KOEGlike/meko/hardware/cad/mekov3mockup.FCStd

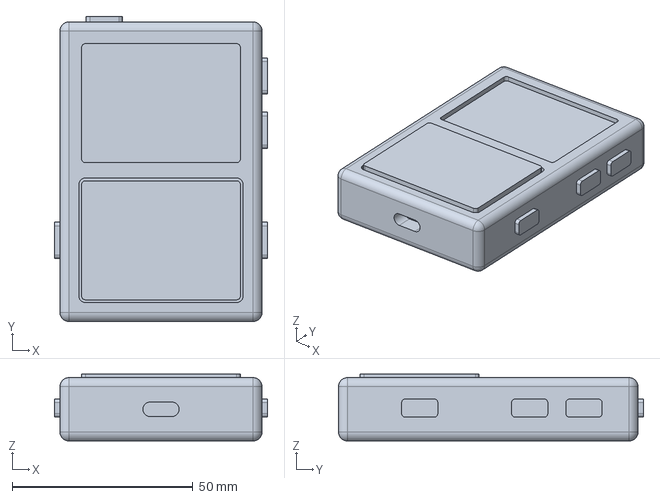
[picture p2: CAD file, 2026-11-12]
hardware/cad/mekov3mockup.FCStd
58.8 x 84.3 x 18.5 mm
