KOEGlike/meko/hardware/pcb_lib/ckl/TF-SMD_L14.8-W14.5-H1.9-P1.1.step

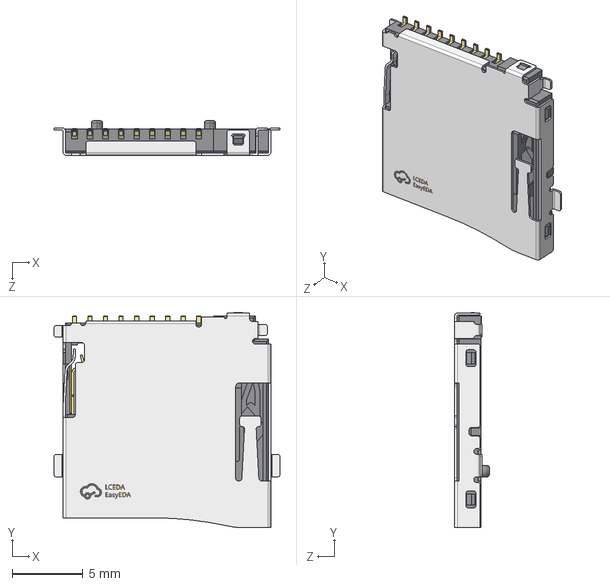
[picture p3: CAD file, 2026-09-19]
hardware/pcb_lib/ckl/TF-SMD_L14.8-W14.5-H1.9-P1.1.step
16.0 x 15.2 x 2.45 mm
