KOEGlike/meko/hardware/pcb_lib/ECMF02-2AMX6/ECMF02-2AMX6.stp

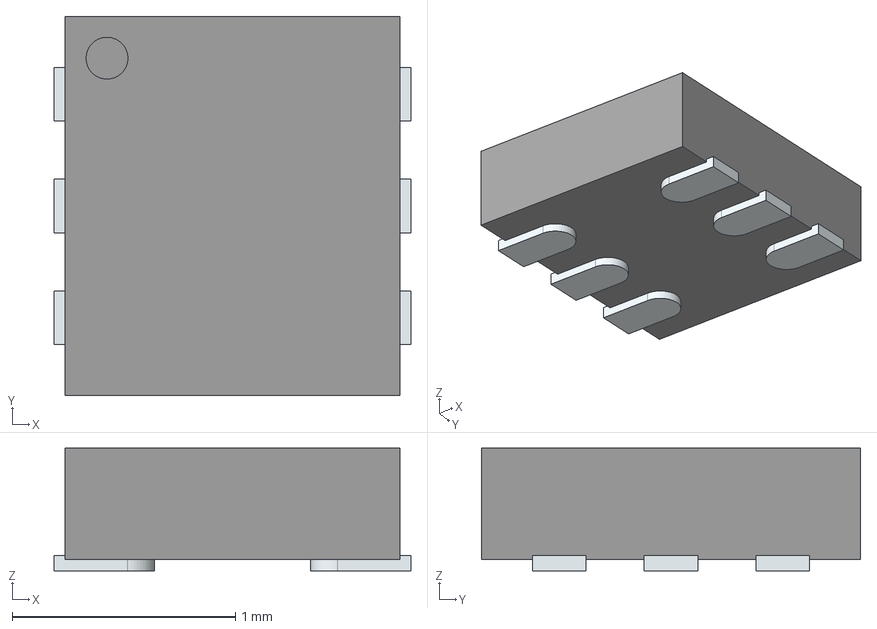
[picture p4: CAD file, 2026-09-22]
hardware/pcb_lib/ECMF02-2AMX6/ECMF02-2AMX6.stp
1.60 x 1.70 x 0.55 mm
PinsArrayLR
