KOEGlike/meko/hardware/pcb_lib/ESD441DPLR/ESD441DPLR.stp

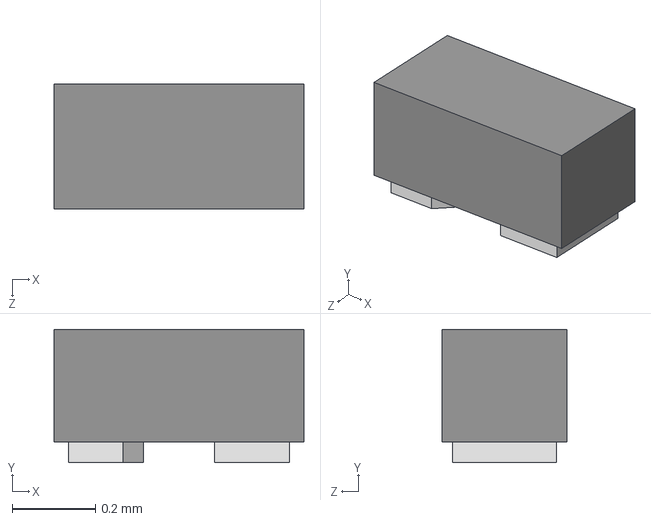
[picture p5: CAD file, 2026-08-08]
hardware/pcb_lib/ESD441DPLR/ESD441DPLR.stp
0.6 x 0.32 x 0.3 mm
