KOEGlike/meko/hardware/pcb_lib/K4E6E304EC-EGCG/FBGA-178_L11.5-W11.0_K4E6E304EC-TL.stp

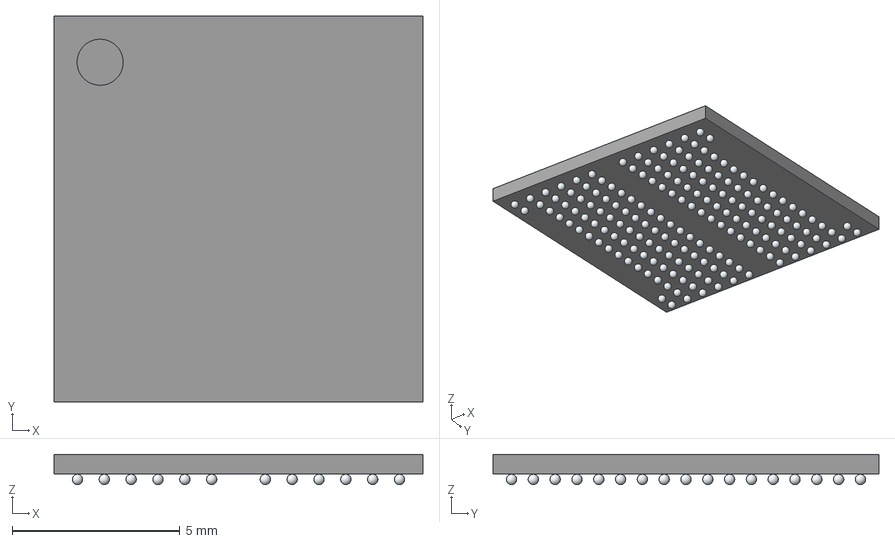
[picture p6: CAD file, 2026-07-20]
hardware/pcb_lib/K4E6E304EC-EGCG/FBGA-178_L11.5-W11.0_K4E6E304EC-TL.stp
11.0 x 11.5 x 0.9 mm
A1
A2
A3
A4
A5
A6
A8
A9
A10
A11
A12
A13
B1
B2
B3
B4
B5
B6
B8
B9
B10
B11
B12
B13
C2
C3
C4
C5
C6
C8
C9
C10
C11
C12
D2
D3
D4
D5
D6
D8
D9
D10
D11
D12
E2
E3
E4
E5
E6
E8
E9
E10
E11
E12
F2
F3
F4
F5
F6
F8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
