KOEGlike/meko/hardware/pcb_lib/LRA/LRA.step

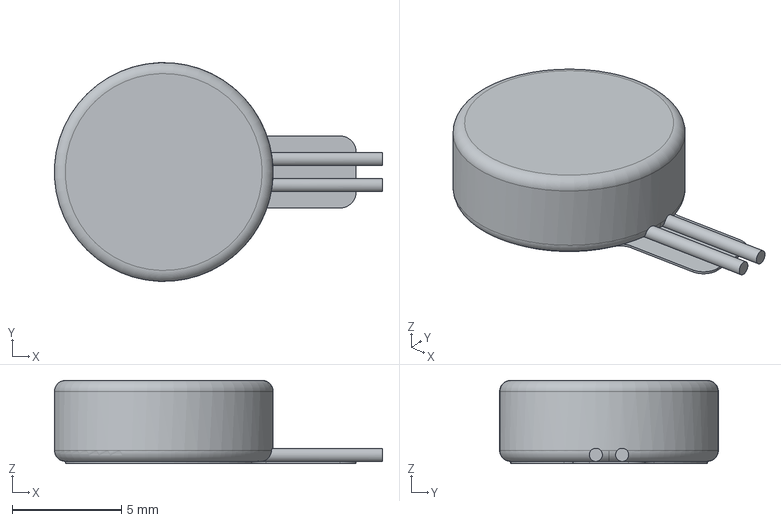
[picture p7: CAD file, 2026-09-26]
hardware/pcb_lib/LRA/LRA.step
15.0 x 10.00 x 3.80 mm
