KOEGlike/meko/hardware/pcb_lib/MAYA-W386-00B/MAYA-W3_Emb-ANT.step

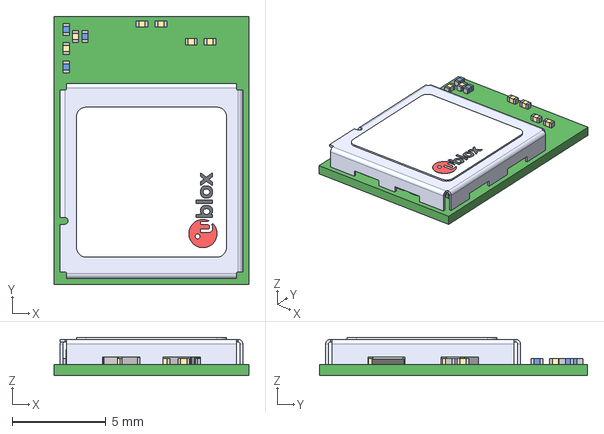
[picture p8: CAD file, 2026-08-22]
hardware/pcb_lib/MAYA-W386-00B/MAYA-W3_Emb-ANT.step
10.4 x 14.3 x 2.05 mm
