KOEGlike/meko/hardware/pcb_lib/MT41K256M16TW/FBGA-96_L14.0-W8.0-H1.1-P0.8.step

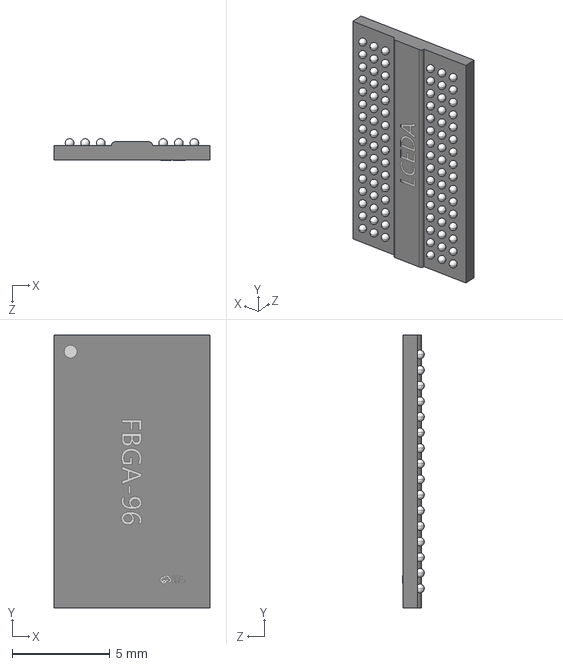
[picture p9: CAD file, 2026-09-19]
hardware/pcb_lib/MT41K256M16TW/FBGA-96_L14.0-W8.0-H1.1-P0.8.step
8.00 x 14.0 x 1.11 mm
