KOEGlike/meko/hardware/pcb_lib/PJ242/AUDIO-SMD_PJ-242_1.step

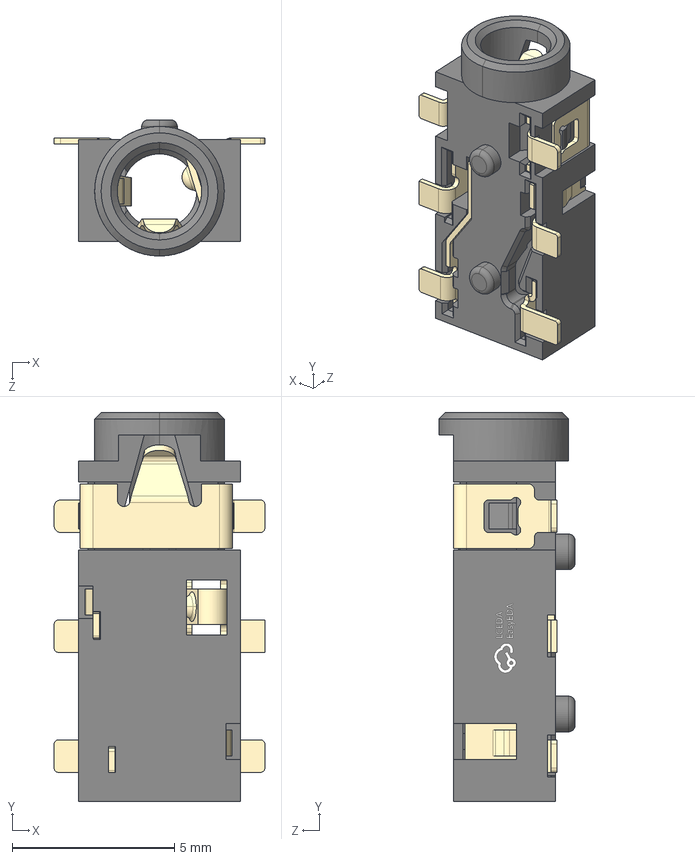
[picture p10: CAD file, 2026-09-17]
hardware/pcb_lib/PJ242/AUDIO-SMD_PJ-242_1.step
6.50 x 12.0 x 4.20 mm
