KOEGlike/meko/hardware/pcb_lib/SAMA7D65-4HB/Microchip_4HB_TFBGA-343_14x14mm_Layout21x21_P0.65mm.step

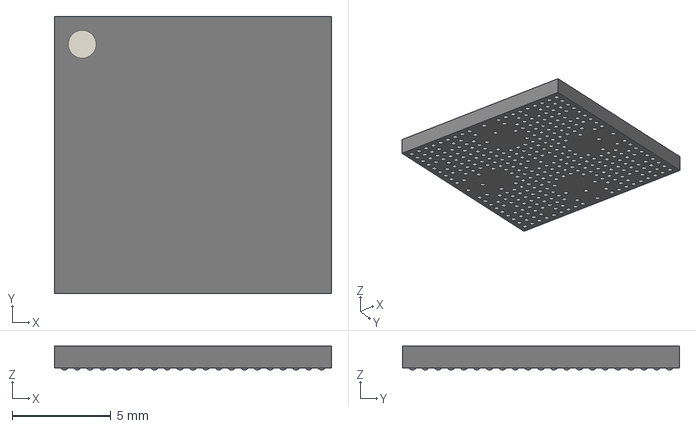
[picture p11: CAD file, 2026-07-15]
hardware/pcb_lib/SAMA7D65-4HB/Microchip_4HB_TFBGA-343_14x14mm_Layout21x21_P0.65mm.step
14.0 x 14.0 x 1.21 mm
