KOEGlike/meko/hardware/pcb_lib/SKRTLAE010/KEY-SMD_L4.6-W3.4-H3.4.step

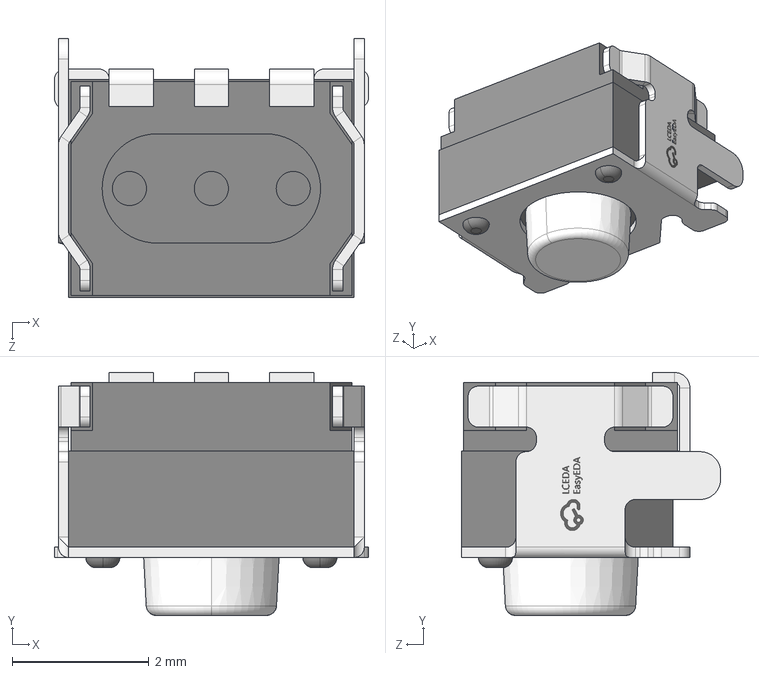
[picture p12: CAD file, 2026-09-17]
hardware/pcb_lib/SKRTLAE010/KEY-SMD_L4.6-W3.4-H3.4.step
4.60 x 3.56 x 3.80 mm
