KOEGlike/meko/hardware/pcb_lib/TPD2S300/TPD2S300YFFR.stp

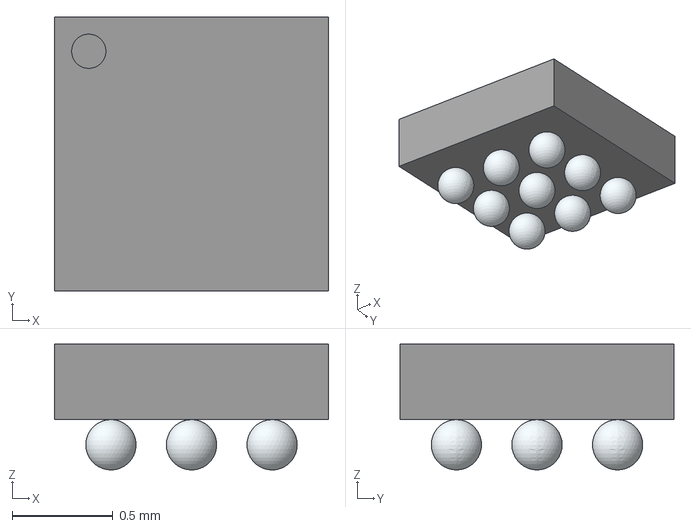
[picture p13: CAD file, 2026-08-08]
hardware/pcb_lib/TPD2S300/TPD2S300YFFR.stp
1.36 x 1.36 x 0.625 mm
