KOEGlike/meko/hardware/cad/touchpad.step

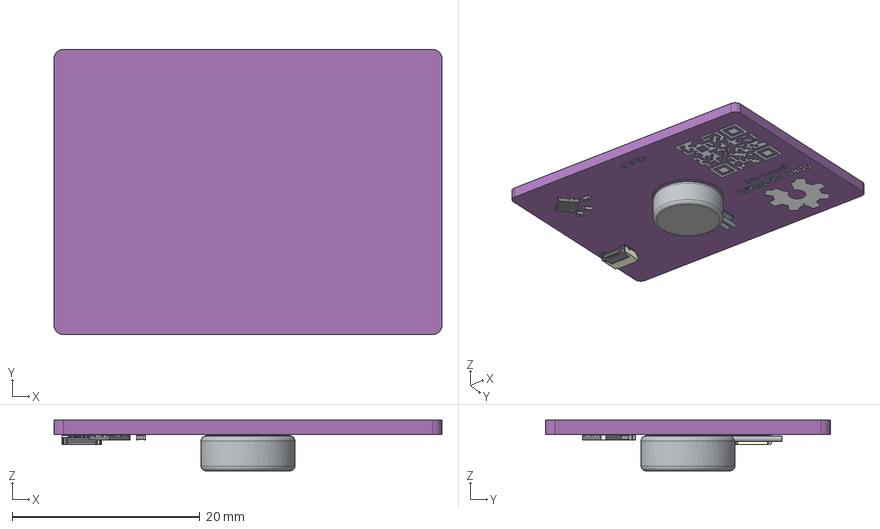
[picture p14: CAD file, 2026-11-12]
hardware/cad/touchpad.step
41.3 x 30.4 x 5.40 mm
UQFN-20-1EP_3x3mm_Pitch0.4mm
C_0402_1005Metric x 3
503480-xxxx_05
touchpad_silkscreen
touchpad_PCB
