KOEGlike/meko/hardware/pcb_lib/ckl/TF-SMD_TF-008.step

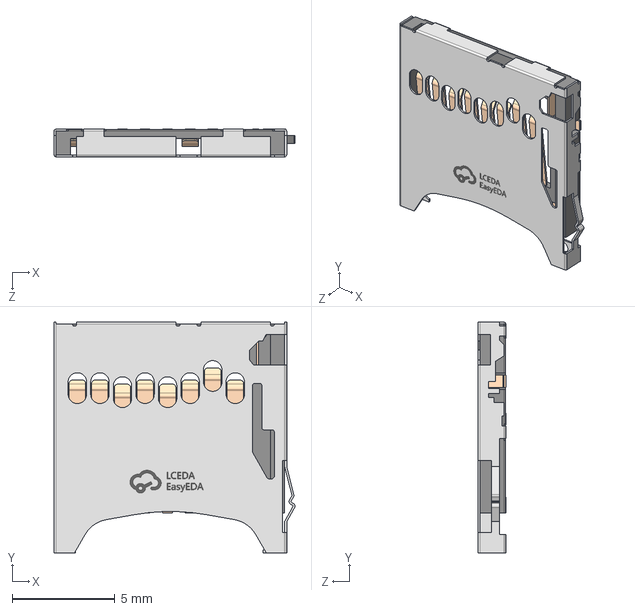
[picture p15: CAD file, 2026-09-19]
hardware/pcb_lib/ckl/TF-SMD_TF-008.step
11.7 x 11.3 x 1.35 mm
