KOEGlike/meko/hardware/pcb_lib/ckl/AUDIO-SMD_PJ-342-141.step

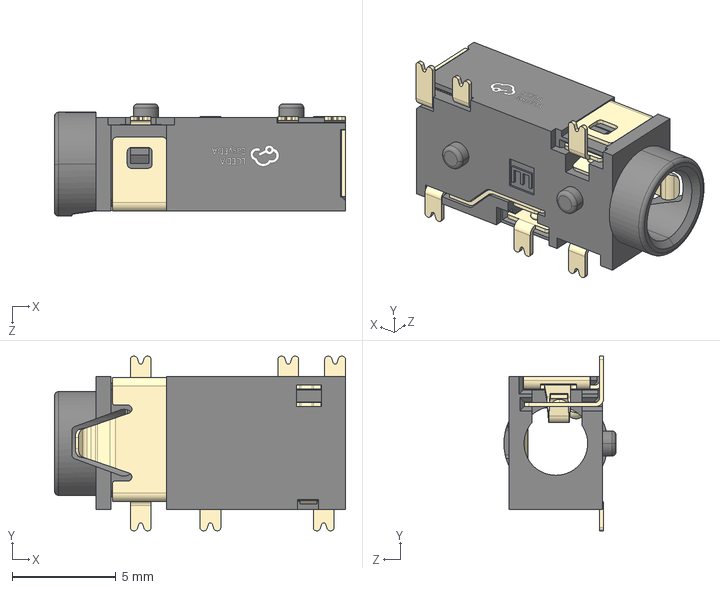
[picture p16: CAD file, 2026-09-18]
hardware/pcb_lib/ckl/AUDIO-SMD_PJ-342-141.step
14.0 x 8.40 x 5.40 mm
