KOEGlike/meko/hardware/pcb_lib/ckl/USB_C_Receptacle_HRO_TYPE-C-31-M-12.step

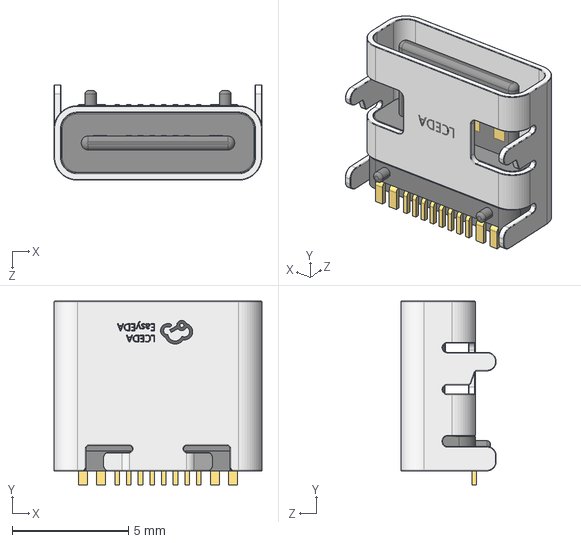
[picture p17: CAD file, 2026-09-18]
hardware/pcb_lib/ckl/USB_C_Receptacle_HRO_TYPE-C-31-M-12.step
8.94 x 7.90 x 4.10 mm
