KOEGlike/meko/hardware/pcb_lib/503480-0540/503480-0540.step

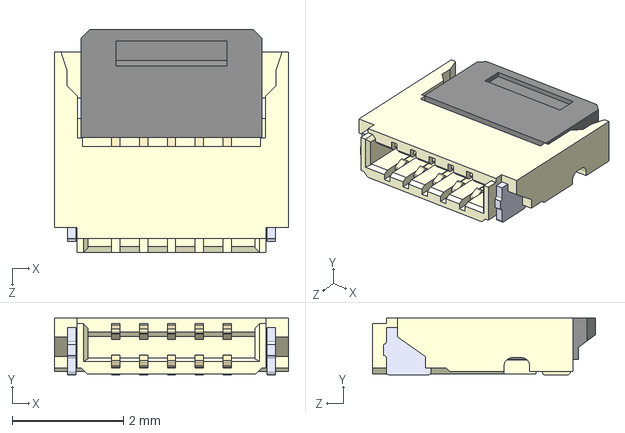
[picture p18: CAD file, 2026-09-20]
hardware/pcb_lib/503480-0540/503480-0540.step
4.20 x 1.02 x 4.00 mm
