KOEGlike/meko/(list of files, cad)

Other CAD files:
hardware/cad/meko.step
hardware/cad/meko.FCStd
hardware/mekov3mockup.FCStd
hardware/pcb_lib/503480-1000/5034801000_0.stp
hardware/pcb_lib/BQ25640/BQ25640VDLR.stp
hardware/pcb_lib/LRA/lra.FCStd
meko-blend/meko.blend
