KOEGlike/meko/hardware/pcb/meko.kicad_pcb

## KiCad design hardware/pcb/meko.kicad_pcb (2026-11-14)

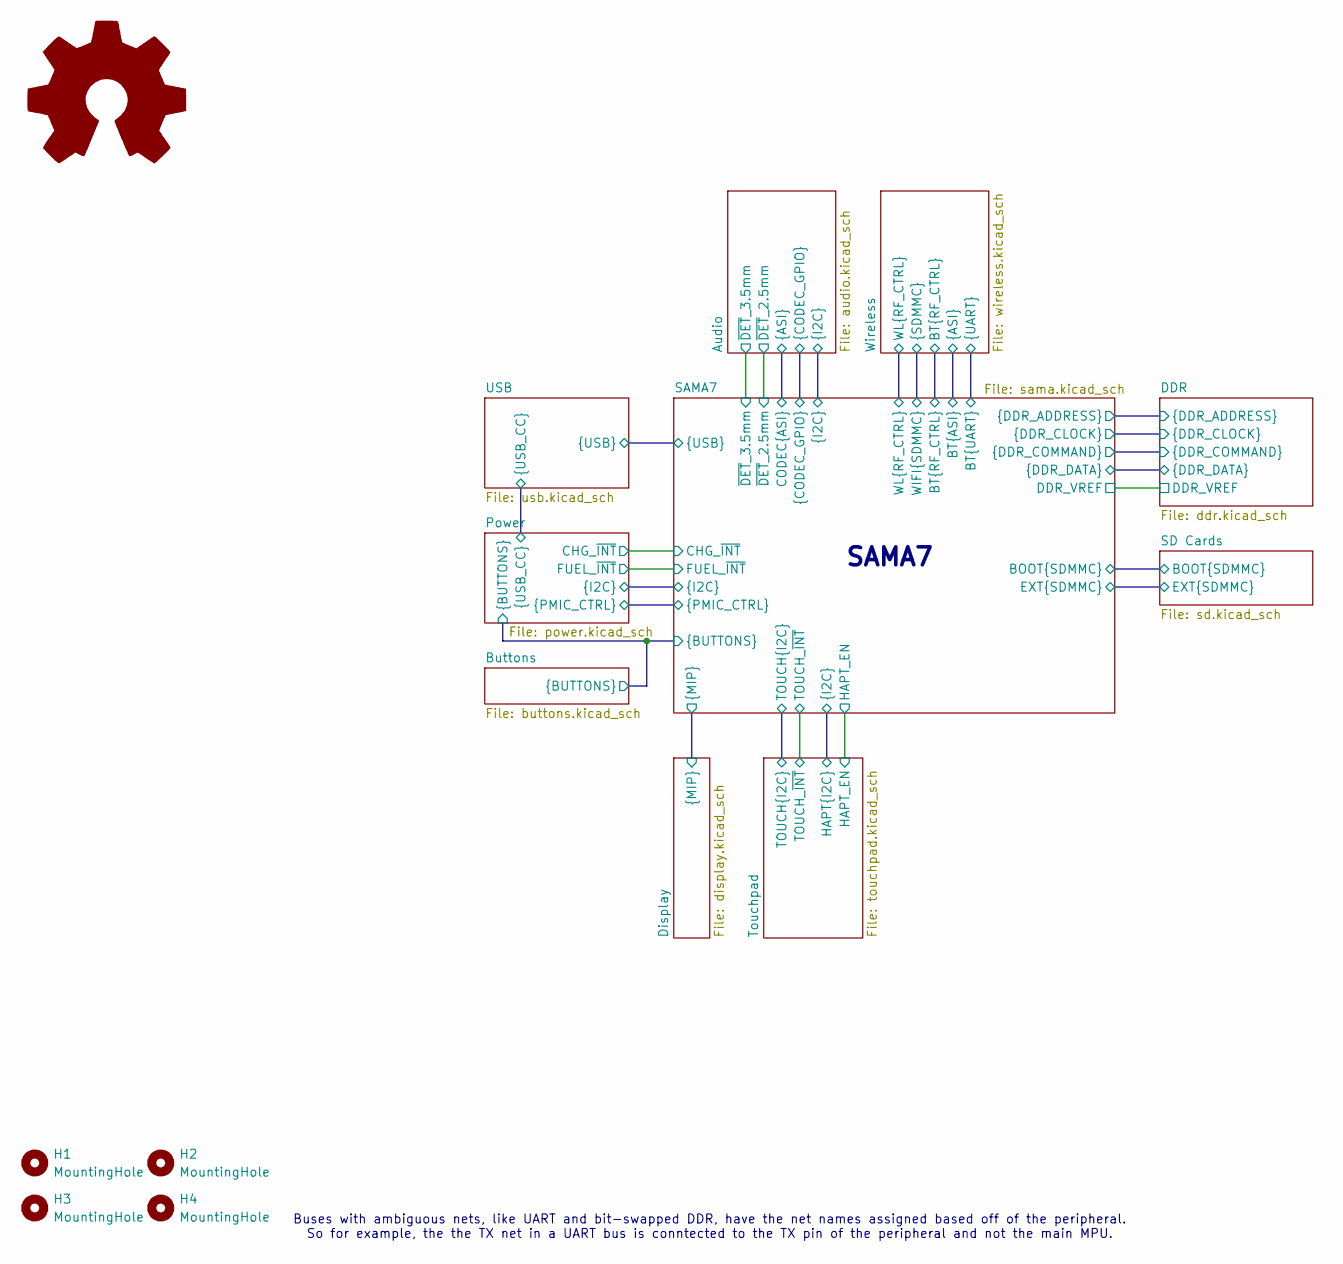
[picture p21: schematic meko.kicad_sch, Overview]

Parts:
H1, H2, H3, H4: MountingHole; MountingHole_2.2mm_M2
SYM1: Logo_Open_Hardware_Large; OSHW-Logo2_9.8x8mm_SilkScreen

Notes on the sheet:
Buses with ambiguous nets, like UART and bit-swapped DDR, have the net names assigned based off of the peripheral. So for example, the the TX net in a UART bus is conntected to the TX pin of the peripheral and not the main MPU.
SAMA7

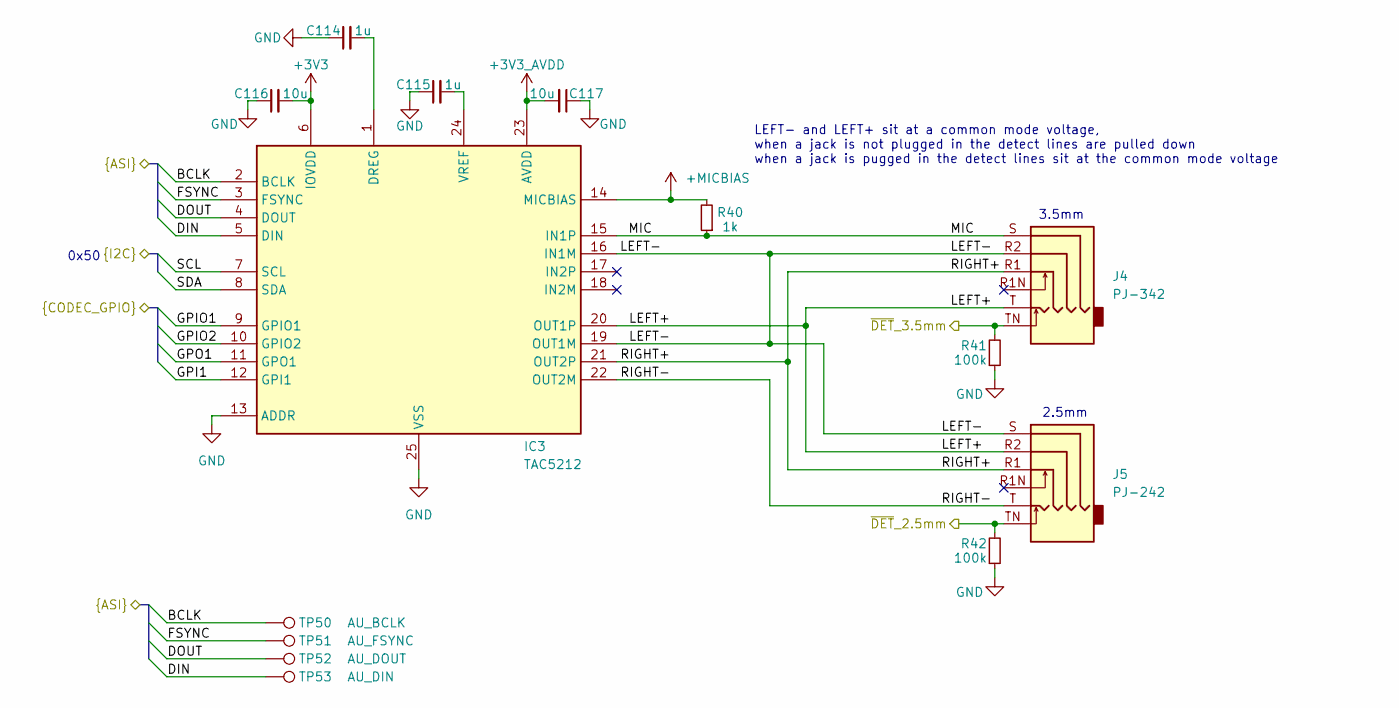
[picture p22: schematic audio.kicad_sch]

Parts:
C114, C115: 1u; C_0402_1005Metric
C116, C117: 10u; C_0402_1005Metric
IC3: TAC5212; VQFN-24-1EP_4x4mm_P0.5mm_EP2.45x2.45mm
J4: PJ-342; Jack_3.5mm_SHOUHAN_PJ-342; LCSC C668606
J5: PJ-242; Jack_2.5mm_PJ242_6P_12x6.2x4mm_Horizontal; LCSC C431536
R40: 1k; R_0402_1005Metric
R41, R42: 100k; R_0402_1005Metric
TP50: AU_BCLK; TestPoint_Pad_D1.0mm
TP51: AU_FSYNC; TestPoint_Pad_D1.0mm
TP52: AU_DOUT; TestPoint_Pad_D1.0mm
TP53: AU_DIN; TestPoint_Pad_D1.0mm

Connections:
+3V3: C116.2, IC3.6 (IOVDD); also elsewhere on the board
+3V3_AVDD: C117.2, IC3.23 (AVDD); also elsewhere on the board
+MICBIAS: IC3.14 (MICBIAS), R40.2
/Audio/BCLK: IC3.2 (BCLK), TP50.1 (1_1); also elsewhere on the board
/Audio/DIN: IC3.5 (DIN), TP53.1 (1_1); also elsewhere on the board
/Audio/DOUT: IC3.4 (DOUT), TP52.1 (1_1); also elsewhere on the board
/Audio/FSYNC: IC3.3 (FSYNC), TP51.1 (1_1); also elsewhere on the board
/Audio/GPI1: IC3.12 (GPI1); also elsewhere on the board
/Audio/GPIO1: IC3.9 (GPIO1); also elsewhere on the board
/Audio/GPIO2: IC3.10 (GPIO2); also elsewhere on the board
/Audio/GPO1: IC3.11 (GPO1); also elsewhere on the board
/Audio/LEFT+: IC3.20 (OUT1P), J4.T, J5.R2
/Audio/LEFT-: IC3.16 (IN1M), IC3.19 (OUT1M), J4.R2, J5.S
/Audio/MIC: IC3.15 (IN1P), J4.S, R40.1
/Audio/RIGHT+: IC3.21 (OUT2P), J4.R1, J5.R1
/Audio/RIGHT-: IC3.22 (OUT2M), J5.T
/Audio/SCL: IC3.7 (SCL); also elsewhere on the board
/Audio/SDA: IC3.8 (SDA); also elsewhere on the board
/Audio/~DET_2.5mm: J5.TN, R42.2; also elsewhere on the board
/Audio/~DET_3.5mm: J4.TN, R41.2; also elsewhere on the board
GND: C114.1, C115.1, C116.1, C117.1, IC3.13 (ADDR), IC3.25 (VSS), R41.1, R42.1; also elsewhere on the board
unnamed: C114.2, IC3.1 (DREG)
unnamed: C115.2, IC3.24 (VREF)

Notes on the sheet:
3.5mm
LEFT- and LEFT+ sit at a common mode voltage, when a jack is not plugged in the detect lines are pulled down when a jack is pugged in the detect lines sit at the common mode voltage
2.5mm
0x50

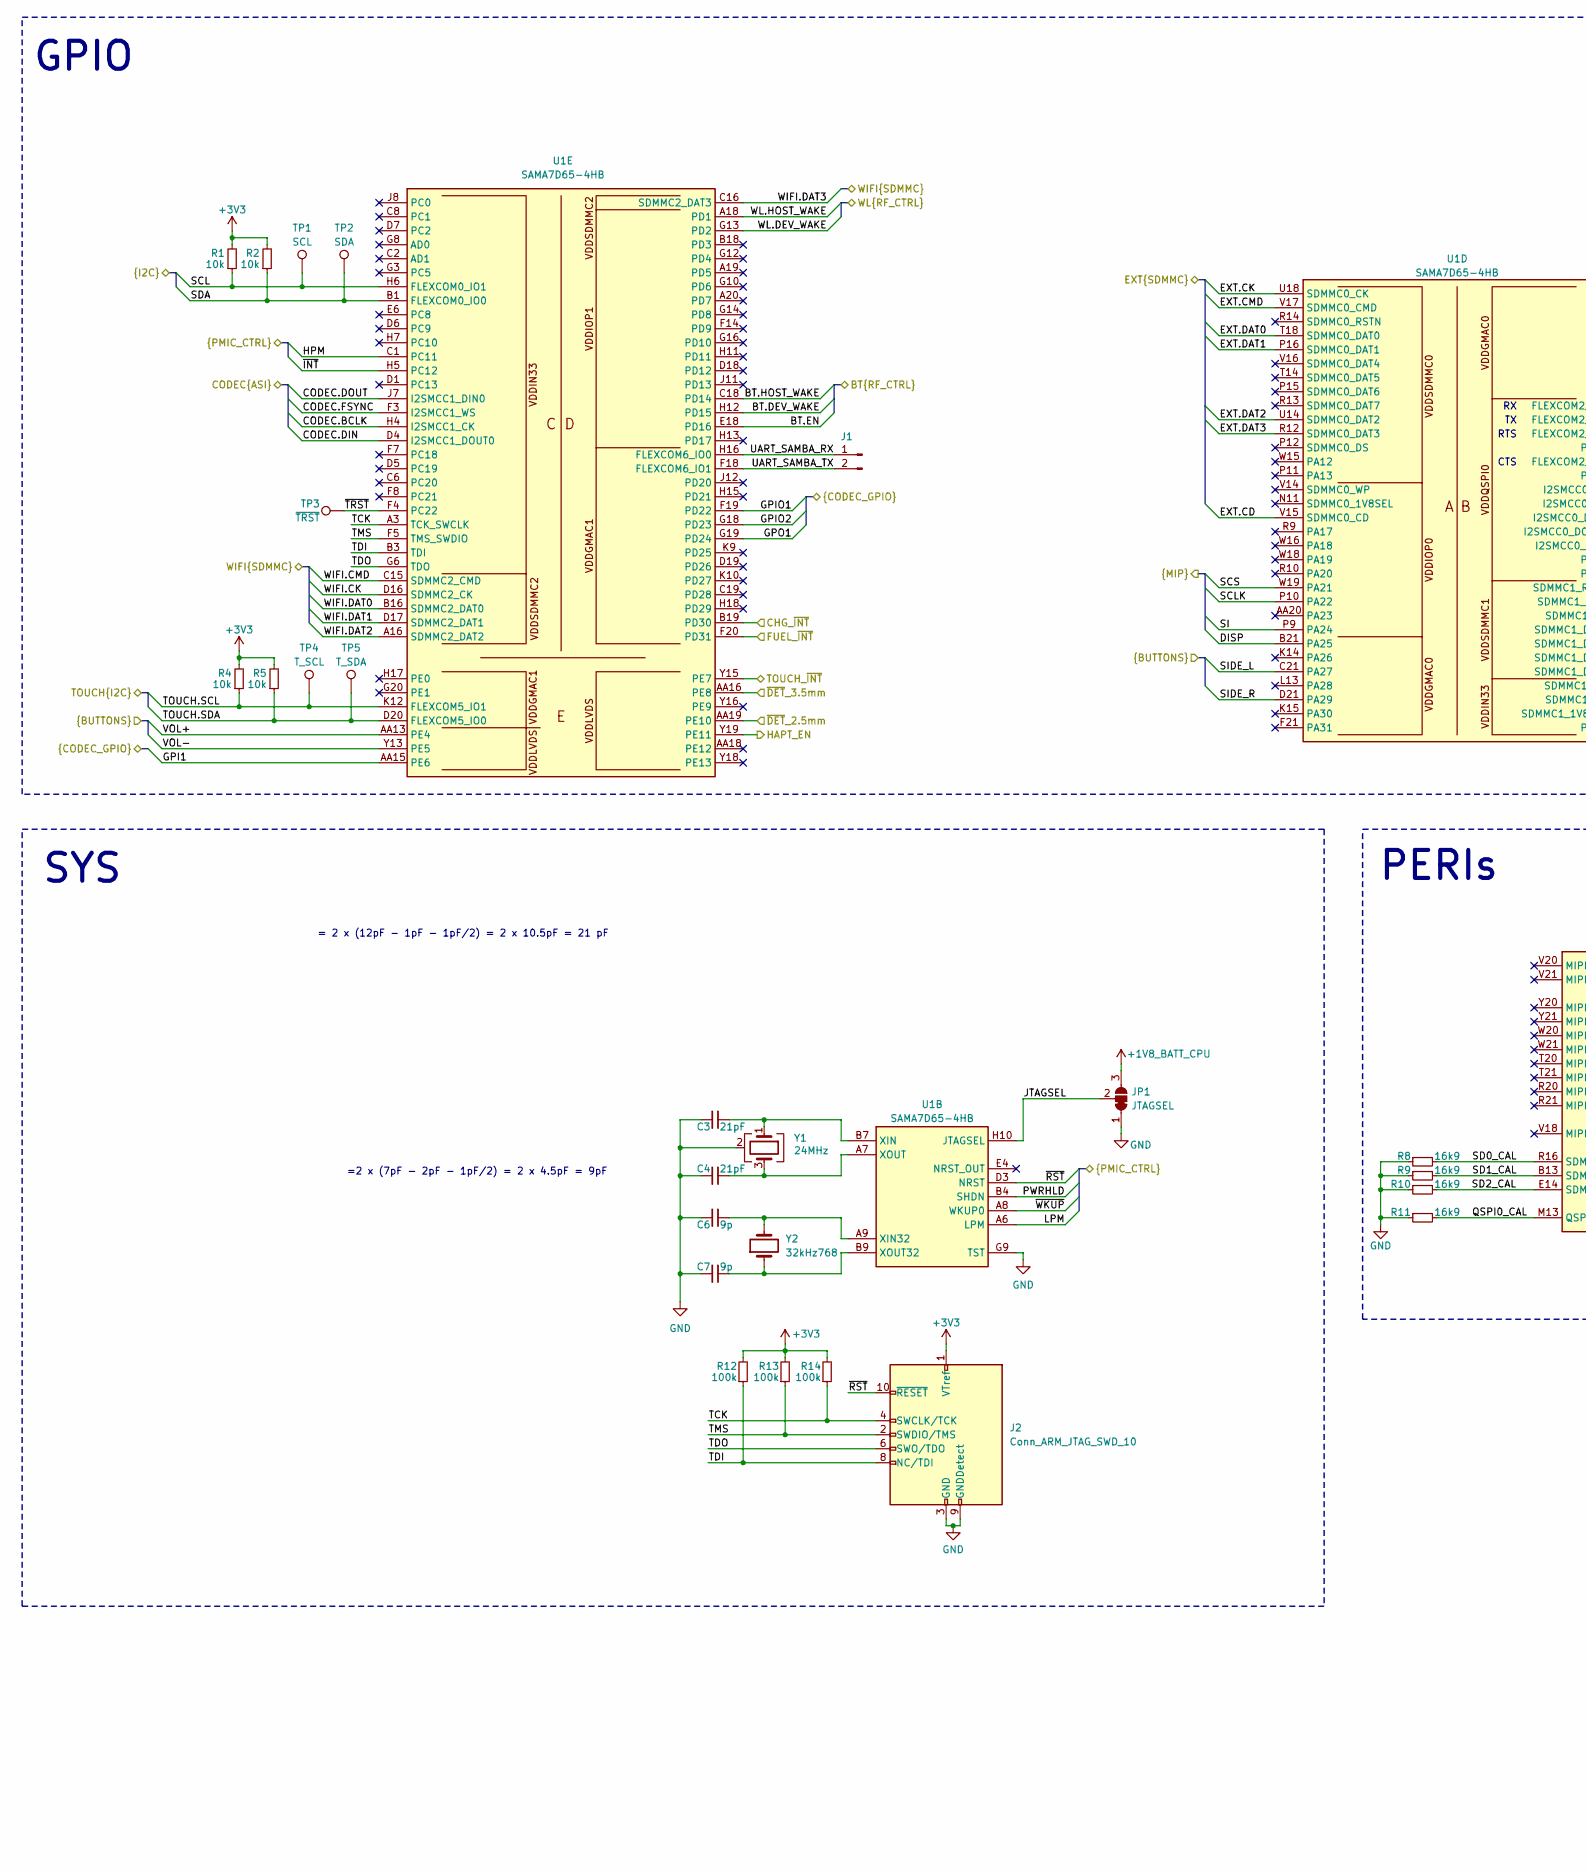
[picture p23: schematic sama.kicad_sch, SAMA7, part in row 1, column 1]

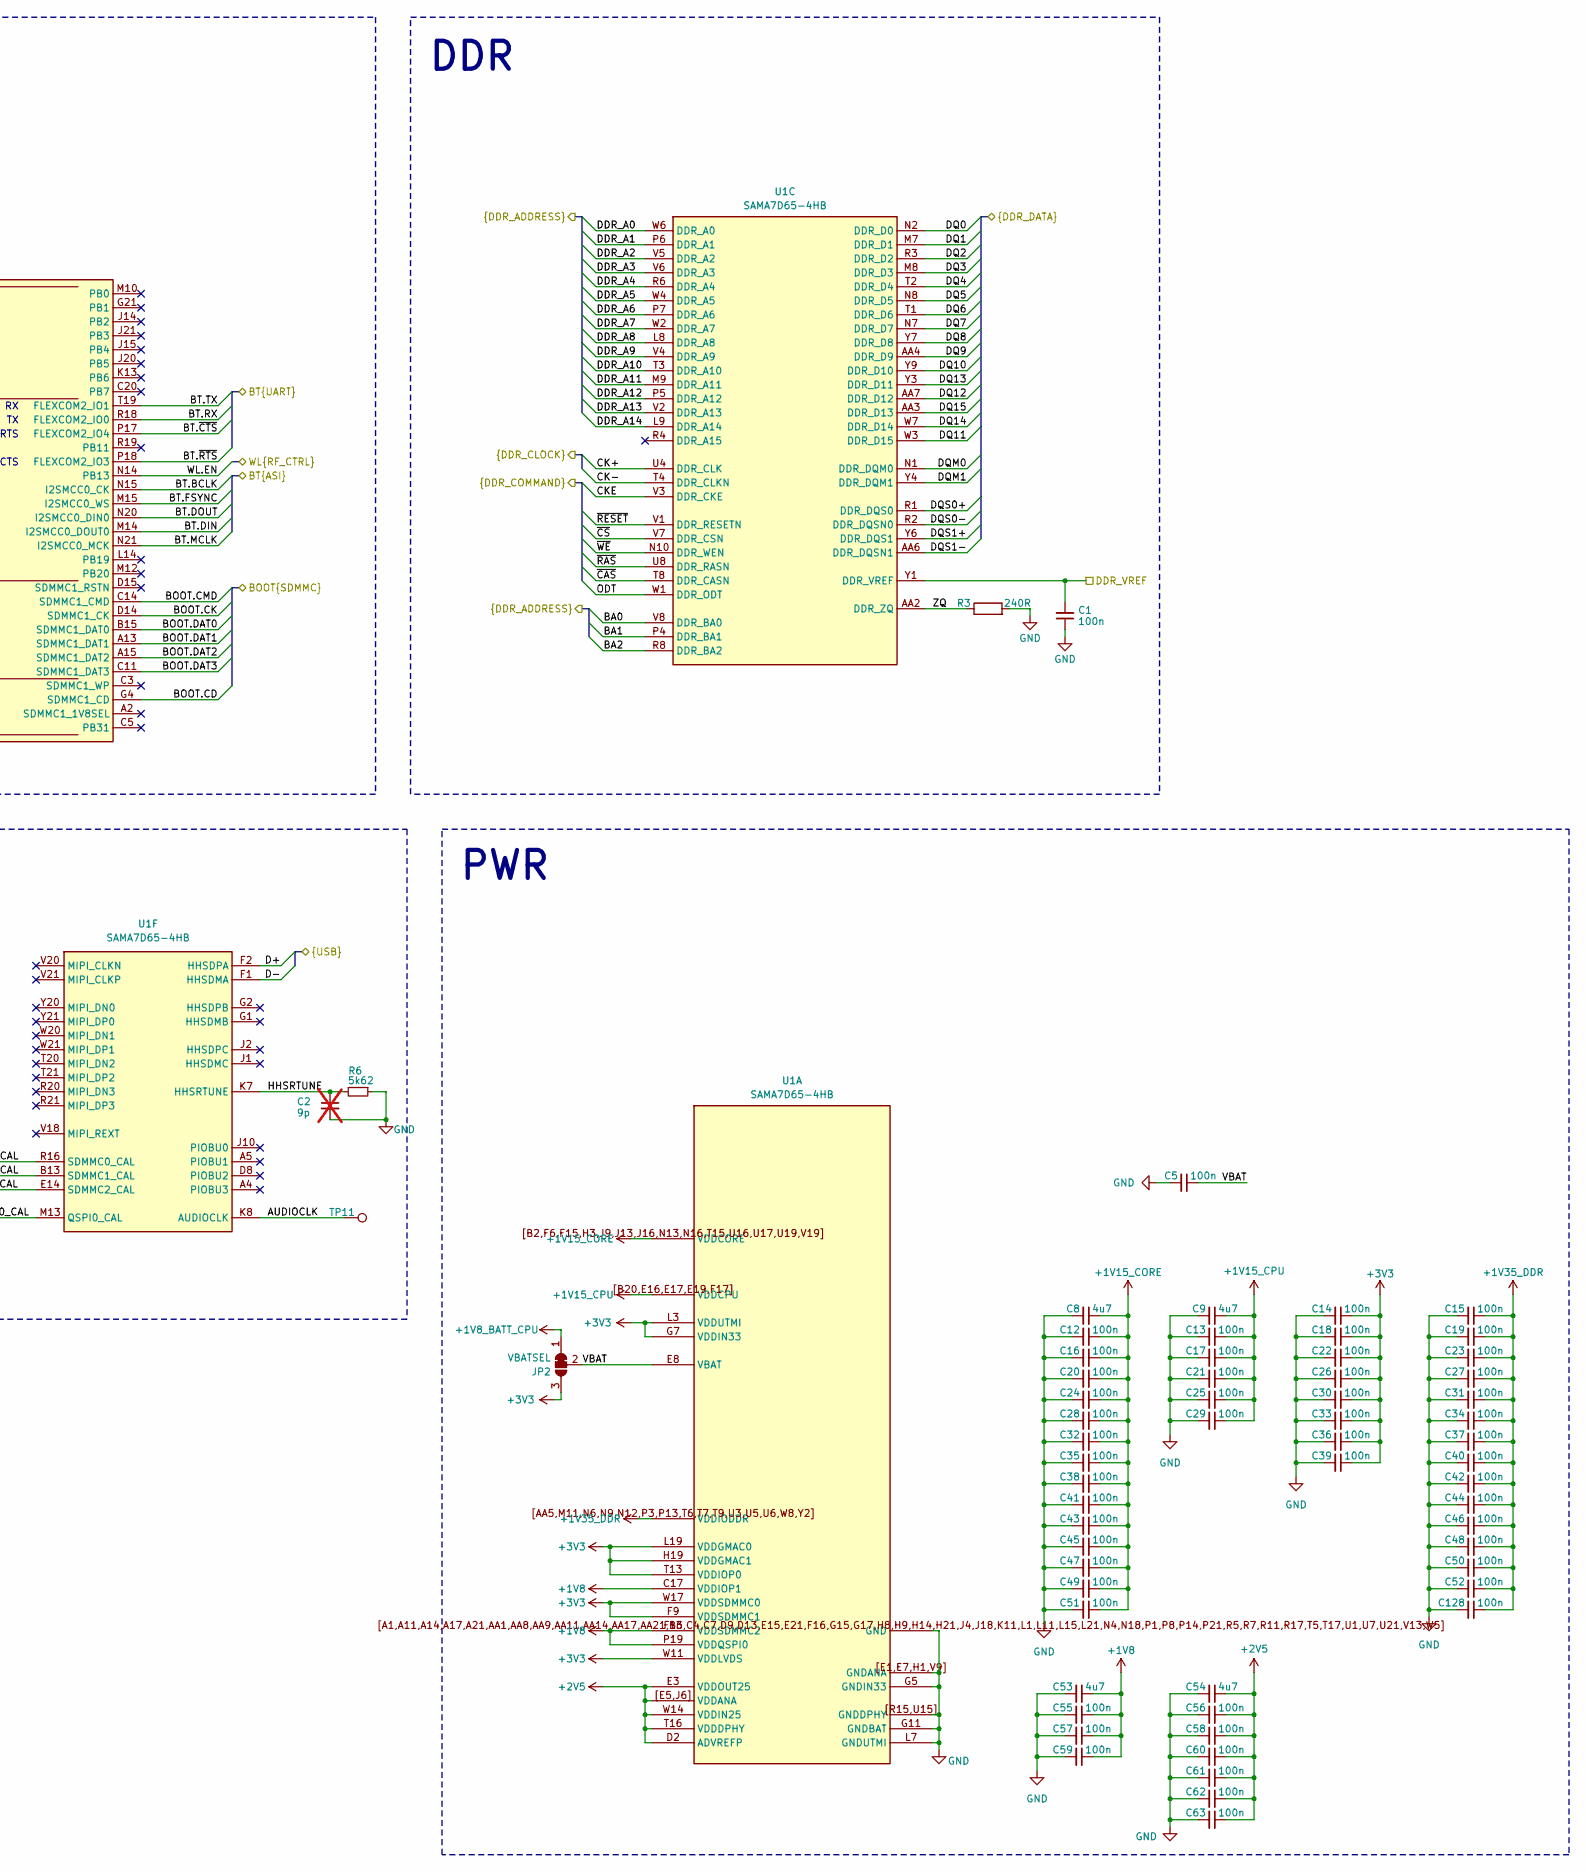
[picture p24: schematic sama.kicad_sch, SAMA7, part in row 1, column 2]

Parts:
C1, C12, C15, C16, C18, C19, C20, C21, C22, C26, C28, C29, C30, C31, C39, C40, C43, C44, C46, C48, C51, C55, C56, C57, C59, C60, C62, C63, C128: 100n; C_0201_0603Metric
C2: 9p; C_0201_0603Metric; not fitted
C3, C4: 21pF; C_0201_0603Metric
C5, C13, C14, C17, C23, C24, C25, C27, C32, C33, C34, C35, C36, C37, C38, C41, C42, C45, C47, C49, C50, C52, C58, C61: 100n; C_0201_0603Metric_Dense
C6, C7: 9p; C_0201_0603Metric
C8, C9, C53, C54: 4u7; C_0402_1005Metric
J1: Conn_01x02_Pin; PinHeader_1x02_P2.54mm_Vertical
J2: Conn_ARM_JTAG_SWD_10; PinHeader_2x05_P1.27mm_Vertical
JP1: JTAGSEL; SolderJumper-3_P1.3mm_Bridged12_RoundedPad1.0x1.5mm
JP2: VBATSEL; SolderJumper-3_P1.3mm_Bridged12_RoundedPad1.0x1.5mm
R1, R2, R4, R5: 10k; R_0402_1005Metric
R3: 240R; R_0201_0603Metric
R6: 5k62; R_0201_0603Metric
R8, R9, R10, R11: 16k9; R_0201_0603Metric
R12, R13, R14: 100k; R_0402_1005Metric
TP1: SCL; TestPoint_Pad_D1.0mm
TP2: SDA; TestPoint_Pad_D1.0mm
TP3: ~{TRST}; TestPoint_Pad_D1.0mm
TP4: T_SCL; TestPoint_Pad_D1.0mm
TP5: T_SDA; TestPoint_Pad_D1.0mm
TP11: AUDIOCLK; TestPoint_Pad_D1.0mm
U1: SAMA7D65-4HB; Microchip_4HB_TFBGA-343_14x14mm_Layout21x21_P0.65mm
Y1: 24MHz; Crystal_SMD_3225-4Pin_3.2x2.5mm; MPN SX32Y024000BC1T001; LCSC C7420736
Y2: 32kHz768; Crystal_SMD_MicroCrystal_CC7V-T1A-2Pin_3.2x1.5mm; MPN SC-32S32.768kHz20PPM7pF

Connections:
+1V8: C53.1, C55.1, C57.1, C59.1, U1.C17 (VDDIOP1), U1.F13 (VDDSDMMC2), U1.P19 (VDDQSPI0); also elsewhere on the board
+1V8_BATT_CPU: JP1.3 (B), JP2.1 (A); also elsewhere on the board
+1V15_CORE: C8.1, C12.1, C16.1, C20.1, C24.1, C28.1, C32.1, C35.1, C38.1, C41.1, C43.1, C45.1, C47.1, C49.1, C51.1, U1.B2 (VDDCORE), U1.F6 (VDDCORE), U1.F15 (VDDCORE), U1.H3 (VDDCORE), U1.J9 (VDDCORE), U1.J13 (VDDCORE), U1.J16 (VDDCORE), U1.N13 (VDDCORE), U1.N16 (VDDCORE), U1.T15 (VDDCORE), U1.U16 (VDDCORE), U1.U17 (VDDCORE), U1.U19 (VDDCORE), U1.V19 (VDDCORE), U1.[B2,F6,F15,H3,J9,J1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 (VDDCORE); also elsewhere on the board
+1V15_CPU: C9.1, C13.1, C17.1, C21.1, C25.1, C29.1, U1.B20 (VDDCPU), U1.E16 (VDDCPU), U1.E17 (VDDCPU), U1.E19 (VDDCPU), U1.F17 (VDDCPU), U1.[B20,E16,E17,E19,F1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 (VDDCPU); also elsewhere on the board
+1V35_DDR: C15.1, C19.1, C23.1, C27.1, C31.1, C34.1, C37.1, C40.1, C42.1, C44.1, C46.1, C48.1, C50.1, C52.1, C128.1, U1.AA5 (VDDIODDR), U1.M11 (VDDIODDR), U1.N6 (VDDIODDR), U1.N9 (VDDIODDR), U1.N12 (VDDIODDR), U1.P3 (VDDIODDR), U1.P13 (VDDIODDR), U1.T6 (VDDIODDR), U1.T7 (VDDIODDR), U1.T9 (VDDIODDR), U1.U3 (VDDIODDR), U1.U5 (VDDIODDR), U1.U6 (VDDIODDR), U1.W8 (VDDIODDR), U1.Y2 (VDDIODDR), U1.[AA5,M11,N6,N9,N12,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 (VDDIODDR); also elsewhere on the board
+2V5: C54.1, C56.1, C58.1, C60.1, C61.1, C62.1, C63.1, U1.D2 (ADVREFP), U1.E3 (VDDOUT25), U1.E5 (VDDANA), U1.J6 (VDDANA), U1.T16 (VDDDPHY), U1.W14 (VDDIN25), U1.[E5,J6] (VDDANA)
+3V3: C14.1, C18.1, C22.1, C26.1, C30.1, C33.1, C36.1, C39.1, J2.1 (VTref), JP2.3 (B), R1.2, R2.2, R4.2, R5.2, R12.2, R13.2, R14.2, U1.F9 (VDDSDMMC1), U1.G7 (VDDIN33), U1.H19 (VDDGMAC1), U1.L3 (VDDUTMI), U1.L19 (VDDGMAC0), U1.T13 (VDDIOP0), U1.W11 (VDDLVDS), U1.W17 (VDDSDMMC0); also elsewhere on the board
/Audio/BCLK: U1.H4 (I2SMCC1_CK); also elsewhere on the board
/Audio/DIN: U1.D4 (I2SMCC1_DOUT0); also elsewhere on the board
/Audio/DOUT: U1.J7 (I2SMCC1_DIN0); also elsewhere on the board
/Audio/FSYNC: U1.F3 (I2SMCC1_WS); also elsewhere on the board
/Audio/GPI1: U1.AA15 (PE6); also elsewhere on the board
/Audio/GPIO1: U1.F19 (PD22); also elsewhere on the board
/Audio/GPIO2: U1.G18 (PD23); also elsewhere on the board
/Audio/GPO1: U1.G19 (PD24); also elsewhere on the board
/Audio/SCL: R1.1, TP1.1 (1_1), U1.H6 (FLEXCOM0_IO1); also elsewhere on the board
/Audio/SDA: R2.1, TP2.1 (1_1), U1.B1 (FLEXCOM0_IO0); also elsewhere on the board
/Audio/~DET_2.5mm: U1.AA19 (PE10); also elsewhere on the board
/Audio/~DET_3.5mm: U1.AA16 (PE8); also elsewhere on the board
/Buttons/SIDE_L: U1.C21 (PA27); also elsewhere on the board
/Buttons/SIDE_R: U1.D21 (PA29); also elsewhere on the board
/Buttons/VOL+: U1.AA13 (PE4); also elsewhere on the board
/Buttons/VOL-: U1.Y13 (PE5); also elsewhere on the board
/DDR/BA0: U1.V8 (DDR_BA0); also elsewhere on the board
/DDR/BA1: U1.P4 (DDR_BA1); also elsewhere on the board
/DDR/BA2: U1.R8 (DDR_BA2); also elsewhere on the board
/DDR/CK+: U1.U4 (DDR_CLK); also elsewhere on the board
/DDR/CK-: U1.T4 (DDR_CLKN); also elsewhere on the board
/DDR/CKE: U1.V3 (DDR_CKE); also elsewhere on the board
/DDR/DDR_A0: U1.W6 (DDR_A0); also elsewhere on the board
/DDR/DDR_A1: U1.P6 (DDR_A1); also elsewhere on the board
/DDR/DDR_A2: U1.V5 (DDR_A2); also elsewhere on the board
/DDR/DDR_A3: U1.V6 (DDR_A3); also elsewhere on the board
/DDR/DDR_A4: U1.R6 (DDR_A4); also elsewhere on the board
/DDR/DDR_A5: U1.W4 (DDR_A5); also elsewhere on the board
/DDR/DDR_A6: U1.P7 (DDR_A6); also elsewhere on the board
/DDR/DDR_A7: U1.W2 (DDR_A7); also elsewhere on the board
/DDR/DDR_A8: U1.L8 (DDR_A8); also elsewhere on the board
/DDR/DDR_A9: U1.V4 (DDR_A9); also elsewhere on the board
/DDR/DDR_A10: U1.T3 (DDR_A10); also elsewhere on the board
/DDR/DDR_A11: U1.M9 (DDR_A11); also elsewhere on the board
/DDR/DDR_A12: U1.P5 (DDR_A12); also elsewhere on the board
/DDR/DDR_A13: U1.V2 (DDR_A13); also elsewhere on the board
/DDR/DDR_A14: U1.L9 (DDR_A14); also elsewhere on the board
/DDR/DDR_VREF: C1.2, U1.Y1 (DDR_VREF); also elsewhere on the board
/DDR/DQ0: U1.N2 (DDR_D0); also elsewhere on the board
/DDR/DQ1: U1.M7 (DDR_D1); also elsewhere on the board
/DDR/DQ2: U1.R3 (DDR_D2); also elsewhere on the board
/DDR/DQ3: U1.M8 (DDR_D3); also elsewhere on the board
/DDR/DQ4: U1.T2 (DDR_D4); also elsewhere on the board
/DDR/DQ5: U1.N8 (DDR_D5); also elsewhere on the board
/DDR/DQ6: U1.T1 (DDR_D6); also elsewhere on the board
/DDR/DQ7: U1.N7 (DDR_D7); also elsewhere on the board
/DDR/DQ8: U1.Y7 (DDR_D8); also elsewhere on the board
/DDR/DQ9: U1.AA4 (DDR_D9); also elsewhere on the board
/DDR/DQ10: U1.Y9 (DDR_D10); also elsewhere on the board
/DDR/DQ11: U1.W3 (DDR_D15); also elsewhere on the board
/DDR/DQ12: U1.AA7 (DDR_D12); also elsewhere on the board
/DDR/DQ13: U1.Y3 (DDR_D11); also elsewhere on the board
/DDR/DQ14: U1.W7 (DDR_D14); also elsewhere on the board
/DDR/DQ15: U1.AA3 (DDR_D13); also elsewhere on the board
/DDR/DQM0: U1.N1 (DDR_DQM0); also elsewhere on the board
/DDR/DQM1: U1.Y4 (DDR_DQM1); also elsewhere on the board
/DDR/DQS0+: U1.R1 (DDR_DQS0); also elsewhere on the board
/DDR/DQS0-: U1.R2 (DDR_DQSN0); also elsewhere on the board
/DDR/DQS1+: U1.Y6 (DDR_DQS1); also elsewhere on the board
/DDR/DQS1-: U1.AA6 (DDR_DQSN1); also elsewhere on the board
/DDR/ODT: U1.W1 (DDR_ODT); also elsewhere on the board
/DDR/~CAS: U1.T8 (DDR_CASN); also elsewhere on the board
/DDR/~CS: U1.V7 (DDR_CSN); also elsewhere on the board
/DDR/~RAS: U1.U8 (DDR_RASN); also elsewhere on the board
/DDR/~RESET: U1.V1 (DDR_RESETN); also elsewhere on the board
/DDR/~WE: U1.N10 (DDR_WEN); also elsewhere on the board
/Display/DISP: U1.B21 (PA25); also elsewhere on the board
/Display/SCLK: U1.P10 (PA22); also elsewhere on the board
/Display/SCS: U1.W19 (PA21); also elsewhere on the board
/Display/SI: U1.P9 (PA24); also elsewhere on the board
/Power/CHG_~INT: U1.B19 (PD30); also elsewhere on the board
/Power/FUEL_~INT: U1.F20 (PD31); also elsewhere on the board
/Power/HPM: U1.C1 (PC11); also elsewhere on the board
/Power/LPM: U1.A6 (LPM); also elsewhere on the board
/Power/PWRHLD: U1.B4 (SHDN); also elsewhere on the board
/Power/~INT: U1.H5 (PC12); also elsewhere on the board
/Power/~RST: J2.10 (~RESET), U1.D3 (NRST); also elsewhere on the board
/Power/~WKUP: U1.A8 (WKUP0); also elsewhere on the board
/SAMA7/AUDIOCLK: TP11.1 (1_1), U1.K8 (AUDIOCLK)
/SAMA7/BOOT.CD: U1.G4 (SDMMC1_CD); also elsewhere on the board
/SAMA7/BOOT.CK: U1.D14 (SDMMC1_CK); also elsewhere on the board
/SAMA7/BOOT.CMD: U1.C14 (SDMMC1_CMD); also elsewhere on the board
/SAMA7/BOOT.DAT0: U1.B15 (SDMMC1_DAT0); also elsewhere on the board
/SAMA7/BOOT.DAT1: U1.A13 (SDMMC1_DAT1); also elsewhere on the board
/SAMA7/BOOT.DAT2: U1.A15 (SDMMC1_DAT2); also elsewhere on the board
/SAMA7/BOOT.DAT3: U1.C11 (SDMMC1_DAT3); also elsewhere on the board
/SAMA7/BT.BCLK: U1.N15 (I2SMCC0_CK); also elsewhere on the board
/SAMA7/BT.DEV_WAKE: U1.H12 (PD15); also elsewhere on the board
/SAMA7/BT.DIN: U1.M14 (I2SMCC0_DOUT0); also elsewhere on the board
/SAMA7/BT.DOUT: U1.N20 (I2SMCC0_DIN0); also elsewhere on the board
/SAMA7/BT.EN: U1.E18 (PD16); also elsewhere on the board
/SAMA7/BT.FSYNC: U1.M15 (I2SMCC0_WS); also elsewhere on the board
/SAMA7/BT.HOST_WAKE: U1.C18 (PD14); also elsewhere on the board
/SAMA7/BT.MCLK: U1.N21 (I2SMCC0_MCK); also elsewhere on the board
/SAMA7/BT.RX: U1.R18 (FLEXCOM2_IO0); also elsewhere on the board
/SAMA7/BT.TX: U1.T19 (FLEXCOM2_IO1); also elsewhere on the board
/SAMA7/BT.~CTS: U1.P17 (FLEXCOM2_IO4); also elsewhere on the board
/SAMA7/BT.~RTS: U1.P18 (FLEXCOM2_IO3); also elsewhere on the board
/SAMA7/D+: U1.F2 (HHSDPA); also elsewhere on the board
/SAMA7/D-: U1.F1 (HHSDMA); also elsewhere on the board
/SAMA7/EXT.CD: U1.V15 (SDMMC0_CD); also elsewhere on the board
/SAMA7/EXT.CK: U1.U18 (SDMMC0_CK); also elsewhere on the board
/SAMA7/EXT.CMD: U1.V17 (SDMMC0_CMD); also elsewhere on the board
/SAMA7/EXT.DAT0: U1.T18 (SDMMC0_DAT0); also elsewhere on the board
/SAMA7/EXT.DAT1: U1.P16 (SDMMC0_DAT1); also elsewhere on the board
/SAMA7/EXT.DAT2: U1.U14 (SDMMC0_DAT2); also elsewhere on the board
/SAMA7/EXT.DAT3: U1.R12 (SDMMC0_DAT3); also elsewhere on the board
/SAMA7/HAPT_EN: U1.Y19 (PE11); also elsewhere on the board
/SAMA7/HHSRTUNE: C2.1, R6.2, U1.K7 (HHSRTUNE)
/SAMA7/JTAGSEL: JP1.2 (C), U1.H10 (JTAGSEL)
/SAMA7/QSPI0_CAL: R11.2, U1.M13 (QSPI0_CAL)
/SAMA7/SD0_CAL: R8.2, U1.R16 (SDMMC0_CAL)
/SAMA7/SD1_CAL: R9.2, U1.B13 (SDMMC1_CAL)
/SAMA7/SD2_CAL: R10.2, U1.E14 (SDMMC2_CAL)
/SAMA7/TCK: J2.4 (SWCLK/TCK), R14.1, U1.A3 (TCK_SWCLK)
/SAMA7/TDI: J2.8 (NC/TDI), R12.1, U1.B3 (TDI)
/SAMA7/TDO: J2.6 (SWO/TDO), U1.G6 (TDO)
/SAMA7/TMS: J2.2 (SWDIO/TMS), R13.1, U1.F5 (TMS_SWDIO)
/SAMA7/TOUCH.SCL: R4.1, TP4.1 (1_1), U1.K12 (FLEXCOM5_IO1); also elsewhere on the board
/SAMA7/TOUCH.SDA: R5.1, TP5.1 (1_1), U1.D20 (FLEXCOM5_IO0); also elsewhere on the board
/SAMA7/TOUCH_~INT: U1.Y15 (PE7); also elsewhere on the board
/SAMA7/UART_SAMBA_RX: J1.1, U1.H16 (FLEXCOM6_IO0)
/SAMA7/UART_SAMBA_TX: J1.2, U1.F18 (FLEXCOM6_IO1)
/SAMA7/VBAT: C5.1, JP2.2 (C), U1.E8 (VBAT)
/SAMA7/WIFI.CK: U1.D16 (SDMMC2_CK); also elsewhere on the board
/SAMA7/WIFI.CMD: U1.C15 (SDMMC2_CMD); also elsewhere on the board
/SAMA7/WIFI.DAT0: U1.B16 (SDMMC2_DAT0); also elsewhere on the board
/SAMA7/WIFI.DAT1: U1.D17 (SDMMC2_DAT1); also elsewhere on the board
/SAMA7/WIFI.DAT2: U1.A16 (SDMMC2_DAT2); also elsewhere on the board
/SAMA7/WIFI.DAT3: U1.C16 (SDMMC2_DAT3); also elsewhere on the board
/SAMA7/WL.DEV_WAKE: U1.G13 (PD2); also elsewhere on the board
/SAMA7/WL.EN: U1.N14 (PB13); also elsewhere on the board
/SAMA7/WL.HOST_WAKE: U1.A18 (PD1); also elsewhere on the board
/SAMA7/ZQ: R3.1, U1.AA2 (DDR_ZQ)
/SAMA7/~TRST: TP3.1 (1_1), U1.F4 (PC22)
GND: C1.1, C2.2, C3.2, C4.2, C5.2, C6.2, C7.2, C8.2, C9.2, C12.2, C13.2, C14.2, C15.2, C16.2, C17.2, C18.2, C19.2, C20.2, C21.2, C22.2, C23.2, C24.2, C25.2, C26.2, C27.2, C28.2, C29.2, C30.2, C31.2, C32.2, C33.2, C34.2, C35.2, C36.2, C37.2, C38.2, C39.2, C40.2, C41.2, C42.2, C43.2, C44.2, C45.2, C46.2, C47.2, C48.2, C49.2, C50.2, C51.2, C52.2, C53.2, C54.2, C55.2, C56.2, C57.2, C58.2, C59.2, C60.2, C61.2, C62.2, C63.2, C128.2, J2.3 (GND), J2.5 (GND), J2.9 (GNDDetect), JP1.1 (A), R3.2, R6.1, R8.1, R9.1, R10.1, R11.1, U1.A1 (GND), U1.A11 (GND), U1.A14 (GND), U1.A17 (GND), U1.A21 (GND), U1.AA1 (GND), U1.AA8 (GND), U1.AA9 (GND), U1.AA11 (GND), U1.AA14 (GND), U1.AA17 (GND), U1.AA21 (GND), U1.B6 (GND), U1.C4 (GND), U1.C7 (GND), U1.D9 (GND), U1.D13 (GND), U1.E1 (GNDANA), U1.E7 (GNDANA), U1.E15 (GND), U1.E21 (GND), U1.F16 (GND), U1.G5 (GNDIN33), U1.G9 (TST), U1.G11 (GNDBAT), U1.G15 (GND), U1.G17 (GND), U1.H1 (GNDANA), U1.H8 (GND), U1.H9 (GND), U1.H14 (GND), U1.H21 (GND), U1.J4 (GND), U1.J18 (GND), U1.K11 (GND), U1.L1 (GND), U1.L7 (GNDUTMI), U1.L11 (GND), U1.L15 (GND), U1.L21 (GND), U1.N4 (GND), U1.N18 (GND), U1.P1 (GND), U1.P8 (GND), U1.P14 (GND), U1.P21 (GND), U1.R5 (GND), U1.R7 (GND), U1.R11 (GND), U1.R15 (GNDDPHY), U1.R17 (GND), U1.T5 (GND), U1.T17 (GND), U1.U1 (GND), U1.U7 (GND), U1.U15 (GNDDPHY), U1.U21 (GND), U1.V9 (GNDANA), U1.V13 (GND), U1.W5 (GND), U1.[A1,A11,A14,A17,A21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 (GND), U1.[E1,E7,H1,V9] (GNDANA), U1.[R15,U15] (GNDDPHY), Y1.2 (G), Y1.4 (G); also elsewhere on the board
unnamed: C6.1, U1.A9 (XIN32), Y2.2
unnamed: C3.1, U1.B7 (XIN), Y1.1
unnamed: C7.1, U1.B9 (XOUT32), Y2.1
unnamed: C4.1, U1.A7 (XOUT), Y1.3

Notes on the sheet:
PERIs
GPIO
=2 x (7pF - 2pF - 1pF/2) = 2 x 4.5pF = 9pF
= 2 x (12pF - 1pF - 1pF/2) = 2 x 10.5pF = 21 pF
SYS
PWR
DDR
CTS
RTS

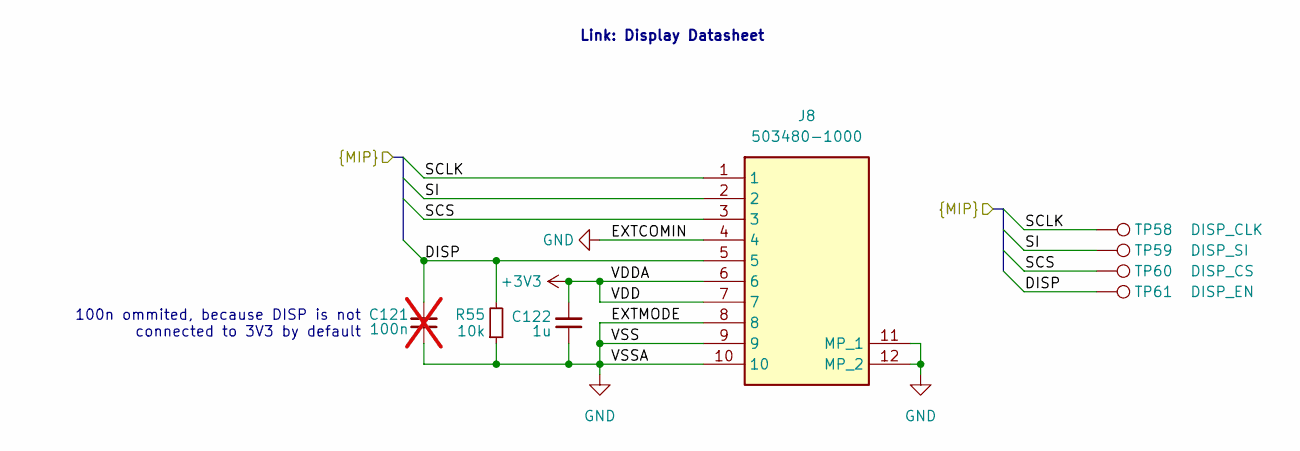
[picture p25: schematic display.kicad_sch]

Parts:
C121: 100n; C_0201_0603Metric; not fitted
C122: 1u; C_0402_1005Metric
J8: 503480-1000; 5034801000; MPN 503480-1000; LCSC C127355
R55: 10k; R_0402_1005Metric
TP58: DISP_CLK; TestPoint_Pad_D1.0mm
TP59: DISP_SI; TestPoint_Pad_D1.0mm
TP60: DISP_CS; TestPoint_Pad_D1.0mm
TP61: DISP_EN; TestPoint_Pad_D1.0mm

Connections:
+3V3: C122.2, J8.6, J8.7; also elsewhere on the board
/Display/DISP: C121.2, J8.5, R55.2, TP61.1 (1_1); also elsewhere on the board
/Display/SCLK: J8.1, TP58.1 (1_1); also elsewhere on the board
/Display/SCS: J8.3, TP60.1 (1_1); also elsewhere on the board
/Display/SI: J8.2, TP59.1 (1_1); also elsewhere on the board
GND: C121.1, C122.1, J8.4, J8.8, J8.9, J8.10, J8.11 (MP_1), J8.12 (MP_2), R55.1; also elsewhere on the board

Notes on the sheet:
100n ommited, because DISP is not connected to 3V3 by default
Link: Display Datasheet

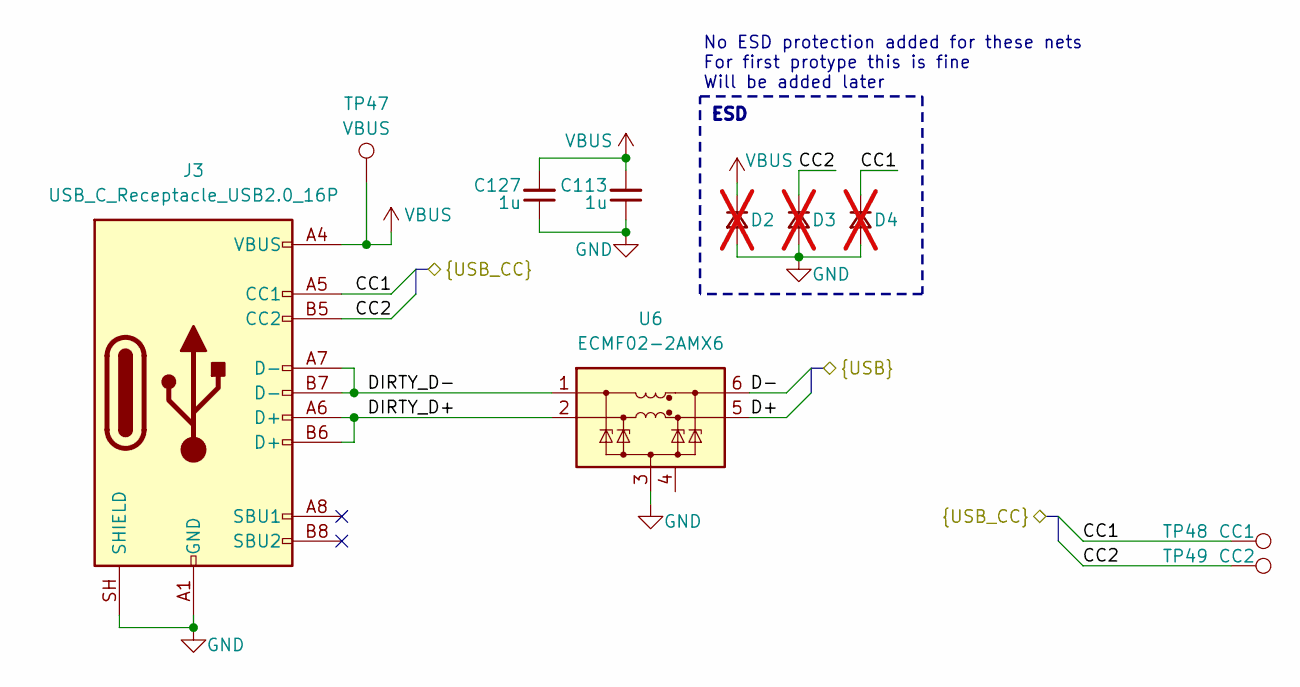
[picture p26: schematic usb.kicad_sch]

Parts:
C113, C127: 1u; C_0402_1005Metric
D2, D3, D4: ESD441; ESD441DPLR; not fitted
J3: USB_C_Receptacle_USB2.0_16P; USB_C_Receptacle_HRO_TYPE-C-31-M-12
TP47: VBUS; TestPoint_Pad_D1.0mm
TP48: CC1; TestPoint_Pad_D1.0mm
TP49: CC2; TestPoint_Pad_D1.0mm
U6: ECMF02-2AMX6; ST_UQFN-6L_1.5x1.7mm_P0.5mm

Connections:
/Power/CC1: D4.1 (K), J3.A5 (CC1), TP48.1 (1_1); also elsewhere on the board
/Power/CC2: D3.1 (K), J3.B5 (CC2), TP49.1 (1_1); also elsewhere on the board
/SAMA7/D+: U6.5 (D-_out); also elsewhere on the board
/SAMA7/D-: U6.6 (D+_out); also elsewhere on the board
/USB/DIRTY_D+: J3.A6 (D+), J3.B6 (D+), U6.2 (D-_in)
/USB/DIRTY_D-: J3.A7 (D-), J3.B7 (D-), U6.1 (D+_in)
GND: C113.1, C127.1, D2.2 (A), D3.2 (A), D4.2 (A), J3.A1 (GND), J3.A12 (GND), J3.B1 (GND), J3.B12 (GND), J3.SH (SHIELD), U6.3 (GND); also elsewhere on the board
VBUS: C113.2, C127.2, D2.1 (K), J3.A4 (VBUS), J3.A9 (VBUS), J3.B4 (VBUS), J3.B9 (VBUS), TP47.1 (1_1); also elsewhere on the board

Notes on the sheet:
No ESD protection added for these nets For first protype this is fine Will be added later
ESD

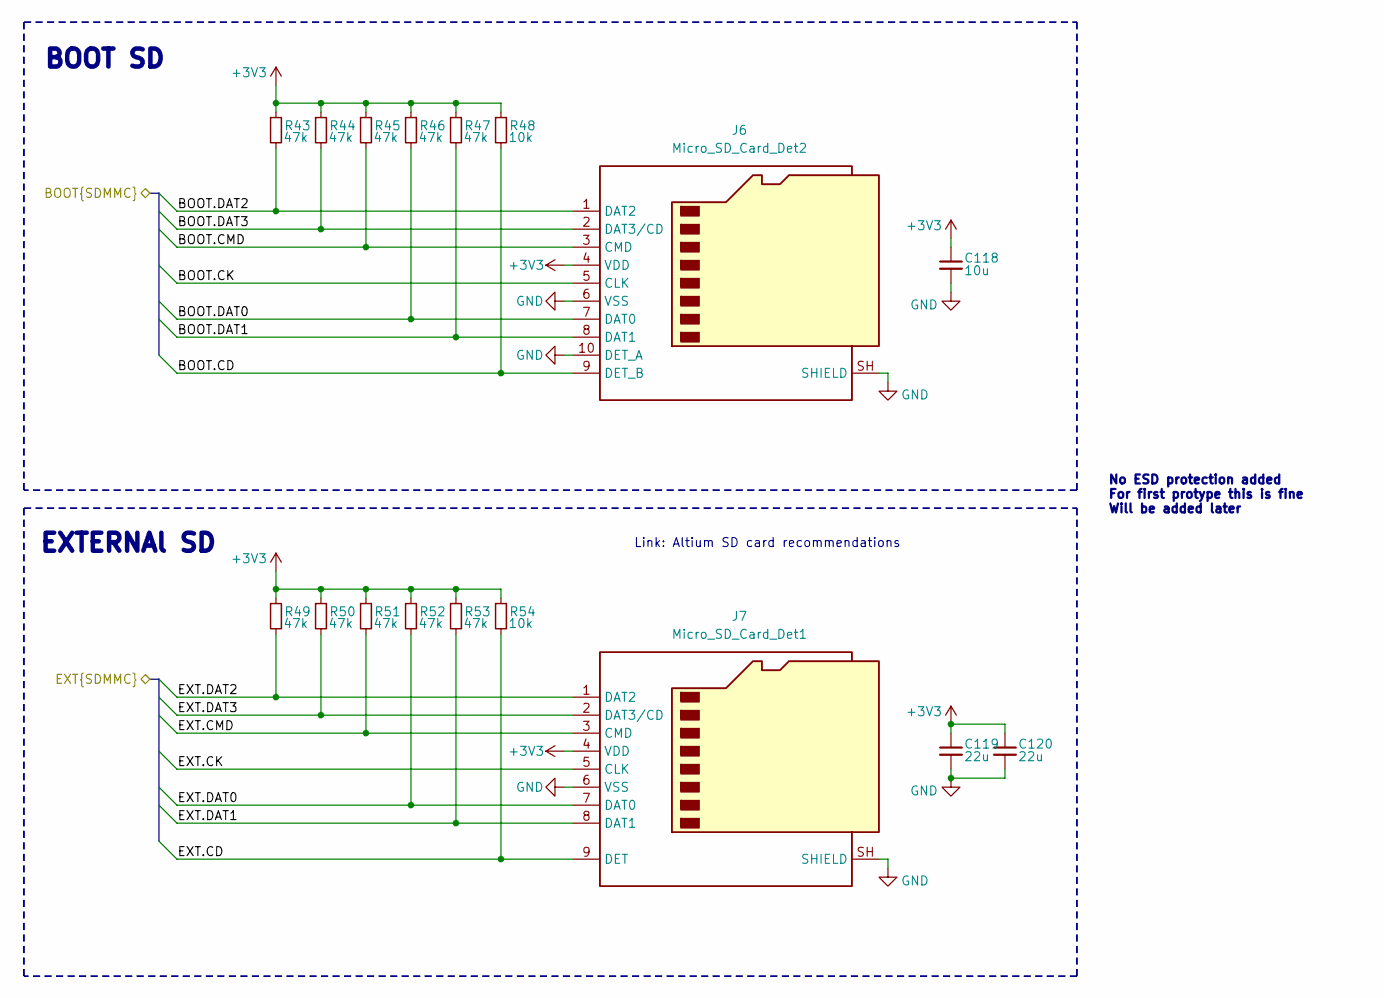
[picture p27: schematic sd.kicad_sch, SD Cards]

Parts:
C118: 10u; C_0402_1005Metric
C119, C120: 22u; C_0603_1608Metric
J6: Micro_SD_Card_Det2; microSD_SOFNG_TF-008; MPN TF-008; LCSC C428465
J7: Micro_SD_Card_Det1; microSD_XYECONN_TF-015-ZYD9AH185; MPN TF-015-ZYD9AH1.85; LCSC C20613194
R43, R44, R45, R46, R47, R49, R50, R51, R52, R53: 47k; R_0402_1005Metric
R48, R54: 10k; R_0402_1005Metric

Connections:
+3V3: C118.1, C119.1, C120.1, J6.4 (VDD), J7.4 (VDD), R43.1, R44.1, R45.1, R46.1, R47.1, R48.1, R49.1, R50.1, R51.1, R52.1, R53.1, R54.1; also elsewhere on the board
/SAMA7/BOOT.CD: J6.9 (DET_B), R48.2; also elsewhere on the board
/SAMA7/BOOT.CK: J6.5 (CLK); also elsewhere on the board
/SAMA7/BOOT.CMD: J6.3 (CMD), R45.2; also elsewhere on the board
/SAMA7/BOOT.DAT0: J6.7 (DAT0), R46.2; also elsewhere on the board
/SAMA7/BOOT.DAT1: J6.8 (DAT1), R47.2; also elsewhere on the board
/SAMA7/BOOT.DAT2: J6.1 (DAT2), R43.2; also elsewhere on the board
/SAMA7/BOOT.DAT3: J6.2 (DAT3/CD), R44.2; also elsewhere on the board
/SAMA7/EXT.CD: J7.9 (DET), R54.2; also elsewhere on the board
/SAMA7/EXT.CK: J7.5 (CLK); also elsewhere on the board
/SAMA7/EXT.CMD: J7.3 (CMD), R51.2; also elsewhere on the board
/SAMA7/EXT.DAT0: J7.7 (DAT0), R52.2; also elsewhere on the board
/SAMA7/EXT.DAT1: J7.8 (DAT1), R53.2; also elsewhere on the board
/SAMA7/EXT.DAT2: J7.1 (DAT2), R49.2; also elsewhere on the board
/SAMA7/EXT.DAT3: J7.2 (DAT3/CD), R50.2; also elsewhere on the board
GND: C118.2, C119.2, C120.2, J6.6 (VSS), J6.10 (DET_A), J6.SH (SHIELD), J7.6 (VSS), J7.SH (SHIELD); also elsewhere on the board

Notes on the sheet:
EXTERNAl SD
No ESD protection added For first protype this is fine Will be added later
Link: Altium SD card recommendations
BOOT SD
