KOEGlike/meko/hardware/pcb/meko.kicad_pcb

## KiCad design hardware/pcb/meko.kicad_pcb (continued)

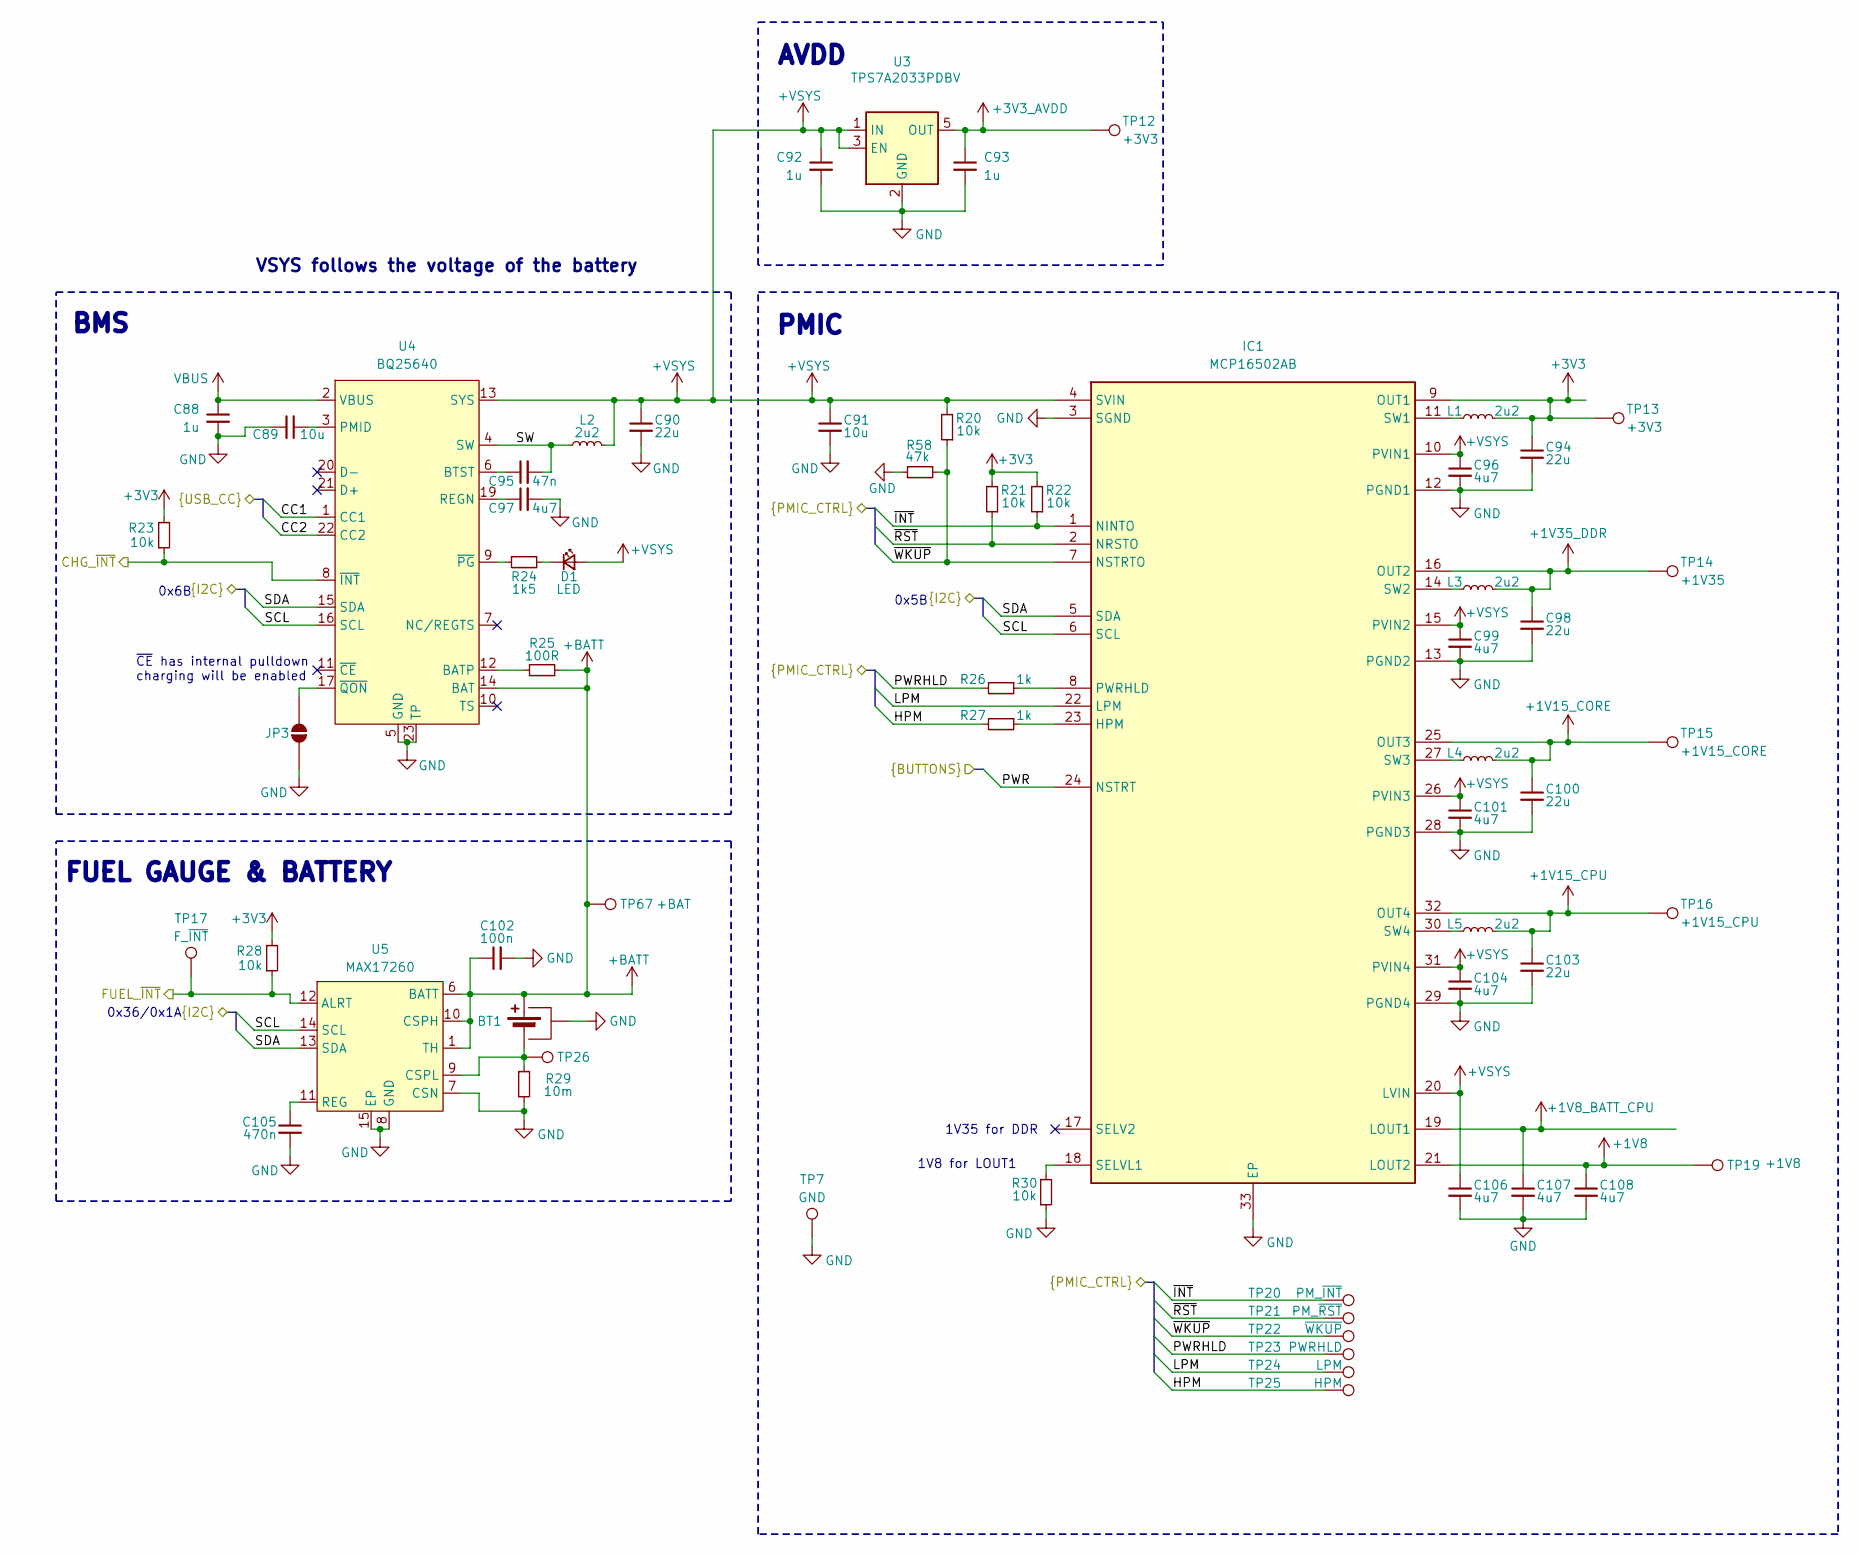
[picture p28: schematic power.kicad_sch]

Parts:
BT1: Battery_Cell; JST_GH_SM02B-GHS-TB_1x02-1MP_P1.25mm_Horizontal; MPN SM02B-GHS-TB(LF)(SN); LCSC C189893
C88, C92, C93: 1u; C_0402_1005Metric
C89, C91: 10u; C_0402_1005Metric
C90, C94, C98, C100, C103: 22u; C_0603_1608Metric
C95: 47n; C_0201_0603Metric
C96, C97, C99, C101, C104, C106, C107, C108: 4u7; C_0402_1005Metric
C102: 100n; C_0201_0603Metric
C105: 470n; C_0201_0603Metric
D1: LED; LED_0603_1608Metric; LCSC C965808
IC1: MCP16502AB; VQFN-32-1EP_5x5mm_P0.5mm_EP3.15x3.15mm; MPN MCP16502AB
JP3: SolderJumper_2_Open; SolderJumper-2_P1.3mm_Open_RoundedPad1.0x1.5mm
L1, L2, L3, L4, L5: 2u2; L_1008_2520Metric; LCSC C391305
R20: 10k; R_0201_0603Metric
R21, R22, R23, R28, R30: 10k; R_0402_1005Metric
R24: 1k5; R_0402_1005Metric
R25: 100R; R_0402_1005Metric
R26, R27: 1k; R_0402_1005Metric
R29: 10m; R_0402_1005Metric
R58: 47k; R_0402_1005Metric
TP7: GND; TestPoint_Pad_D1.0mm
TP12, TP13: +3V3; TestPoint_Pad_D1.0mm
TP14: +1V35; TestPoint_Pad_D1.0mm
TP15: +1V15_CORE; TestPoint_Pad_D1.0mm
TP16: +1V15_CPU; TestPoint_Pad_D1.0mm
TP17: F_~{INT}; TestPoint_Pad_D1.0mm
TP19: +1V8; TestPoint_Pad_D1.0mm
TP20: PM_~{INT}; TestPoint_Pad_D1.0mm
TP21: PM_~{RST}; TestPoint_Pad_D1.0mm
TP22: ~{WKUP}; TestPoint_Pad_D1.0mm
TP23: PWRHLD; TestPoint_Pad_D1.0mm
TP24: LPM; TestPoint_Pad_D1.0mm
TP25, TP26: HPM; TestPoint_Pad_D1.0mm
TP67: +BAT; TestPoint_Pad_D1.0mm
U3: TPS7A2033PDBV; SOT-23-5
U4: BQ25640; VDL0023A-MFG
U5: MAX17260; TDFN-14-1EP_3x3mm_P0.4mm_EP1.78x2.35mm

Connections:
+1V8: C108.1, IC1.21 (LOUT2), TP19.1 (1_1); also elsewhere on the board
+1V8_BATT_CPU: C107.1, IC1.19 (LOUT1); also elsewhere on the board
+1V15_CORE: C100.1, IC1.25 (OUT3), L4.2, TP15.1 (1_1); also elsewhere on the board
+1V15_CPU: C103.1, IC1.32 (OUT4), L5.2, TP16.1 (1_1); also elsewhere on the board
+1V35_DDR: C98.1, IC1.16 (OUT2), L3.2, TP14.1 (1_1); also elsewhere on the board
+3V3: C94.1, IC1.9 (OUT1), L1.2, R21.2, R22.2, R23.2, R28.2, TP13.1 (1_1); also elsewhere on the board
+3V3_AVDD: C93.1, TP12.1 (1_1), U3.5 (OUT); also elsewhere on the board
+BATT: BT1.1 (+), C102.1, R25.2, TP67.1 (1_1), U4.14 (BAT), U5.1 (TH), U5.6 (BATT), U5.10 (CSPH)
+VSYS: C90.1, C91.1, C92.1, C96.1, C99.1, C101.1, C104.1, C106.1, D1.2 (A), IC1.4 (SVIN), IC1.10 (PVIN1), IC1.15 (PVIN2), IC1.20 (LVIN), IC1.26 (PVIN3), IC1.31 (PVIN4), L2.2, R20.2, U3.1 (IN), U3.3 (EN), U4.13 (SYS)
/Audio/SCL: IC1.6 (SCL), U4.16 (SCL), U5.14 (SCL); also elsewhere on the board
/Audio/SDA: IC1.5 (SDA), U4.15 (SDA), U5.13 (SDA); also elsewhere on the board
/Buttons/PWR: IC1.24 (NSTRT); also elsewhere on the board
/Power/CC1: U4.1 (CC1); also elsewhere on the board
/Power/CC2: U4.22 (CC2); also elsewhere on the board
/Power/CHG_~INT: R23.1, U4.8 (~INT); also elsewhere on the board
/Power/FUEL_~INT: R28.1, TP17.1 (1_1), U5.12 (ALRT); also elsewhere on the board
/Power/HPM: R27.2, TP25.1 (1_1); also elsewhere on the board
/Power/LPM: IC1.22 (LPM), TP24.1 (1_1); also elsewhere on the board
/Power/PWRHLD: R26.2, TP23.1 (1_1); also elsewhere on the board
/Power/SW: C95.2, L2.1, U4.4 (SW)
/Power/~INT: IC1.1 (NINTO), R22.1, TP20.1 (1_1); also elsewhere on the board
/Power/~RST: IC1.2 (NRSTO), R21.1, TP21.1 (1_1); also elsewhere on the board
/Power/~WKUP: IC1.7 (NSTRTO), R20.1, R58.2, TP22.1 (1_1); also elsewhere on the board
GND: BT1.MP, C88.2, C89.2, C90.2, C91.2, C92.2, C93.2, C94.2, C96.2, C97.2, C98.2, C99.2, C100.2, C101.2, C102.2, C103.2, C104.2, C105.2, C106.2, C107.2, C108.2, IC1.3 (SGND), IC1.12 (PGND1), IC1.13 (PGND2), IC1.28 (PGND3), IC1.29 (PGND4), IC1.33 (EP), JP3.1 (A), R29.2, R30.1, R58.1, TP7.1 (1_1), U3.2 (GND), U4.5 (GND), U4.18 (GND), U4.23 (TP), U5.7 (CSN), U5.8 (GND), U5.15 (EP); also elsewhere on the board
unnamed: BT1.2 (-), R29.1, TP26.1 (1_1), U5.9 (CSPL)
unnamed: D1.1 (K), R24.2
unnamed: IC1.23 (HPM), R27.1
unnamed: IC1.8 (PWRHLD), R26.1
unnamed: IC1.18 (SELVL1), R30.2
unnamed: IC1.11 (SW1), L1.1
unnamed: IC1.14 (SW2), L3.1
unnamed: IC1.27 (SW3), L4.1
unnamed: IC1.30 (SW4), L5.1
unnamed: JP3.2 (B), U4.17 (~QON)
unnamed: R25.1, U4.12 (BATP)
unnamed: C95.1, U4.6 (BTST)
unnamed: C89.1, U4.3 (PMID)
unnamed: C97.1, U4.19 (REGN)
unnamed: R24.1, U4.9 (~PG)
unnamed: C105.1, U5.11 (REG)
VBUS: C88.1, U4.2 (VBUS); also elsewhere on the board

Notes on the sheet:
0x5B
0x6B
VSYS follows the voltage of the battery
0x36/0x1A
1V35 for DDR
PMIC
BMS
AVDD
1V8 for LOUT1
~{CE} has internal pulldown charging will be enabled
FUEL GAUGE & BATTERY

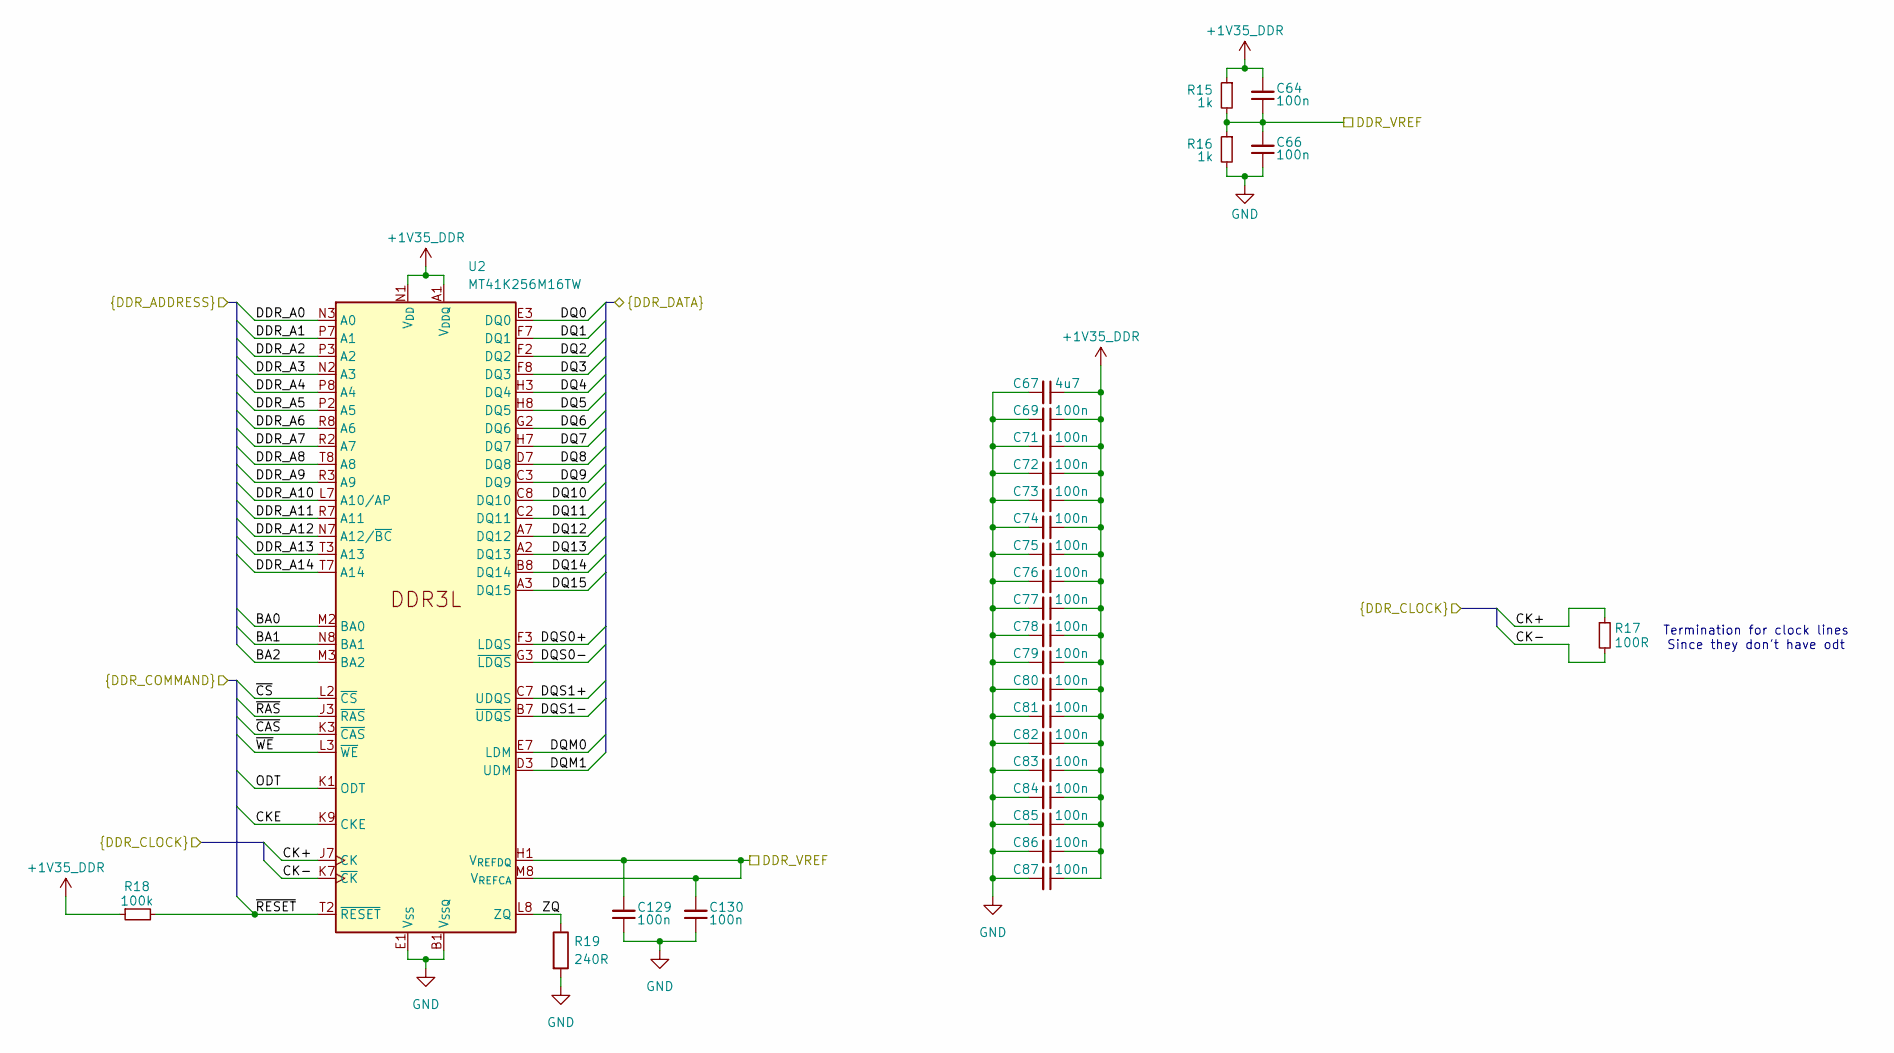
[picture p29: schematic ddr.kicad_sch]

Parts:
C64, C66, C69, C71, C72, C73, C74, C76, C77, C78, C79, C80, C81, C82, C83, C84, C85, C86, C87, C129, C130: 100n; C_0201_0603Metric
C67: 4u7; C_0402_1005Metric
C75: 100n; C_0201_0603Metric_Dense
R15, R16: 1k; R_0201_0603Metric
R17: 100R; R_0201_0603Metric
R18: 100k; R_0201_0603Metric
R19: 240R; R_0201_0603Metric
U2: MT41K256M16TW; Micron_FBGA-96_8x14mm_Layout9x16_P0.8mm; LCSC C253882

Connections:
+1V35_DDR: C64.2, C67.1, C69.1, C71.1, C72.1, C73.1, C74.1, C75.1, C76.1, C77.1, C78.1, C79.1, C80.1, C81.1, C82.1, C83.1, C84.1, C85.1, C86.1, C87.1, R15.1, R18.1, U2.A1 (V_{DDQ}), U2.A8 (V_{DDQ}), U2.B2 (V_{DD}), U2.C1 (V_{DDQ}), U2.C9 (V_{DDQ}), U2.D2 (V_{DDQ}), U2.D9 (V_{DD}), U2.E9 (V_{DDQ}), U2.F1 (V_{DDQ}), U2.G7 (V_{DD}), U2.H2 (V_{DDQ}), U2.H9 (V_{DDQ}), U2.K2 (V_{DD}), U2.K8 (V_{DD}), U2.N1 (V_{DD}), U2.N9 (V_{DD}), U2.R1 (V_{DD}), U2.R9 (V_{DD}); also elsewhere on the board
/DDR/BA0: U2.M2 (BA0); also elsewhere on the board
/DDR/BA1: U2.N8 (BA1); also elsewhere on the board
/DDR/BA2: U2.M3 (BA2); also elsewhere on the board
/DDR/CK+: R17.1, U2.J7 (CK); also elsewhere on the board
/DDR/CK-: R17.2, U2.K7 (~CK); also elsewhere on the board
/DDR/CKE: U2.K9 (CKE); also elsewhere on the board
/DDR/DDR_A0: U2.N3 (A0); also elsewhere on the board
/DDR/DDR_A1: U2.P7 (A1); also elsewhere on the board
/DDR/DDR_A2: U2.P3 (A2); also elsewhere on the board
/DDR/DDR_A3: U2.N2 (A3); also elsewhere on the board
/DDR/DDR_A4: U2.P8 (A4); also elsewhere on the board
/DDR/DDR_A5: U2.P2 (A5); also elsewhere on the board
/DDR/DDR_A6: U2.R8 (A6); also elsewhere on the board
/DDR/DDR_A7: U2.R2 (A7); also elsewhere on the board
/DDR/DDR_A8: U2.T8 (A8); also elsewhere on the board
/DDR/DDR_A9: U2.R3 (A9); also elsewhere on the board
/DDR/DDR_A10: U2.L7 (A10/AP); also elsewhere on the board
/DDR/DDR_A11: U2.R7 (A11); also elsewhere on the board
/DDR/DDR_A12: U2.N7 (A12/~BC); also elsewhere on the board
/DDR/DDR_A13: U2.T3 (A13); also elsewhere on the board
/DDR/DDR_A14: U2.T7 (A14); also elsewhere on the board
/DDR/DDR_VREF: C64.1, C66.2, C129.2, C130.2, R15.2, R16.1, U2.H1 (V_{REFDQ}), U2.M8 (V_{REFCA}); also elsewhere on the board
/DDR/DQ0: U2.E3 (DQ0); also elsewhere on the board
/DDR/DQ1: U2.F7 (DQ1); also elsewhere on the board
/DDR/DQ2: U2.F2 (DQ2); also elsewhere on the board
/DDR/DQ3: U2.F8 (DQ3); also elsewhere on the board
/DDR/DQ4: U2.H3 (DQ4); also elsewhere on the board
/DDR/DQ5: U2.H8 (DQ5); also elsewhere on the board
/DDR/DQ6: U2.G2 (DQ6); also elsewhere on the board
/DDR/DQ7: U2.H7 (DQ7); also elsewhere on the board
/DDR/DQ8: U2.D7 (DQ8); also elsewhere on the board
/DDR/DQ9: U2.C3 (DQ9); also elsewhere on the board
/DDR/DQ10: U2.C8 (DQ10); also elsewhere on the board
/DDR/DQ11: U2.C2 (DQ11); also elsewhere on the board
/DDR/DQ12: U2.A7 (DQ12); also elsewhere on the board
/DDR/DQ13: U2.A2 (DQ13); also elsewhere on the board
/DDR/DQ14: U2.B8 (DQ14); also elsewhere on the board
/DDR/DQ15: U2.A3 (DQ15); also elsewhere on the board
/DDR/DQM0: U2.E7 (LDM); also elsewhere on the board
/DDR/DQM1: U2.D3 (UDM); also elsewhere on the board
/DDR/DQS0+: U2.F3 (LDQS); also elsewhere on the board
/DDR/DQS0-: U2.G3 (~LDQS); also elsewhere on the board
/DDR/DQS1+: U2.C7 (UDQS); also elsewhere on the board
/DDR/DQS1-: U2.B7 (~UDQS); also elsewhere on the board
/DDR/ODT: U2.K1 (ODT); also elsewhere on the board
/DDR/ZQ: R19.1, U2.L8 (ZQ)
/DDR/~CAS: U2.K3 (~CAS); also elsewhere on the board
/DDR/~CS: U2.L2 (~CS); also elsewhere on the board
/DDR/~RAS: U2.J3 (~RAS); also elsewhere on the board
/DDR/~RESET: R18.2, U2.T2 (~RESET); also elsewhere on the board
/DDR/~WE: U2.L3 (~WE); also elsewhere on the board
GND: C66.1, C67.2, C69.2, C71.2, C72.2, C73.2, C74.2, C75.2, C76.2, C77.2, C78.2, C79.2, C80.2, C81.2, C82.2, C83.2, C84.2, C85.2, C86.2, C87.2, C129.1, C130.1, R16.2, R19.2, U2.A9 (V_{SS}), U2.B1 (V_{SSQ}), U2.B3 (V_{SS}), U2.B9 (V_{SSQ}), U2.D1 (V_{SSQ}), U2.D8 (V_{SSQ}), U2.E1 (V_{SS}), U2.E2 (V_{SSQ}), U2.E8 (V_{SSQ}), U2.F9 (V_{SSQ}), U2.G1 (V_{SSQ}), U2.G8 (V_{SS}), U2.G9 (V_{SSQ}), U2.J2 (V_{SS}), U2.J8 (V_{SS}), U2.M1 (V_{SS}), U2.M9 (V_{SS}), U2.P1 (V_{SS}), U2.P9 (V_{SS}), U2.T1 (V_{SS}), U2.T9 (V_{SS}); also elsewhere on the board

Notes on the sheet:
Termination for clock lines Since they don't have odt

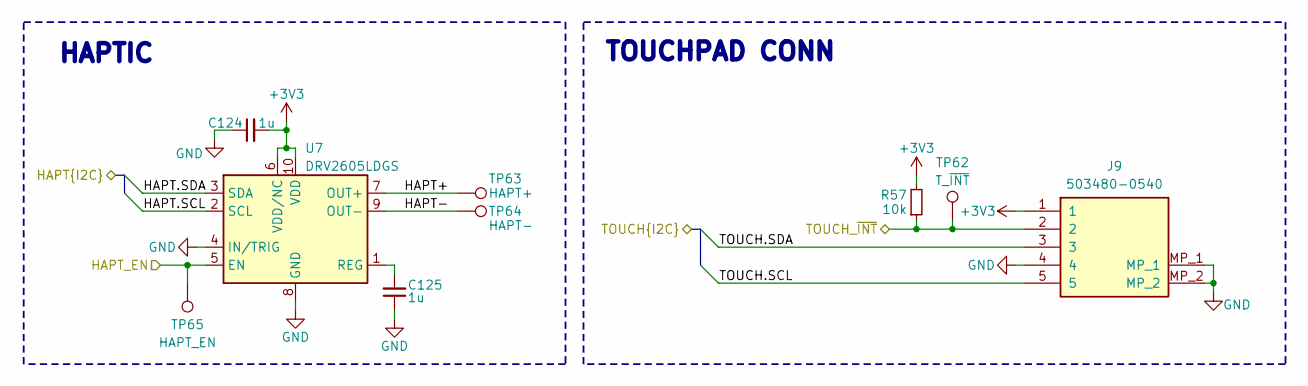
[picture p30: schematic touchpad.kicad_sch]

Parts:
C124, C125: 1u; C_0402_1005Metric
J9: 503480-0540; MPN 5034800540; LCSC C5527934
R57: 10k; R_0402_1005Metric
TP62: T_~{INT}; TestPoint_Pad_D1.0mm
TP63: HAPT+; TestPoint_Pad_D2.0mm
TP64: HAPT-; TestPoint_Pad_D2.0mm
TP65: HAPT_EN; TestPoint_Pad_D1.0mm
U7: DRV2605LDGS; TSSOP-10_3x3mm_P0.5mm

Connections:
+3V3: C124.2, J9.1, R57.2, U7.6 (VDD/NC), U7.10 (VDD); also elsewhere on the board
/Audio/SCL: U7.2 (SCL); also elsewhere on the board
/Audio/SDA: U7.3 (SDA); also elsewhere on the board
/SAMA7/HAPT_EN: TP65.1 (1_1), U7.5 (EN); also elsewhere on the board
/SAMA7/TOUCH.SCL: J9.5; also elsewhere on the board
/SAMA7/TOUCH.SDA: J9.3; also elsewhere on the board
/SAMA7/TOUCH_~INT: J9.2, R57.1, TP62.1 (1_1); also elsewhere on the board
/Touchpad/HAPT+: TP63.1 (1_1), U7.7 (OUT+)
/Touchpad/HAPT-: TP64.1 (1_1), U7.9 (OUT-)
GND: C124.1, C125.1, J9.4, J9.MP_1, J9.MP_2, U7.4 (IN/TRIG), U7.8 (GND); also elsewhere on the board
unnamed: C125.2, U7.1 (REG)

Notes on the sheet:
TOUCHPAD CONN
HAPTIC

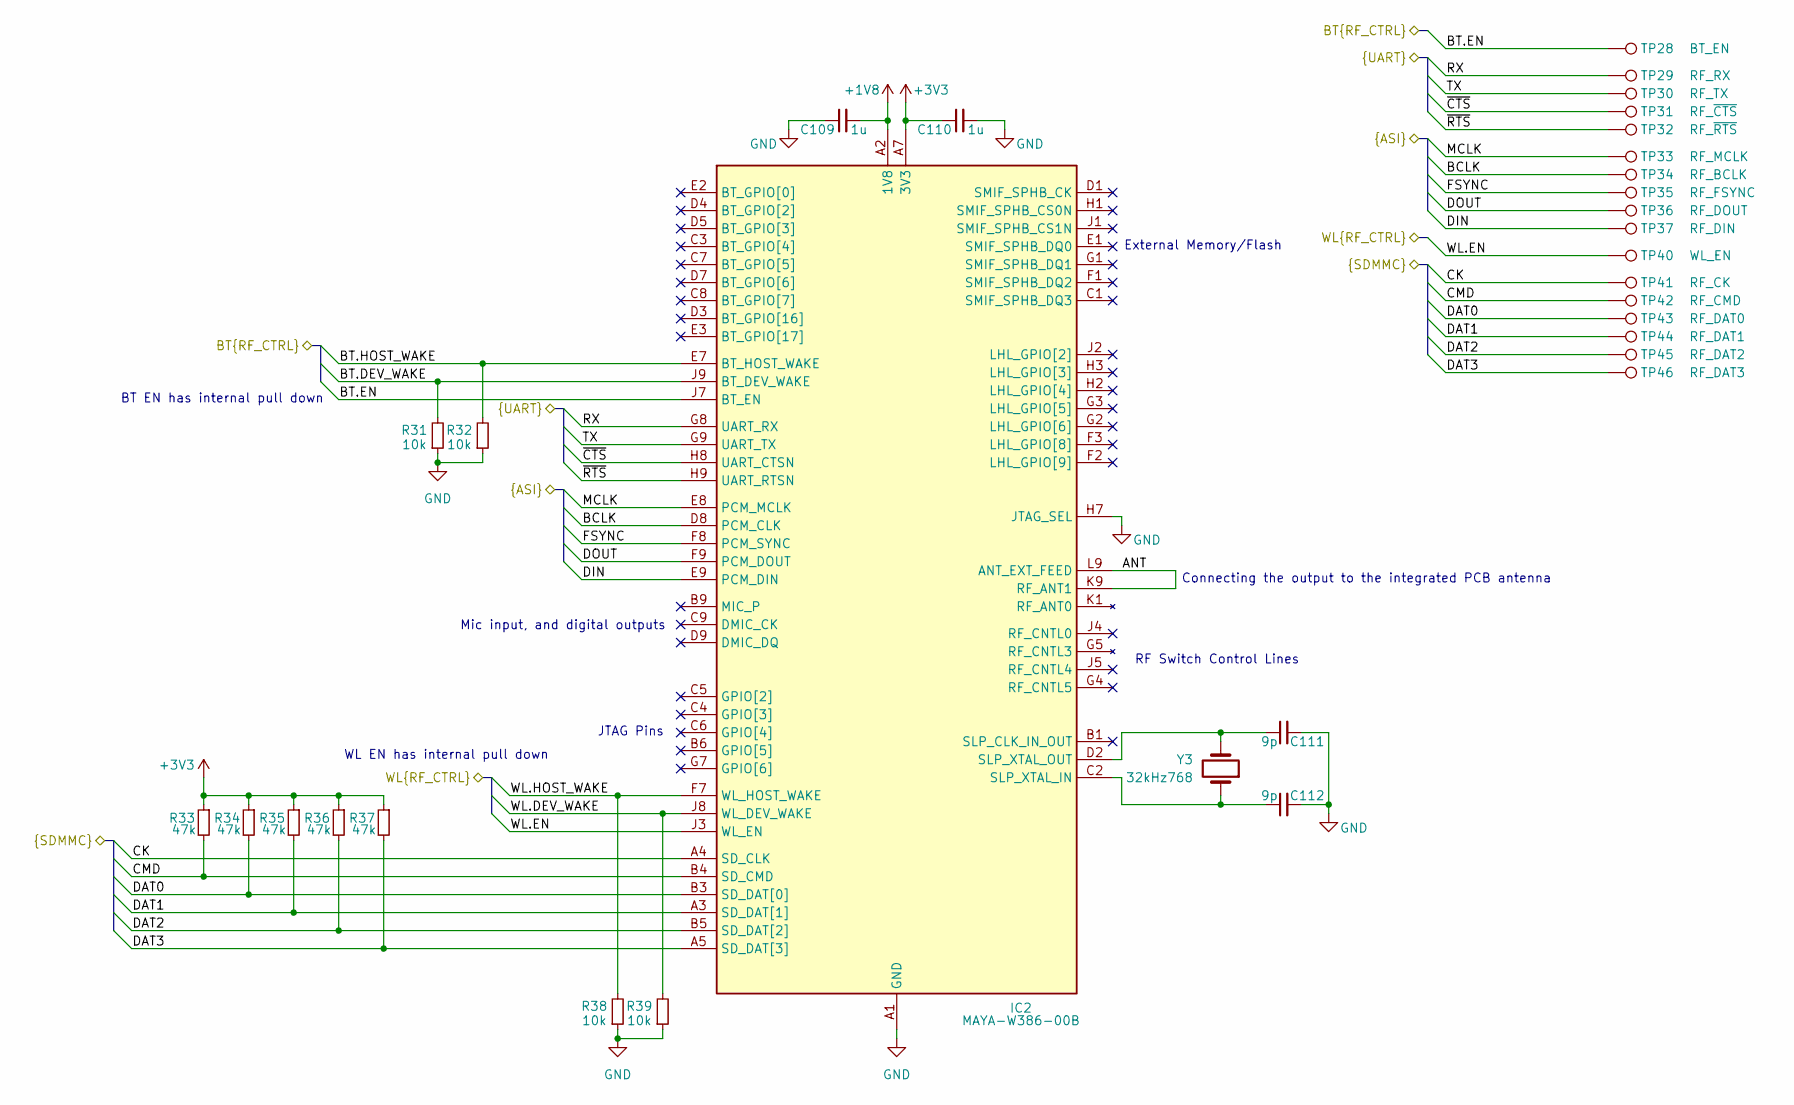
[picture p31: schematic wireless.kicad_sch]

Parts:
C109, C110: 1u; C_0402_1005Metric
C111, C112: 9p; C_0201_0603Metric
IC2: MAYA-W386-00B; MPN MAYA-W383-00B
R31, R32, R38, R39: 10k; R_0402_1005Metric
R33, R34, R35, R36, R37: 47k; R_0402_1005Metric
TP28: BT_EN; TestPoint_Pad_D1.0mm
TP29: RF_RX; TestPoint_Pad_D1.0mm
TP30: RF_TX; TestPoint_Pad_D1.0mm
TP31: RF_~{CTS}; TestPoint_Pad_D1.0mm
TP32: RF_~{RTS}; TestPoint_Pad_D1.0mm
TP33: RF_MCLK; TestPoint_Pad_D1.0mm
TP34: RF_BCLK; TestPoint_Pad_D1.0mm
TP35: RF_FSYNC; TestPoint_Pad_D1.0mm
TP36: RF_DOUT; TestPoint_Pad_D1.0mm
TP37: RF_DIN; TestPoint_Pad_D1.0mm
TP40: WL_EN; TestPoint_Pad_D1.0mm
TP41: RF_CK; TestPoint_Pad_D1.0mm
TP42: RF_CMD; TestPoint_Pad_D1.0mm
TP43: RF_DAT0; TestPoint_Pad_D1.0mm
TP44: RF_DAT1; TestPoint_Pad_D1.0mm
TP45: RF_DAT2; TestPoint_Pad_D1.0mm
TP46: RF_DAT3; TestPoint_Pad_D1.0mm
Y3: 32kHz768; Crystal_SMD_MicroCrystal_CC7V-T1A-2Pin_3.2x1.5mm; MPN SC-32S32.768kHz20PPM7pF

Connections:
+1V8: C109.2, IC2.A2 (1V8); also elsewhere on the board
+3V3: C110.1, IC2.A7 (3V3), IC2.B7 (3V3), R33.1, R34.1, R35.1, R36.1, R37.1; also elsewhere on the board
/SAMA7/BT.BCLK: IC2.D8 (PCM_CLK), TP34.1 (1_1); also elsewhere on the board
/SAMA7/BT.DEV_WAKE: IC2.J9 (BT_DEV_WAKE), R31.2; also elsewhere on the board
/SAMA7/BT.DIN: IC2.E9 (PCM_DIN), TP37.1 (1_1); also elsewhere on the board
/SAMA7/BT.DOUT: IC2.F9 (PCM_DOUT), TP36.1 (1_1); also elsewhere on the board
/SAMA7/BT.EN: IC2.J7 (BT_EN), TP28.1 (1_1); also elsewhere on the board
/SAMA7/BT.FSYNC: IC2.F8 (PCM_SYNC), TP35.1 (1_1); also elsewhere on the board
/SAMA7/BT.HOST_WAKE: IC2.E7 (BT_HOST_WAKE), R32.2; also elsewhere on the board
/SAMA7/BT.MCLK: IC2.E8 (PCM_MCLK), TP33.1 (1_1); also elsewhere on the board
/SAMA7/BT.RX: IC2.G8 (UART_RX), TP29.1 (1_1); also elsewhere on the board
/SAMA7/BT.TX: IC2.G9 (UART_TX), TP30.1 (1_1); also elsewhere on the board
/SAMA7/BT.~CTS: IC2.H8 (UART_CTSN), TP31.1 (1_1); also elsewhere on the board
/SAMA7/BT.~RTS: IC2.H9 (UART_RTSN), TP32.1 (1_1); also elsewhere on the board
/SAMA7/WIFI.CK: IC2.A4 (SD_CLK), TP41.1 (1_1); also elsewhere on the board
/SAMA7/WIFI.CMD: IC2.B4 (SD_CMD), R33.2, TP42.1 (1_1); also elsewhere on the board
/SAMA7/WIFI.DAT0: IC2.B3 (SD_DAT[0]), R34.2, TP43.1 (1_1); also elsewhere on the board
/SAMA7/WIFI.DAT1: IC2.A3 (SD_DAT[1]), R35.2, TP44.1 (1_1); also elsewhere on the board
/SAMA7/WIFI.DAT2: IC2.B5 (SD_DAT[2]), R36.2, TP45.1 (1_1); also elsewhere on the board
/SAMA7/WIFI.DAT3: IC2.A5 (SD_DAT[3]), R37.2, TP46.1 (1_1); also elsewhere on the board
/SAMA7/WL.DEV_WAKE: IC2.J8 (WL_DEV_WAKE), R39.2; also elsewhere on the board
/SAMA7/WL.EN: IC2.J3 (WL_EN), TP40.1 (1_1); also elsewhere on the board
/SAMA7/WL.HOST_WAKE: IC2.F7 (WL_HOST_WAKE), R38.2; also elsewhere on the board
/Wireless/ANT: IC2.K9 (RF_ANT1), IC2.L9 (ANT_EXT_FEED)
GND: C109.1, C110.2, C111.2, C112.2, IC2.A1 (GND), IC2.A9 (GND), IC2.B2 (GND), IC2.B8 (GND), IC2.E4 (GND), IC2.E5 (GND), IC2.F4 (GND), IC2.F5 (GND), IC2.H4 (GND), IC2.H5 (GND), IC2.H7 (JTAG_SEL), IC2.K2 (GND), IC2.K3 (GND), IC2.K4 (GND), IC2.K5 (GND), IC2.K6 (GND), IC2.K7 (GND), IC2.K8 (GND), IC2.L1 (GND), IC2.M1 (GND), IC2.M2 (GND), IC2.M8 (GND), IC2.M9 (GND), R31.1, R32.1, R38.1, R39.1; also elsewhere on the board
unnamed: C112.1, IC2.C2 (SLP_XTAL_IN), Y3.1
unnamed: C111.1, IC2.D2 (SLP_XTAL_OUT), Y3.2

Notes on the sheet:
WL EN has internal pull down
Mic input, and digital outputs
RF Switch Control Lines
BT EN has internal pull down
External Memory/Flash
Connecting the output to the integrated PCB antenna
JTAG Pins

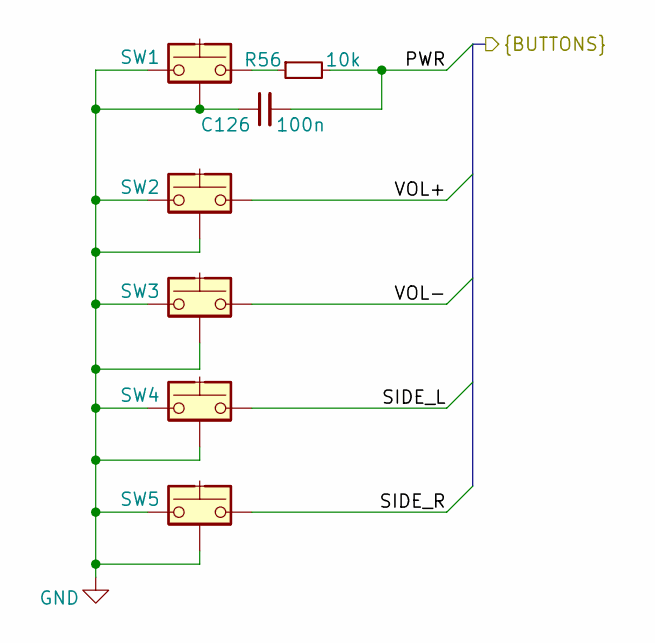
[picture p32: schematic buttons.kicad_sch]

Parts:
C126: 100n; C_0201_0603Metric
R56: 10k; R_0402_1005Metric
SW1, SW2, SW3, SW4, SW5: SW_Push_Shielded; SW_Push_1P1T-MP_NO_Horizontal_Alps_SKRTLAE010; MPN SKRTLAE010; LCSC C110293

Connections:
/Buttons/PWR: C126.2, R56.2; also elsewhere on the board
/Buttons/SIDE_L: SW4.2; also elsewhere on the board
/Buttons/SIDE_R: SW5.2; also elsewhere on the board
/Buttons/VOL+: SW2.2; also elsewhere on the board
/Buttons/VOL-: SW3.2; also elsewhere on the board
GND: C126.1, SW1.1, SW1.MP (B), SW2.1, SW2.MP (B), SW3.1, SW3.MP (B), SW4.1, SW4.MP (B), SW5.1, SW5.MP (B); also elsewhere on the board
unnamed: R56.1, SW1.2

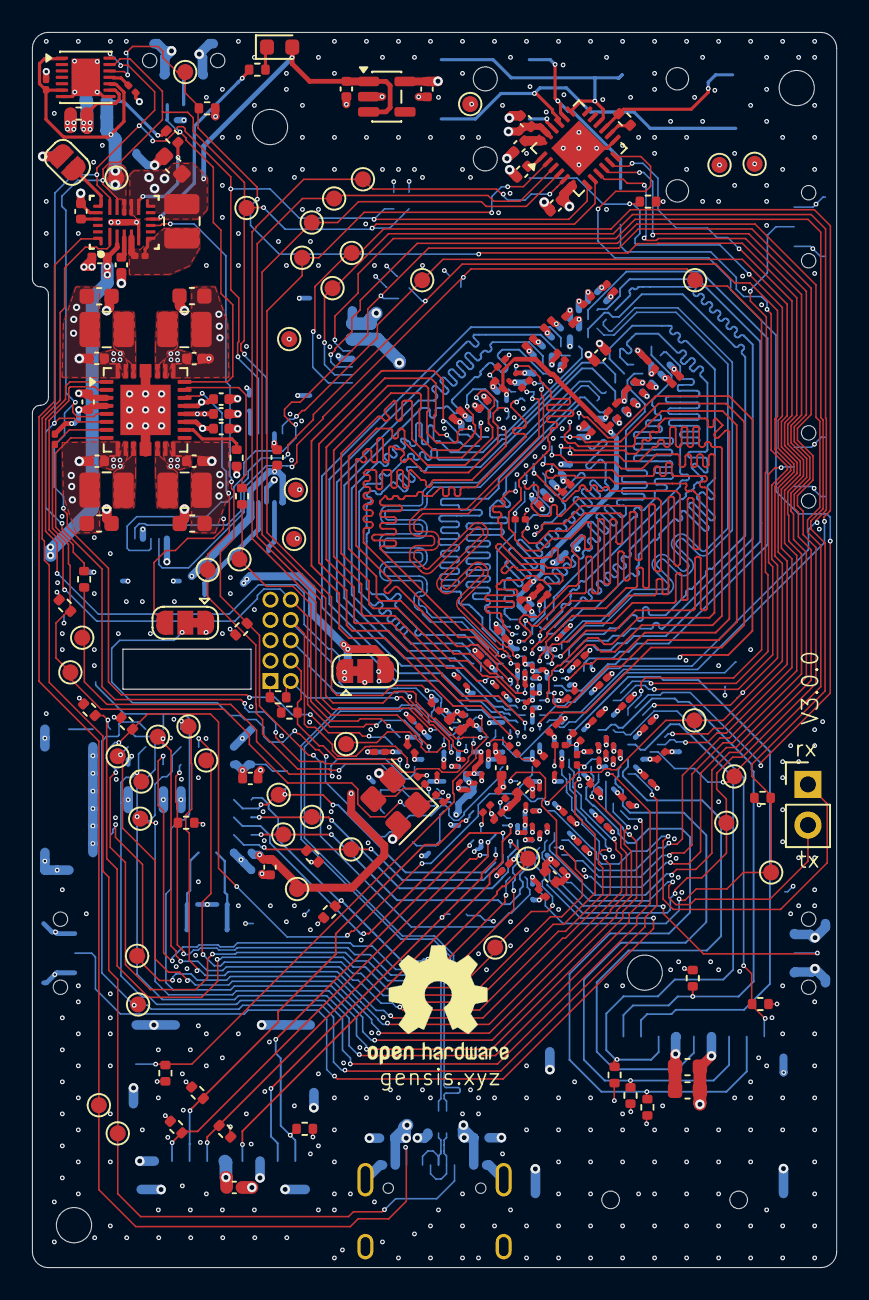
[picture p33: board meko.kicad_pcb from above]

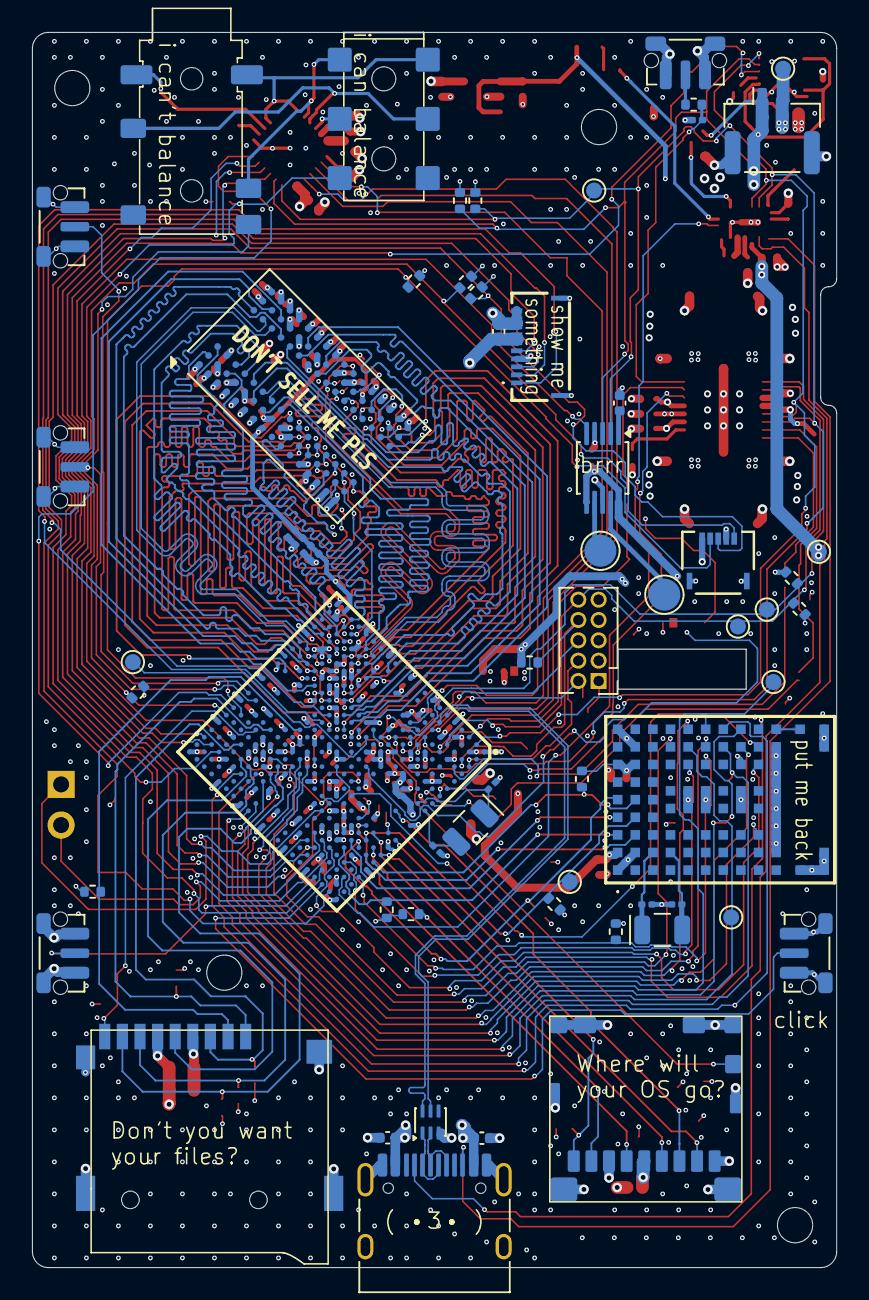
[picture p34: board meko.kicad_pcb from below]

Board: 6 copper layers, 50.2 x 77.2 mm, 275 parts (61 on the bottom side), 189 nets.
