KOEGlike/meko/hardware/pcb_touchpad/touchpad.kicad_pcb

## KiCad design hardware/pcb_touchpad/touchpad.kicad_pcb (2026-11-12)

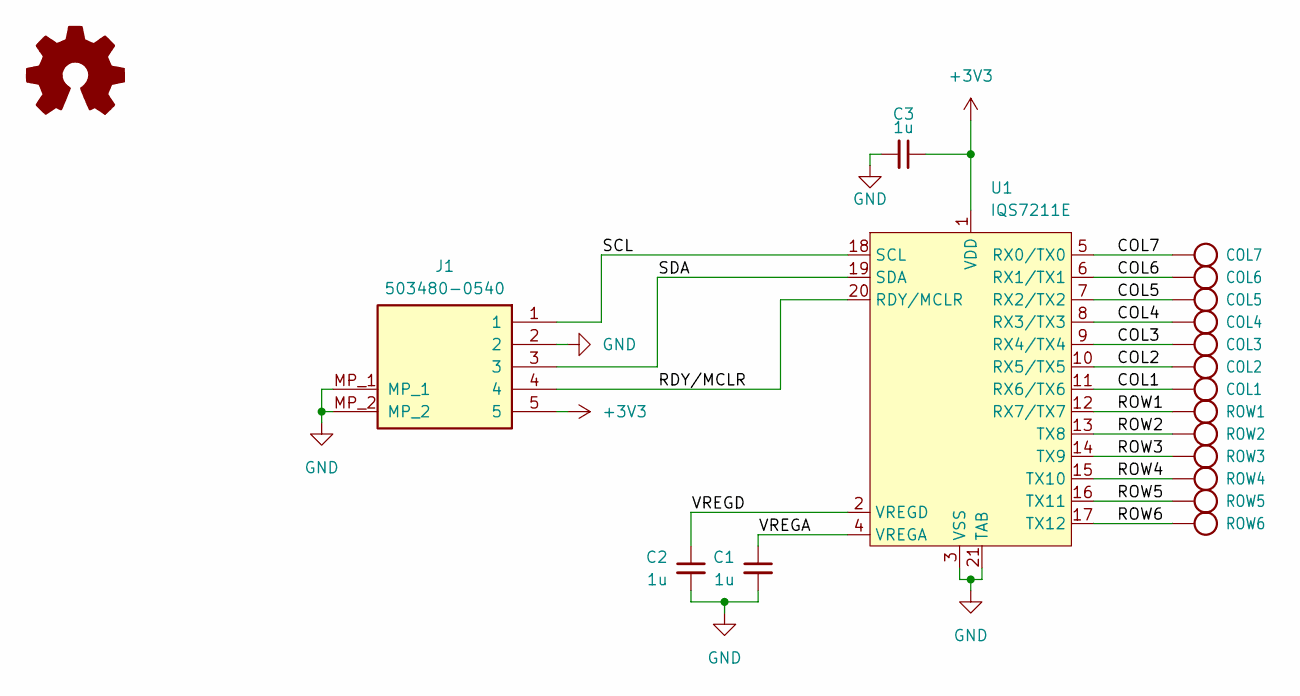
[picture p35: schematic touchpad.kicad_sch]

Parts:
C1, C2, C3: 1u; C_0402_1005Metric
COL1, COL2, COL3, COL4, COL5, COL6, COL7: TESTPOINTPAD_0_5MM; PAD_0_5MM
J1: 503480-0540; MPN 5034800540; LCSC C5527934
ROW1, ROW2, ROW3, ROW4, ROW5, ROW6: TESTPOINTPAD_0_5MM; PAD_0_5MM
SYM1: Logo_Open_Hardware_Small; OSHW-Logo2_14.6x12mm_SilkScreen
U1: IQS7211E; QFN-20-1EP_3x3mm_P0.4mm_EP1.65x1.65mm

Connections:
+3V3: C3.1, J1.5, U1.1 (VDD)
/COL1: COL1.P1 (P1_P1), U1.11 (RX6/TX6)
/COL2: COL2.P1 (P1_P1), U1.10 (RX5/TX5)
/COL3: COL3.P1 (P1_P1), U1.9 (RX4/TX4)
/COL4: COL4.P1 (P1_P1), U1.8 (RX3/TX3)
/COL5: COL5.P1 (P1_P1), U1.7 (RX2/TX2)
/COL6: COL6.P1 (P1_P1), U1.6 (RX1/TX1)
/COL7: COL7.P1 (P1_P1), U1.5 (RX0/TX0)
/RDY/MCLR: J1.4, U1.20 (RDY/MCLR)
/ROW1: ROW1.P1 (P1_P1), U1.12 (RX7/TX7)
/ROW2: ROW2.P1 (P1_P1), U1.13 (TX8)
/ROW3: ROW3.P1 (P1_P1), U1.14 (TX9)
/ROW4: ROW4.P1 (P1_P1), U1.15 (TX10)
/ROW5: ROW5.P1 (P1_P1), U1.16 (TX11)
/ROW6: ROW6.P1 (P1_P1), U1.17 (TX12)
/SCL: J1.1, U1.18 (SCL)
/SDA: J1.3, U1.19 (SDA)
/VREGA: C1.1, U1.4 (VREGA)
/VREGD: C2.1, U1.2 (VREGD)
GND: C1.2, C2.2, C3.2, J1.2, J1.MP_1, J1.MP_2, U1.3 (VSS), U1.21 (TAB)

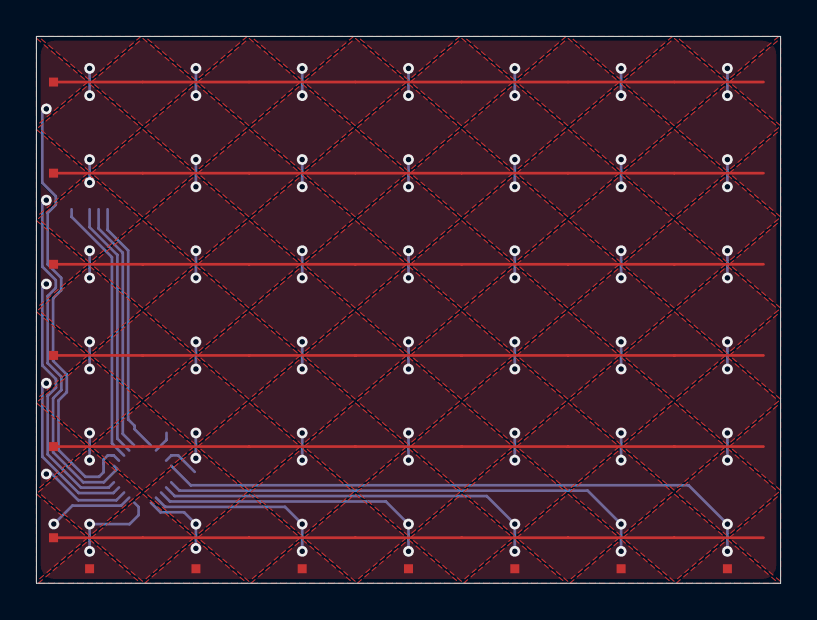
[picture p36: board touchpad.kicad_pcb from above]

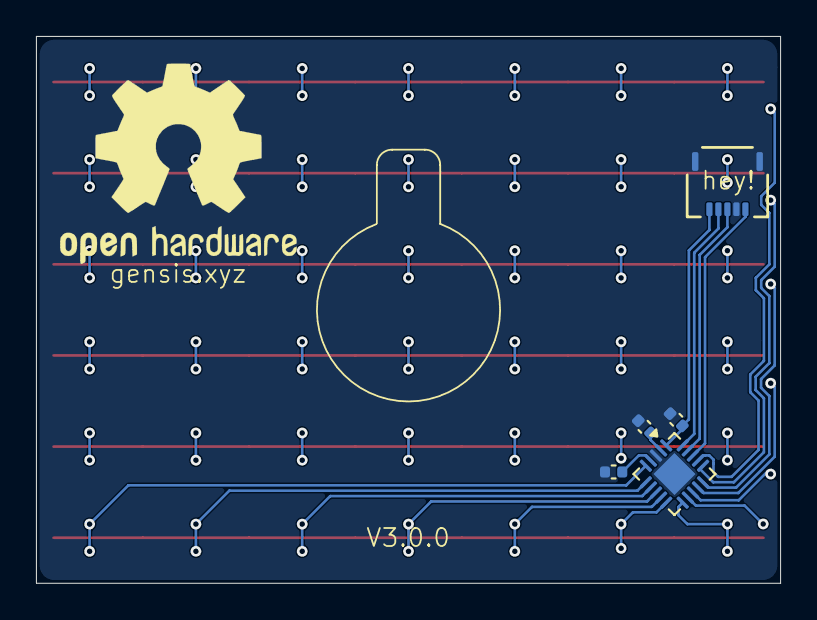
[picture p37: board touchpad.kicad_pcb from below]

Board: 2 copper layers, 41.3 x 30.4 mm, 19 parts (6 on the bottom side), 20 nets.
