KOEGlike/meko/hardware/pcb/audio.kicad_sch

## KiCad design hardware/pcb/audio.kicad_sch (2026-10-21, an earlier design)

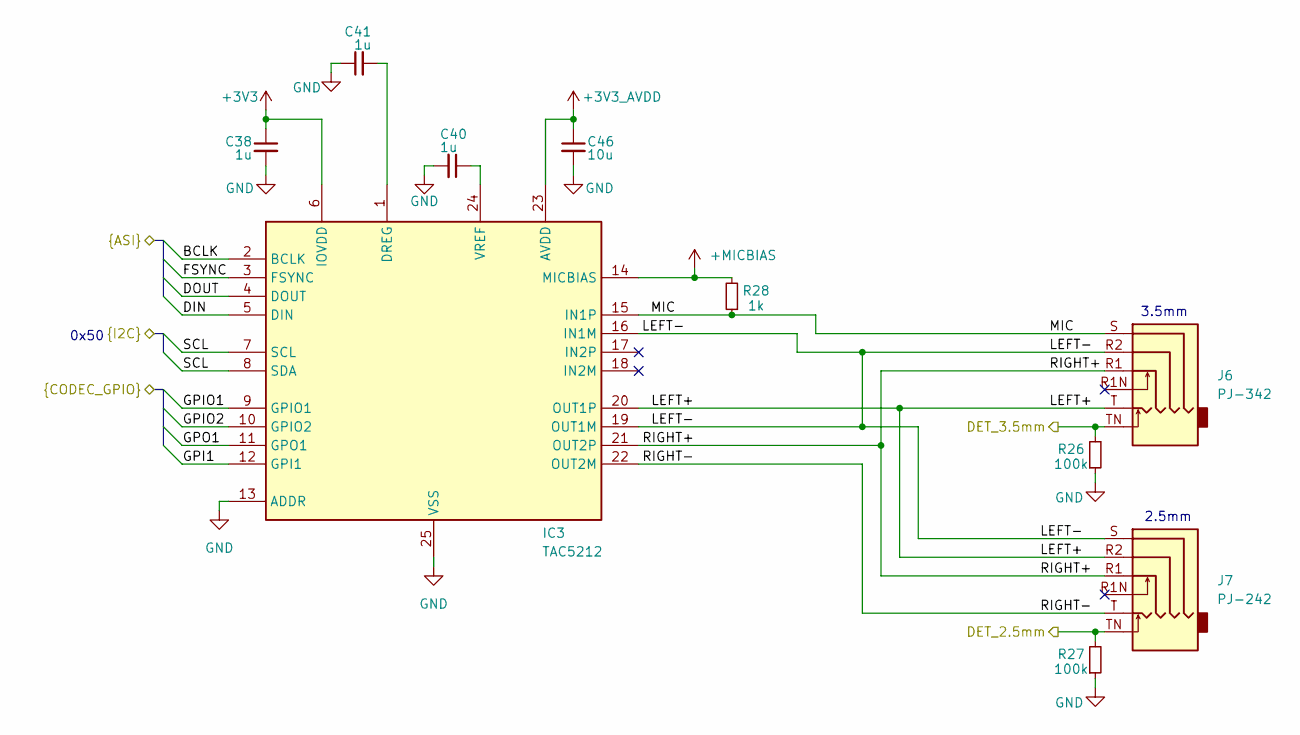
[picture p38: schematic audio.kicad_sch]

Parts:
C38, C40, C41: 1u
C46: 10u
IC3: TAC5212; VQFN-24-1EP_4x4mm_P0.5mm_EP2.45x2.45mm
J6: PJ-342; Jack_3.5mm_SHOUHAN_PJ-342; LCSC C668606
J7: PJ-242; Jack_2.5mm_PJ242_6P_12x6.2x4mm_Horizontal; LCSC C431536
R26, R27: 100k
R28: 1k

Connections:
+3V3: C38.1, IC3.6 (IOVDD)
+3V3_AVDD: C46.1, IC3.23 (AVDD)
+MICBIAS: IC3.14 (MICBIAS), R28.2
BCLK: IC3.2 (BCLK)
DET_2.5mm: J7.TN, R27.2
DET_3.5mm: J6.TN, R26.2
DIN: IC3.5 (DIN)
DOUT: IC3.4 (DOUT)
FSYNC: IC3.3 (FSYNC)
GND: C38.2, C40.2, C41.1, C46.2, IC3.13 (ADDR), IC3.25 (VSS), IC3.26 (VSS), IC3.27 (VSS), IC3.28 (VSS), IC3.29 (VSS), R26.1, R27.1
GPI1: IC3.12 (GPI1)
GPIO1: IC3.9 (GPIO1)
GPIO2: IC3.10 (GPIO2)
GPO1: IC3.11 (GPO1)
LEFT+: IC3.20 (OUT1P), J6.T, J7.R2
LEFT-: IC3.16 (IN1M), IC3.19 (OUT1M), J6.R2, J7.S
MIC: IC3.15 (IN1P), J6.S, R28.1
unnamed: C40.1, IC3.24 (VREF)
unnamed: C41.2, IC3.1 (DREG)
RIGHT+: IC3.21 (OUT2P), J6.R1, J7.R1
RIGHT-: IC3.22 (OUT2M), J7.T
SCL: IC3.7 (SCL), IC3.8 (SDA)

Notes on the sheet:
3.5mm
2.5mm
0x50
