KOEGlike/meko/hardware/pcb/ddr.kicad_sch

## KiCad design hardware/pcb/ddr.kicad_sch (2026-11-04, an earlier design)

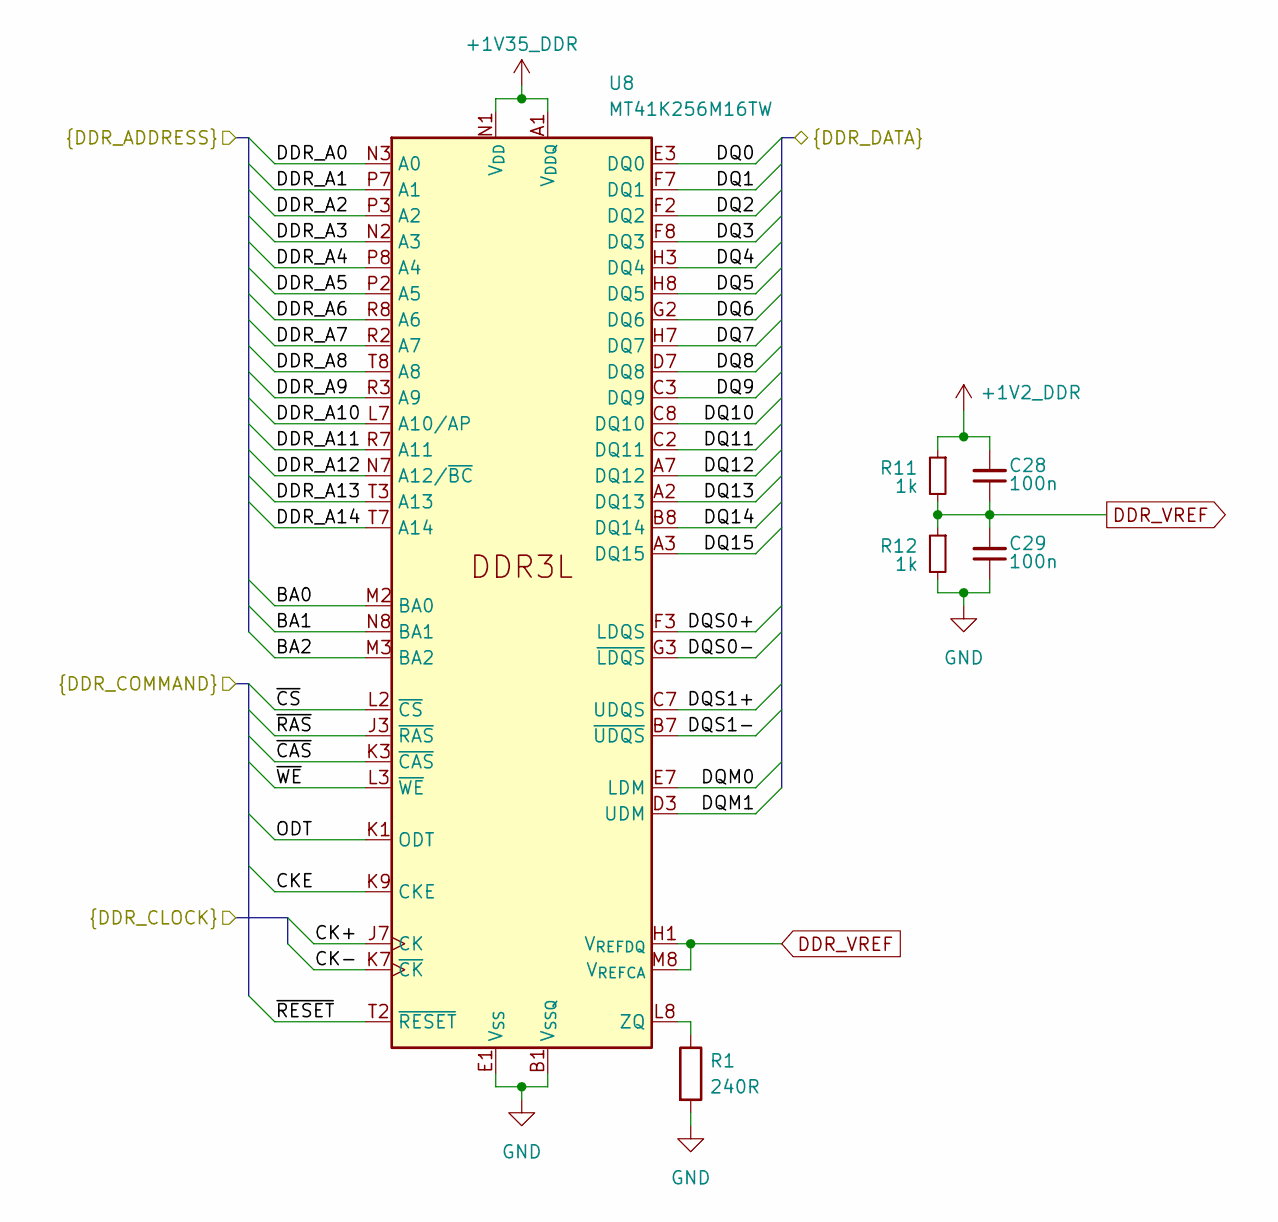
[picture p39: schematic ddr.kicad_sch]

Parts:
C28, C29: 100n
R1: 240R
R11, R12: 1k
U8: MT41K256M16TW; Micron_FBGA-96_8x14mm_Layout9x16_P0.8mm; LCSC C253882

Connections:
+1V2_DDR: C28.2, R11.1
+1V35_DDR: U8.A1 (V_{DDQ}), U8.A8 (V_{DDQ}), U8.B2 (V_{DD}), U8.C1 (V_{DDQ}), U8.C9 (V_{DDQ}), U8.D2 (V_{DDQ}), U8.D9 (V_{DD}), U8.E9 (V_{DDQ}), U8.F1 (V_{DDQ}), U8.G7 (V_{DD}), U8.H2 (V_{DDQ}), U8.H9 (V_{DDQ}), U8.K2 (V_{DD}), U8.K8 (V_{DD}), U8.N1 (V_{DD}), U8.N9 (V_{DD}), U8.R1 (V_{DD}), U8.R9 (V_{DD})
BA0: U8.M2 (BA0)
BA1: U8.N8 (BA1)
BA2: U8.M3 (BA2)
CK+: U8.J7 (CK)
CK-: U8.K7 (~CK)
CKE: U8.K9 (CKE)
DDR_A0: U8.N3 (A0)
DDR_A1: U8.P7 (A1)
DDR_A2: U8.P3 (A2)
DDR_A3: U8.N2 (A3)
DDR_A4: U8.P8 (A4)
DDR_A5: U8.P2 (A5)
DDR_A6: U8.R8 (A6)
DDR_A7: U8.R2 (A7)
DDR_A8: U8.T8 (A8)
DDR_A9: U8.R3 (A9)
DDR_A10: U8.L7 (A10/AP)
DDR_A11: U8.R7 (A11)
DDR_A12: U8.N7 (A12/~BC)
DDR_A13: U8.T3 (A13)
DDR_A14: U8.T7 (A14)
DDR_VREF: C28.1, C29.2, R11.2, R12.1, U8.H1 (V_{REFDQ}), U8.M8 (V_{REFCA})
DQ0: U8.E3 (DQ0)
DQ1: U8.F7 (DQ1)
DQ2: U8.F2 (DQ2)
DQ3: U8.F8 (DQ3)
DQ4: U8.H3 (DQ4)
DQ5: U8.H8 (DQ5)
DQ6: U8.G2 (DQ6)
DQ7: U8.H7 (DQ7)
DQ8: U8.D7 (DQ8)
DQ9: U8.C3 (DQ9)
DQ10: U8.C8 (DQ10)
DQ11: U8.C2 (DQ11)
DQ12: U8.A7 (DQ12)
DQ13: U8.A2 (DQ13)
DQ14: U8.B8 (DQ14)
DQ15: U8.A3 (DQ15)
DQM0: U8.E7 (LDM)
DQM1: U8.D3 (UDM)
DQS0+: U8.F3 (LDQS)
DQS0-: U8.G3 (~LDQS)
DQS1+: U8.C7 (UDQS)
DQS1-: U8.B7 (~UDQS)
GND: C29.1, R1.2, R12.2, U8.A9 (V_{SS}), U8.B1 (V_{SSQ}), U8.B3 (V_{SS}), U8.B9 (V_{SSQ}), U8.D1 (V_{SSQ}), U8.D8 (V_{SSQ}), U8.E1 (V_{SS}), U8.E2 (V_{SSQ}), U8.E8 (V_{SSQ}), U8.F9 (V_{SSQ}), U8.G1 (V_{SSQ}), U8.G8 (V_{SS}), U8.G9 (V_{SSQ}), U8.J2 (V_{SS}), U8.J8 (V_{SS}), U8.M1 (V_{SS}), U8.M9 (V_{SS}), U8.P1 (V_{SS}), U8.P9 (V_{SS}), U8.T1 (V_{SS}), U8.T9 (V_{SS})
unnamed: R1.1, U8.L8 (ZQ)
ODT: U8.K1 (ODT)
~CAS: U8.K3 (~CAS)
~CS: U8.L2 (~CS)
~RAS: U8.J3 (~RAS)
~RESET: U8.T2 (~RESET)
~WE: U8.L3 (~WE)
