KOEGlike/meko/hardware/pcb/display.kicad_sch

## KiCad design hardware/pcb/display.kicad_sch (2026-10-22, an earlier design)

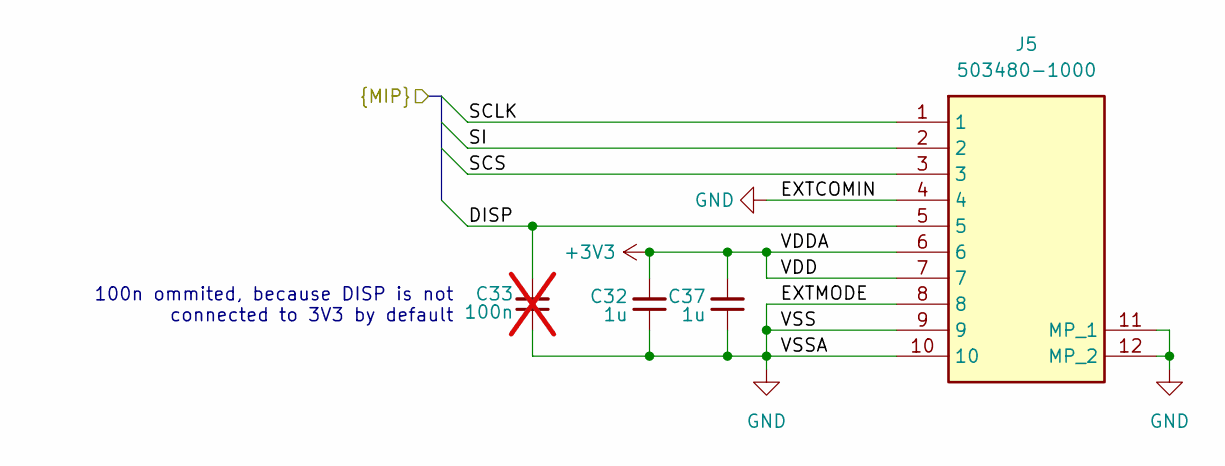
[picture p40: schematic display.kicad_sch]

Parts:
C32, C37: 1u
C33: 100n; not fitted
J5: 503480-1000; 5034801000; MPN 503480-1000

Connections:
+3V3: C32.2, C37.2, J5.6, J5.7
DISP: C33.2, J5.5
GND: C32.1, C33.1, C37.1, J5.4, J5.8, J5.9, J5.10, J5.11 (MP_1), J5.12 (MP_2)
SCLK: J5.1
SCS: J5.3
SI: J5.2

Notes on the sheet:
100n ommited, because DISP is not connected to 3V3 by default
