KOEGlike/meko/hardware/pcb/power.kicad_sch

## KiCad design hardware/pcb/power.kicad_sch (2026-11-11, an earlier design)

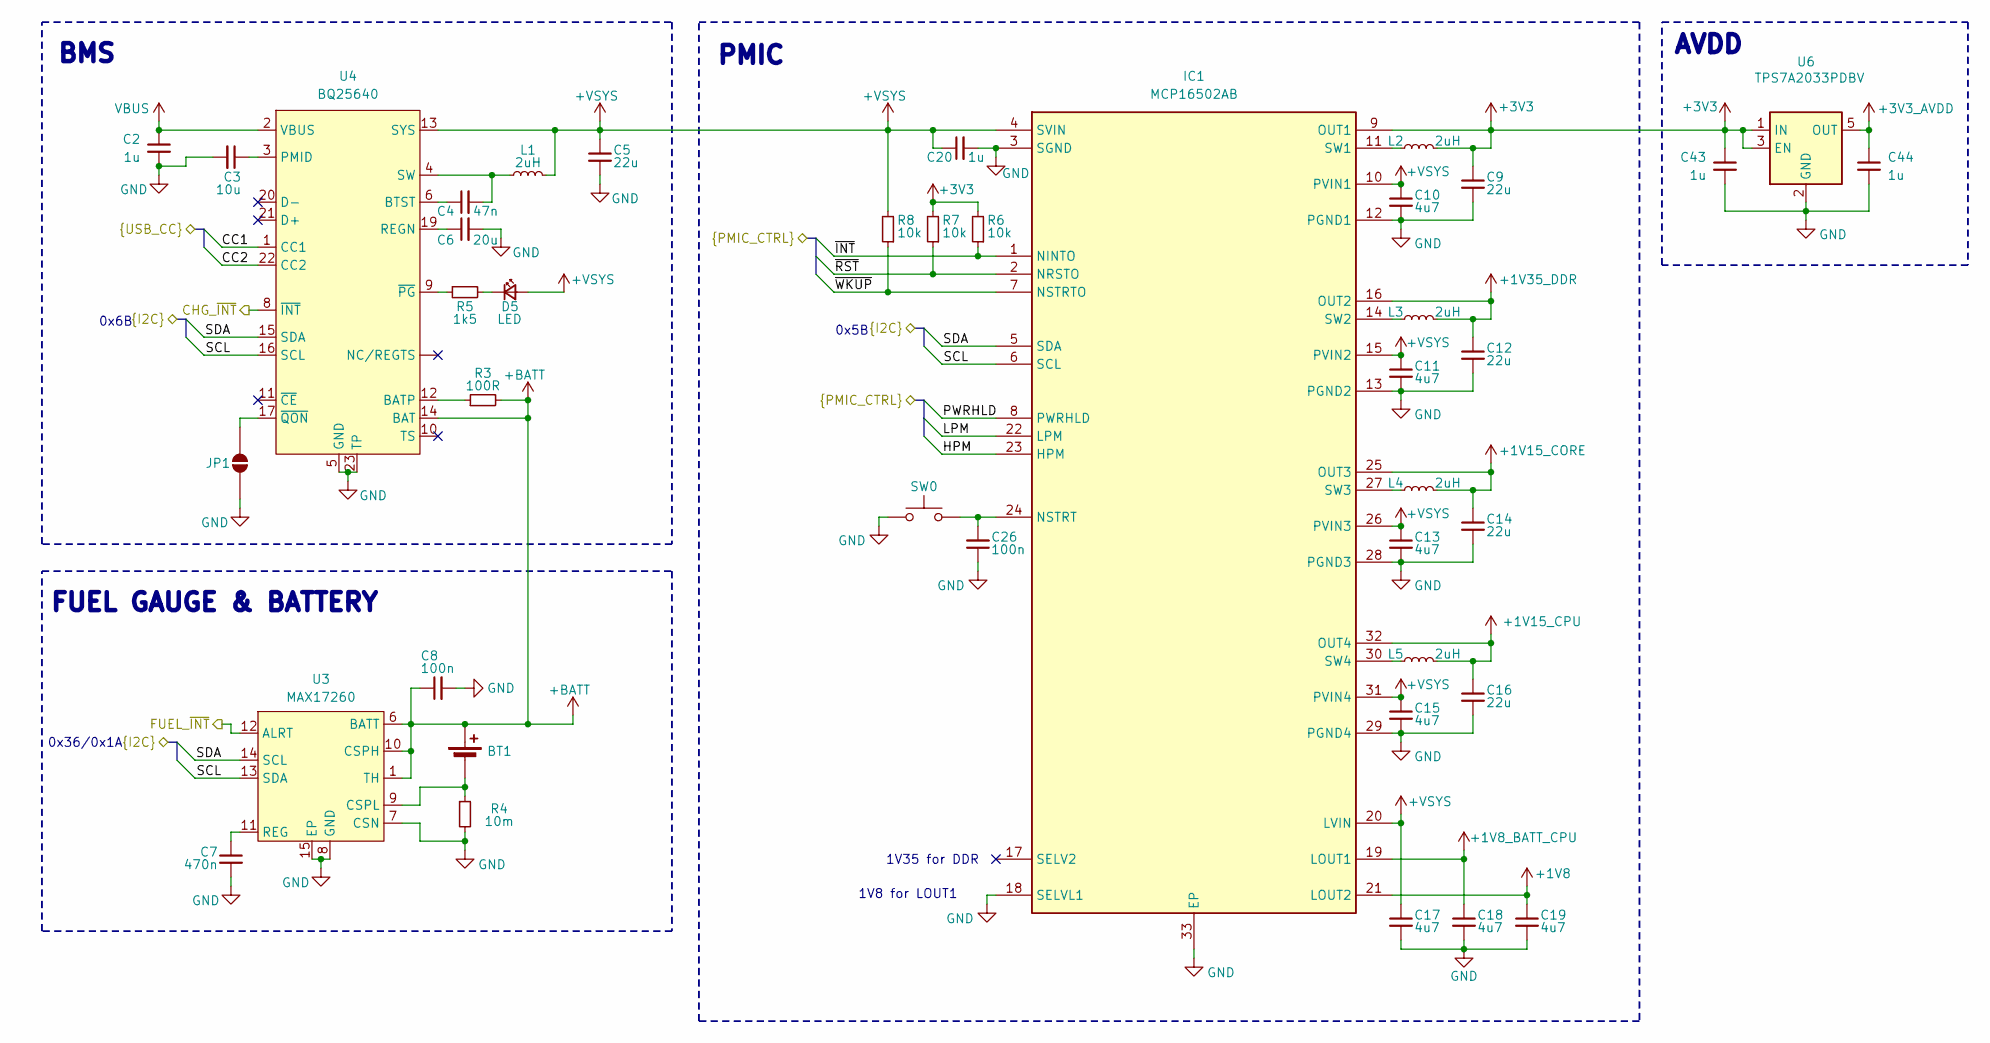
[picture p41: schematic power.kicad_sch]

Parts:
BT1: Battery_Cell
C2, C20, C43, C44: 1u
C3: 10u
C4: 47n
C5, C9, C12, C14, C16: 22u
C6: 20u
C7: 470n
C8, C26: 100n
C10, C11, C13, C15, C17, C18, C19: 4u7
D5: LED; LED_0603_1608Metric; LCSC C965808
IC1: MCP16502AB; VQFN-32-1EP_5x5mm_P0.5mm_EP3.15x3.15mm; MPN MCP16502AB
JP1: SolderJumper_2_Open
L1, L2, L3, L4, L5: 2uH
R3: 100R
R4: 10m
R5: 1k5
R6, R7, R8: 10k
SW0: SW_Push
U3: MAX17260; TDFN-14-1EP_3x3mm_P0.4mm_EP1.78x2.35mm
U4: BQ25640
U6: TPS7A2033PDBV; SOT-23-5

Connections:
+1V8: C19.1, IC1.21 (LOUT2)
+1V8_BATT_CPU: C18.1, IC1.19 (LOUT1)
+1V15_CORE: C14.1, IC1.25 (OUT3), L4.2
+1V15_CPU: C16.1, IC1.32 (OUT4), L5.2
+1V35_DDR: C12.1, IC1.16 (OUT2), L3.2
+3V3: C9.1, C43.1, IC1.9 (OUT1), L2.2, R6.2, R7.2, U6.1 (IN), U6.3 (EN)
+3V3_AVDD: C44.1, U6.5 (OUT)
+BATT: BT1.1 (+), C8.1, R3.2, U3.1 (TH), U3.6 (BATT), U3.10 (CSPH), U4.14 (BAT)
+VSYS: C5.1, C10.1, C11.1, C13.1, C15.1, C17.1, C20.1, D5.2 (A), IC1.4 (SVIN), IC1.10 (PVIN1), IC1.15 (PVIN2), IC1.20 (LVIN), IC1.26 (PVIN3), IC1.31 (PVIN4), L1.2, R8.2, U4.13 (SYS)
CC1: U4.1 (CC1)
CC2: U4.22 (CC2)
CHG_~INT: U4.8 (~INT)
FUEL_~INT: U3.12 (ALRT)
GND: C2.2, C3.2, C5.2, C6.2, C7.2, C8.2, C9.2, C10.2, C11.2, C12.2, C13.2, C14.2, C15.2, C16.2, C17.2, C18.2, C19.2, C20.2, C26.1, C43.2, C44.2, IC1.3 (SGND), IC1.12 (PGND1), IC1.13 (PGND2), IC1.18 (SELVL1), IC1.28 (PGND3), IC1.29 (PGND4), IC1.33 (EP), JP1.1 (A), R4.2, SW0.1, U3.7 (CSN), U3.8 (GND), U3.15 (EP), U4.5 (GND), U4.18 (GND), U4.23 (TP), U6.2 (GND)
HPM: IC1.23 (HPM)
LPM: IC1.22 (LPM)
unnamed: BT1.2 (-), R4.1, U3.9 (CSPL)
unnamed: C3.1, U4.3 (PMID)
unnamed: C4.1, U4.6 (BTST)
unnamed: C4.2, L1.1, U4.4 (SW)
unnamed: C6.1, U4.19 (REGN)
unnamed: C7.1, U3.11 (REG)
unnamed: C26.2, IC1.24 (NSTRT), SW0.2
unnamed: D5.1 (K), R5.2
unnamed: IC1.11 (SW1), L2.1
unnamed: IC1.14 (SW2), L3.1
unnamed: IC1.27 (SW3), L4.1
unnamed: IC1.30 (SW4), L5.1
unnamed: JP1.2 (B), U4.17 (~QON)
unnamed: R3.1, U4.12 (BATP)
unnamed: R5.1, U4.9 (~PG)
unnamed: U3.2 (NC), U3.3 (NC), U3.4 (NC), U3.5 (NC)
PWRHLD: IC1.8 (PWRHLD)
SCL: IC1.6 (SCL), U3.13 (SDA), U4.16 (SCL)
SDA: IC1.5 (SDA), U3.14 (SCL), U4.15 (SDA)
VBUS: C2.1, U4.2 (VBUS)
~INT: IC1.1 (NINTO), R6.1
~RST: IC1.2 (NRSTO), R7.1
~WKUP: IC1.7 (NSTRTO), R8.1

Notes on the sheet:
0x5B
0x6B
0x36/0x1A
1V35 for DDR
PMIC
BMS
AVDD
1V8 for LOUT1
FUEL GAUGE & BATTERY
