KOEGlike/meko/hardware/pcb/sama.kicad_sch

## KiCad design hardware/pcb/sama.kicad_sch (2026-11-08, an earlier design)

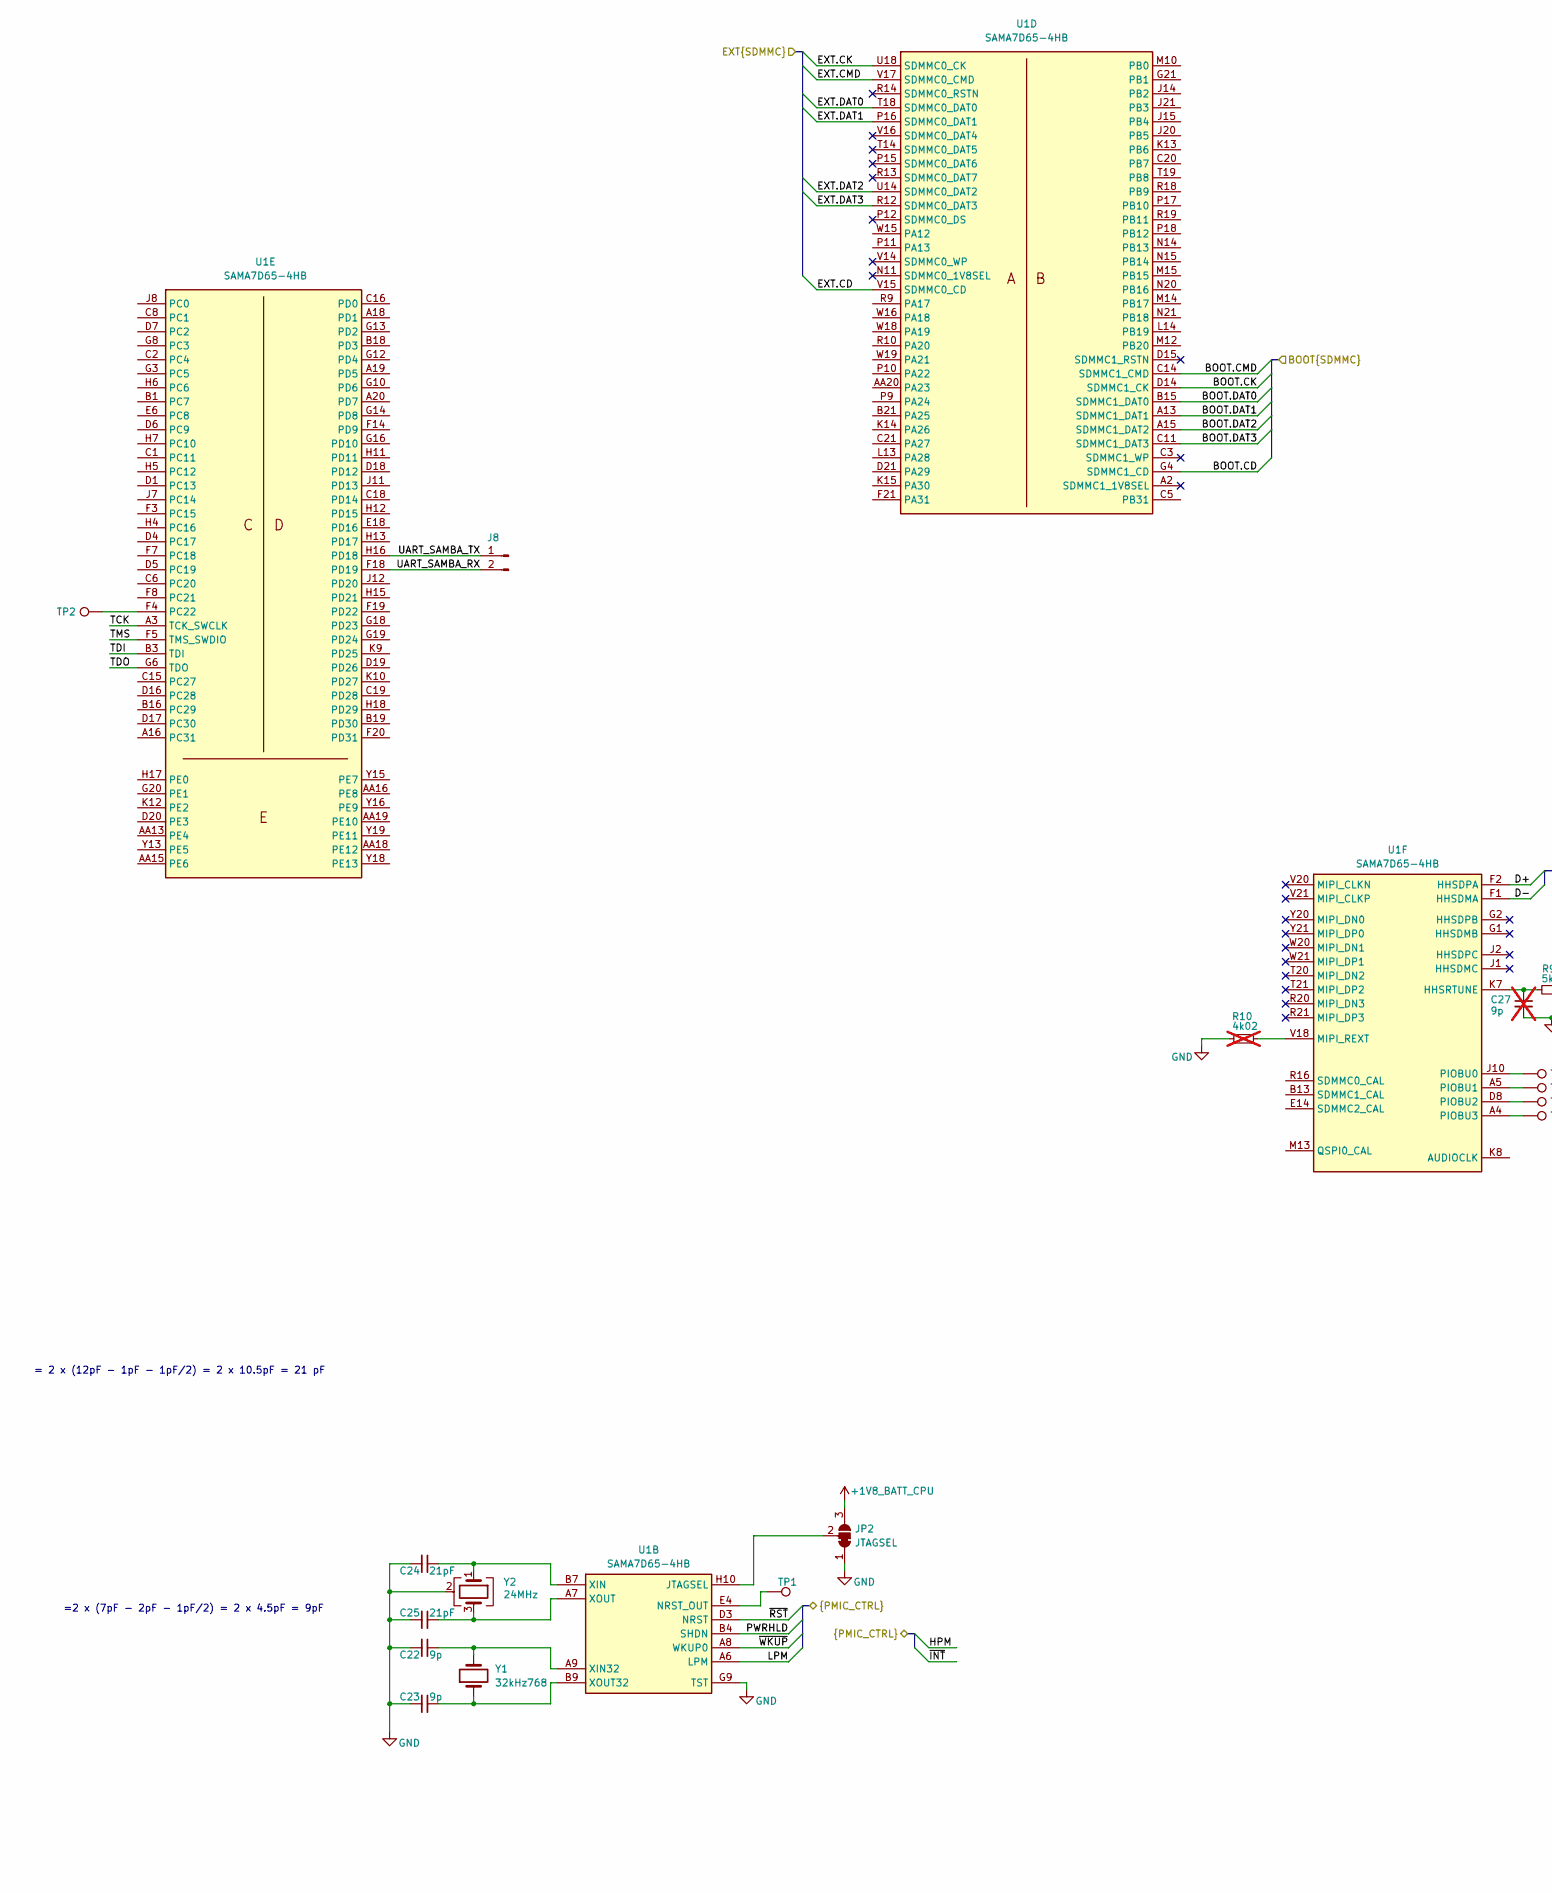
[picture p42: schematic sama.kicad_sch, part in row 1, column 1]

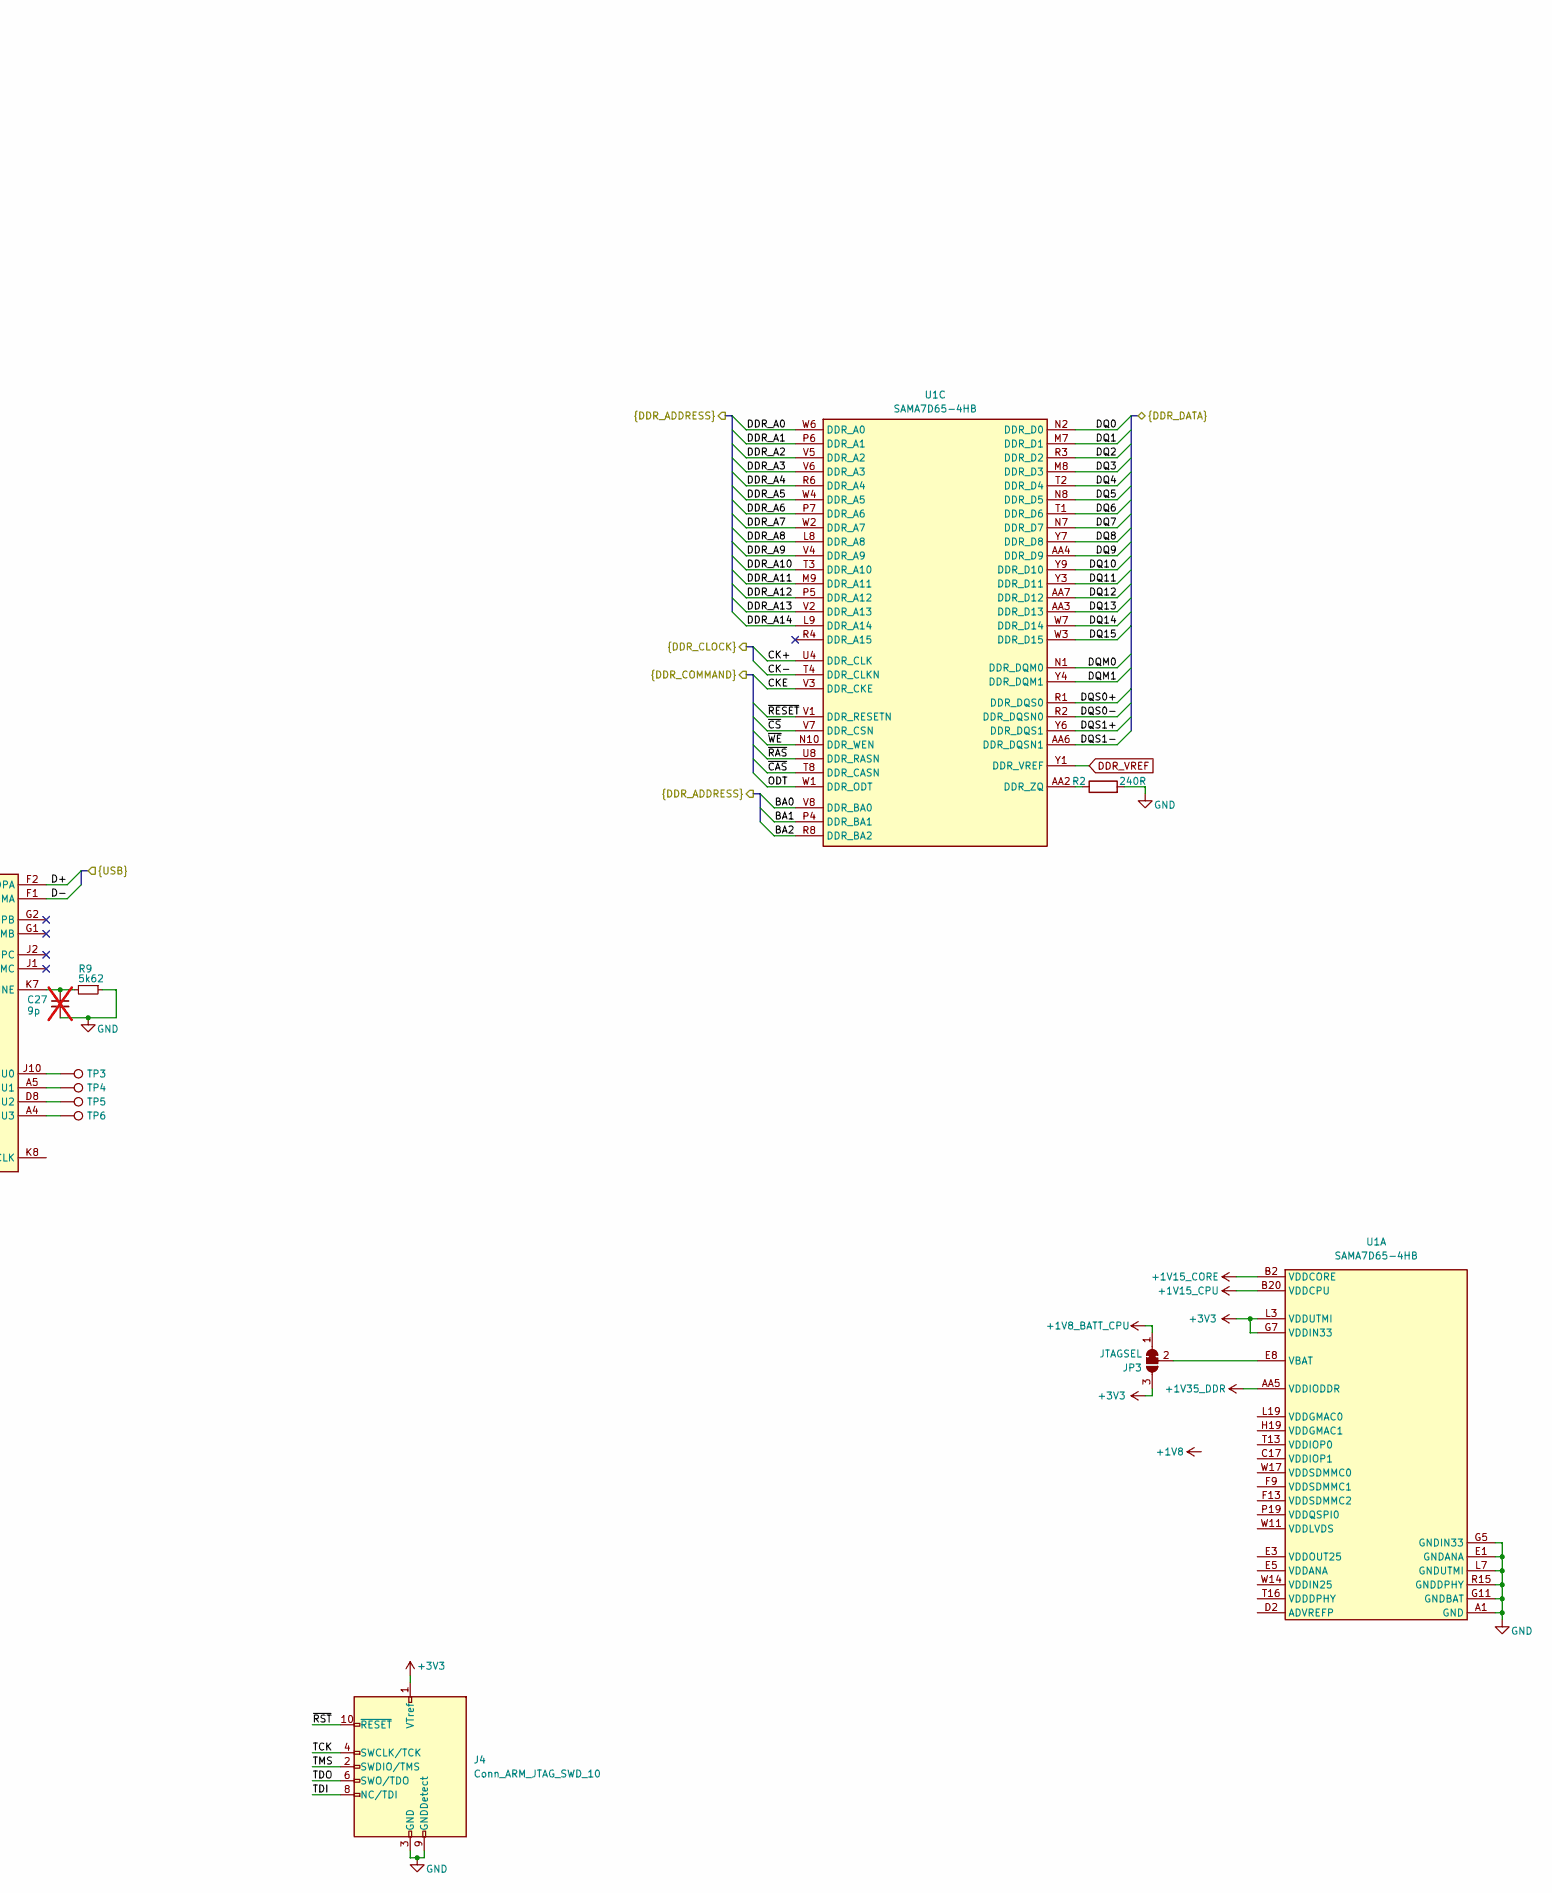
[picture p43: schematic sama.kicad_sch, part in row 1, column 2]

Parts:
C22, C23: 9p
C24, C25: 21pF
C27: 9p; not fitted
J4: Conn_ARM_JTAG_SWD_10; PinHeader_2x05_P1.27mm_Vertical_SMD
J8: Conn_01x02_Pin
JP2, JP3: JTAGSEL
R2: 240R
R9: 5k62
R10: 4k02; not fitted
TP1: ~{RST_OUT}
TP2, TP3, TP4, TP5, TP6: ~{TRST}
U1: SAMA7D65-4HB; Microchip_4HB_TFBGA-343_14x14mm_Layout21x21_P0.65mm
Y1: 32kHz768; Crystal_SMD_MicroCrystal_CC7V-T1A-2Pin_3.2x1.5mm; MPN SC-32S32.768kHz20PPM7pF
Y2: 24MHz; Crystal_SMD_3225-4Pin_3.2x2.5mm; MPN SX32Y024000BC1T001; LCSC C7420736

Connections:
+1V8_BATT_CPU: JP2.3 (B), JP3.1 (A)
+1V15_CORE: U1.B2 (VDDCORE), U1.F6 (VDDCORE), U1.F15 (VDDCORE), U1.H3 (VDDCORE), U1.J9 (VDDCORE), U1.J13 (VDDCORE), U1.J16 (VDDCORE), U1.N13 (VDDCORE), U1.N16 (VDDCORE), U1.T15 (VDDCORE), U1.U16 (VDDCORE), U1.U17 (VDDCORE), U1.U19 (VDDCORE), U1.V19 (VDDCORE)
+1V15_CPU: U1.B20 (VDDCPU), U1.E16 (VDDCPU), U1.E17 (VDDCPU), U1.E19 (VDDCPU), U1.F17 (VDDCPU)
+1V35_DDR: U1.AA5 (VDDIODDR), U1.M11 (VDDIODDR), U1.N6 (VDDIODDR), U1.N9 (VDDIODDR), U1.N12 (VDDIODDR), U1.P3 (VDDIODDR), U1.P13 (VDDIODDR), U1.T6 (VDDIODDR), U1.T7 (VDDIODDR), U1.T9 (VDDIODDR), U1.U3 (VDDIODDR), U1.U5 (VDDIODDR), U1.U6 (VDDIODDR), U1.W8 (VDDIODDR), U1.Y2 (VDDIODDR)
+3V3: J4.1 (VTref), JP3.3 (B), U1.G7 (VDDIN33), U1.L3 (VDDUTMI)
BA0: U1.V8 (DDR_BA0)
BA1: U1.P4 (DDR_BA1)
BA2: U1.R8 (DDR_BA2)
BOOT.CD: U1.G4 (PB29)
BOOT.CK: U1.D14 (PB23)
BOOT.CMD: U1.C14 (PB22)
BOOT.DAT0: U1.B15 (PB24)
BOOT.DAT1: U1.A13 (PB25)
BOOT.DAT2: U1.A15 (PB26)
BOOT.DAT3: U1.C11 (PB27)
CK+: U1.U4 (DDR_CLK)
CK-: U1.T4 (DDR_CLKN)
CKE: U1.V3 (DDR_CKE)
D+: U1.F2 (HHSDPA)
D-: U1.F1 (HHSDMA)
DDR_A0: U1.W6 (DDR_A0)
DDR_A1: U1.P6 (DDR_A1)
DDR_A2: U1.V5 (DDR_A2)
DDR_A3: U1.V6 (DDR_A3)
DDR_A4: U1.R6 (DDR_A4)
DDR_A5: U1.W4 (DDR_A5)
DDR_A6: U1.P7 (DDR_A6)
DDR_A7: U1.W2 (DDR_A7)
DDR_A8: U1.L8 (DDR_A8)
DDR_A9: U1.V4 (DDR_A9)
DDR_A10: U1.T3 (DDR_A10)
DDR_A11: U1.M9 (DDR_A11)
DDR_A12: U1.P5 (DDR_A12)
DDR_A13: U1.V2 (DDR_A13)
DDR_A14: U1.L9 (DDR_A14)
DDR_VREF: U1.Y1 (DDR_VREF)
DQ0: U1.N2 (DDR_D0)
DQ1: U1.M7 (DDR_D1)
DQ2: U1.R3 (DDR_D2)
DQ3: U1.M8 (DDR_D3)
DQ4: U1.T2 (DDR_D4)
DQ5: U1.N8 (DDR_D5)
DQ6: U1.T1 (DDR_D6)
DQ7: U1.N7 (DDR_D7)
DQ8: U1.Y7 (DDR_D8)
DQ9: U1.AA4 (DDR_D9)
DQ10: U1.Y9 (DDR_D10)
DQ11: U1.Y3 (DDR_D11)
DQ12: U1.AA7 (DDR_D12)
DQ13: U1.AA3 (DDR_D13)
DQ14: U1.W7 (DDR_D14)
DQ15: U1.W3 (DDR_D15)
DQM0: U1.N1 (DDR_DQM0)
DQM1: U1.Y4 (DDR_DQM1)
DQS0+: U1.R1 (DDR_DQS0)
DQS0-: U1.R2 (DDR_DQSN0)
DQS1+: U1.Y6 (DDR_DQS1)
DQS1-: U1.AA6 (DDR_DQSN1)
EXT.CD: U1.V15 (PA16)
EXT.CK: U1.U18 (PA0)
EXT.CMD: U1.V17 (PA1)
EXT.DAT0: U1.T18 (PA3)
EXT.DAT1: U1.P16 (PA4)
EXT.DAT2: U1.U14 (PA9)
EXT.DAT3: U1.R12 (PA10)
GND: C22.2, C23.2, C24.2, C25.2, C27.2, J4.3 (GND), J4.5 (GND), J4.9 (GNDDetect), JP2.1 (A), R2.2, R9.1, R10.2, U1.A1 (GND), U1.A11 (GND), U1.A14 (GND), U1.A17 (GND), U1.A21 (GND), U1.AA1 (GND), U1.AA8 (GND), U1.AA9 (GND), U1.AA11 (GND), U1.AA14 (GND), U1.AA17 (GND), U1.AA21 (GND), U1.B6 (GND), U1.C4 (GND), U1.C7 (GND), U1.D9 (GND), U1.D13 (GND), U1.E1 (GNDANA), U1.E7 (GNDANA), U1.E15 (GND), U1.E21 (GND), U1.F16 (GND), U1.G5 (GNDIN33), U1.G9 (TST), U1.G11 (GNDBAT), U1.G15 (GND), U1.G17 (GND), U1.H1 (GNDANA), U1.H8 (GND), U1.H9 (GND), U1.H14 (GND), U1.H21 (GND), U1.J4 (GND), U1.J18 (GND), U1.K11 (GND), U1.L1 (GND), U1.L7 (GNDUTMI), U1.L11 (GND), U1.L15 (GND), U1.L21 (GND), U1.N4 (GND), U1.N18 (GND), U1.P1 (GND), U1.P8 (GND), U1.P14 (GND), U1.P21 (GND), U1.R5 (GND), U1.R7 (GND), U1.R11 (GND), U1.R15 (GNDDPHY), U1.R17 (GND), U1.T5 (GND), U1.T17 (GND), U1.U1 (GND), U1.U7 (GND), U1.U15 (GNDDPHY), U1.U21 (GND), U1.V9 (GNDANA), U1.V13 (GND), U1.W5 (GND), Y2.2 (G), Y2.4 (G)
LPM: U1.A6 (LPM)
unnamed: C22.1, U1.A9 (XIN32), Y1.2
unnamed: C23.1, U1.B9 (XOUT32), Y1.1
unnamed: C24.1, U1.B7 (XIN), Y2.1
unnamed: C25.1, U1.A7 (XOUT), Y2.3
unnamed: C27.1, R9.2, U1.K7 (HHSRTUNE)
unnamed: JP2.2 (C), U1.H10 (JTAGSEL)
unnamed: JP3.2 (C), U1.E8 (VBAT)
unnamed: R2.1, U1.AA2 (DDR_ZQ)
unnamed: R10.1, U1.V18 (MIPI_REXT)
unnamed: TP1.1, U1.E4 (NRST_OUT)
unnamed: TP2.1, U1.F4 (PC22)
unnamed: TP3.1, U1.J10 (PIOBU0(6))
unnamed: TP4.1, U1.A5 (PIOBU1(6))
unnamed: TP5.1, U1.D8 (PIOBU2(6))
unnamed: TP6.1, U1.A4 (PIOBU3(6))
unnamed: U1.E5 (VDDANA), U1.J6 (VDDANA)
ODT: U1.W1 (DDR_ODT)
PWRHLD: U1.B4 (SHDN)
TCK: J4.4 (SWCLK/TCK), U1.A3 (PC23)
TDI: J4.8 (NC/TDI), U1.B3 (PC25)
TDO: J4.6 (SWO/TDO), U1.G6 (PC26)
TMS: J4.2 (SWDIO/TMS), U1.F5 (PC24)
UART_SAMBA_RX: J8.2, U1.F18 (PD19)
UART_SAMBA_TX: J8.1, U1.H16 (PD18)
~CAS: U1.T8 (DDR_CASN)
~CS: U1.V7 (DDR_CSN)
~RAS: U1.U8 (DDR_RASN)
~RESET: U1.V1 (DDR_RESETN)
~RST: J4.10 (~RESET), U1.D3 (NRST)
~WE: U1.N10 (DDR_WEN)
~WKUP: U1.A8 (WKUP0)

Notes on the sheet:
=2 x (7pF - 2pF - 1pF/2) = 2 x 4.5pF = 9pF
= 2 x (12pF - 1pF - 1pF/2) = 2 x 10.5pF = 21 pF
