KOEGlike/meko/hardware/pcb/sd.kicad_sch

## KiCad design hardware/pcb/sd.kicad_sch (2026-10-21, an earlier design)

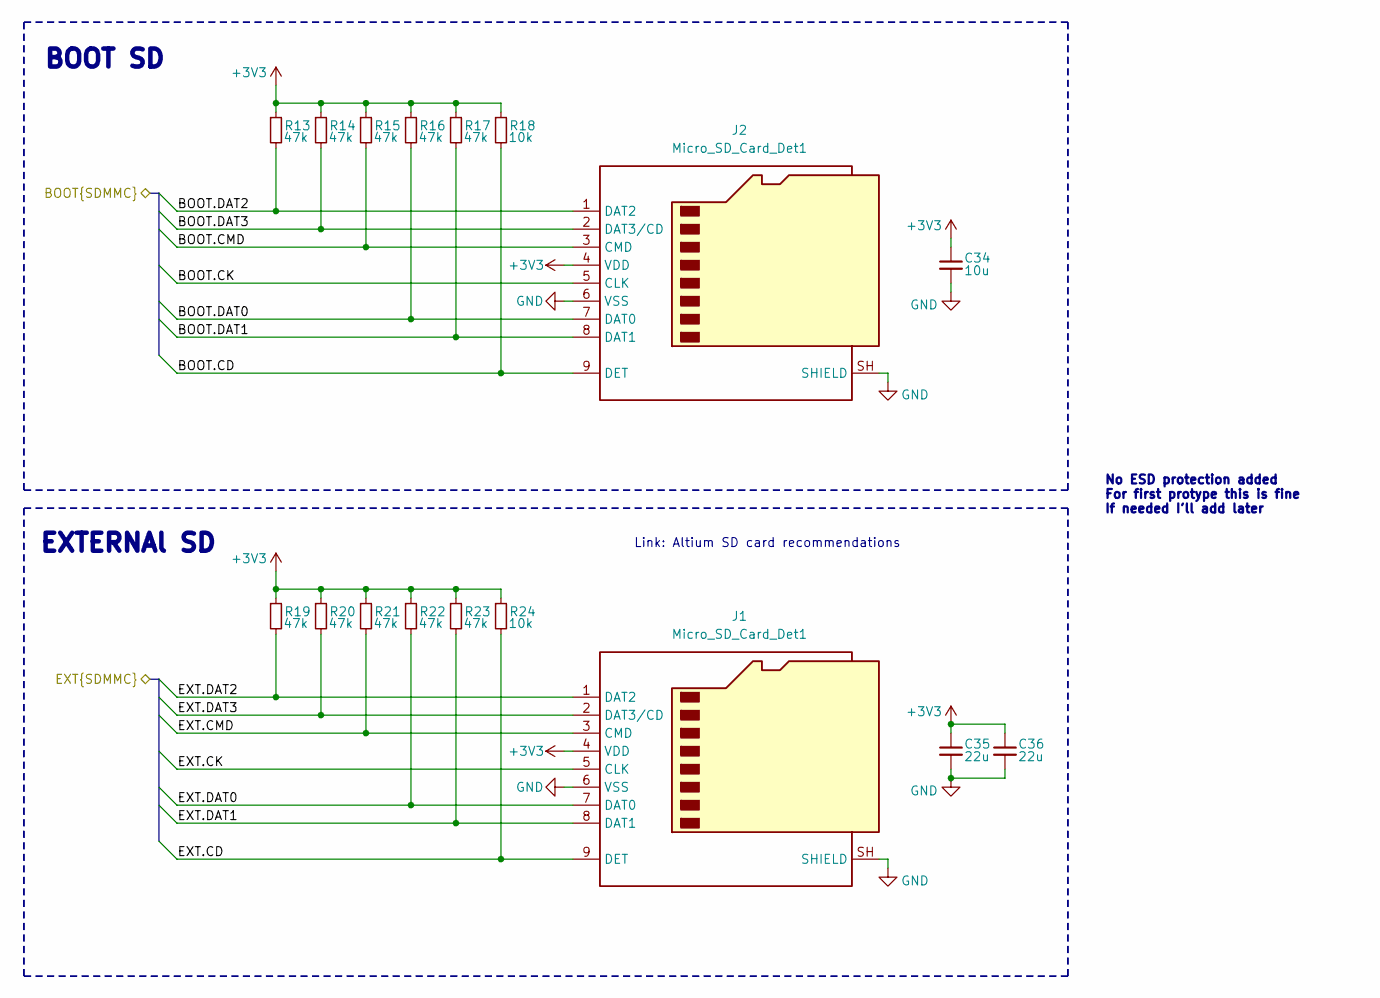
[picture p44: schematic sd.kicad_sch]

Parts:
C34: 10u
C35, C36: 22u
J1: Micro_SD_Card_Det1; microSD_XYECONN_TF-015-ZYD9AH185
J2: Micro_SD_Card_Det1; microSD_SOFNG_TF-008
R13, R14, R15, R16, R17, R19, R20, R21, R22, R23: 47k
R18, R24: 10k

Connections:
+3V3: C34.1, C35.1, C36.1, J1.4 (VDD), J2.4 (VDD), R13.1, R14.1, R15.1, R16.1, R17.1, R18.1, R19.1, R20.1, R21.1, R22.1, R23.1, R24.1
BOOT.CD: J2.9 (DET), R18.2
BOOT.CK: J2.5 (CLK)
BOOT.CMD: J2.3 (CMD), R15.2
BOOT.DAT0: J2.7 (DAT0), R16.2
BOOT.DAT1: J2.8 (DAT1), R17.2
BOOT.DAT2: J2.1 (DAT2), R13.2
BOOT.DAT3: J2.2 (DAT3/CD), R14.2
EXT.CD: J1.9 (DET), R24.2
EXT.CK: J1.5 (CLK)
EXT.CMD: J1.3 (CMD), R21.2
EXT.DAT0: J1.7 (DAT0), R22.2
EXT.DAT1: J1.8 (DAT1), R23.2
EXT.DAT2: J1.1 (DAT2), R19.2
EXT.DAT3: J1.2 (DAT3/CD), R20.2
GND: C34.2, C35.2, C36.2, J1.6 (VSS), J1.SH (SHIELD), J2.6 (VSS), J2.SH (SHIELD)

Notes on the sheet:
EXTERNAl SD
No ESD protection added For first protype this is fine If needed I'll add later
Link: Altium SD card recommendations
BOOT SD
