KOEGlike/meko/hardware/pcb/usb.kicad_sch

## KiCad design hardware/pcb/usb.kicad_sch (2026-10-21, an earlier design)

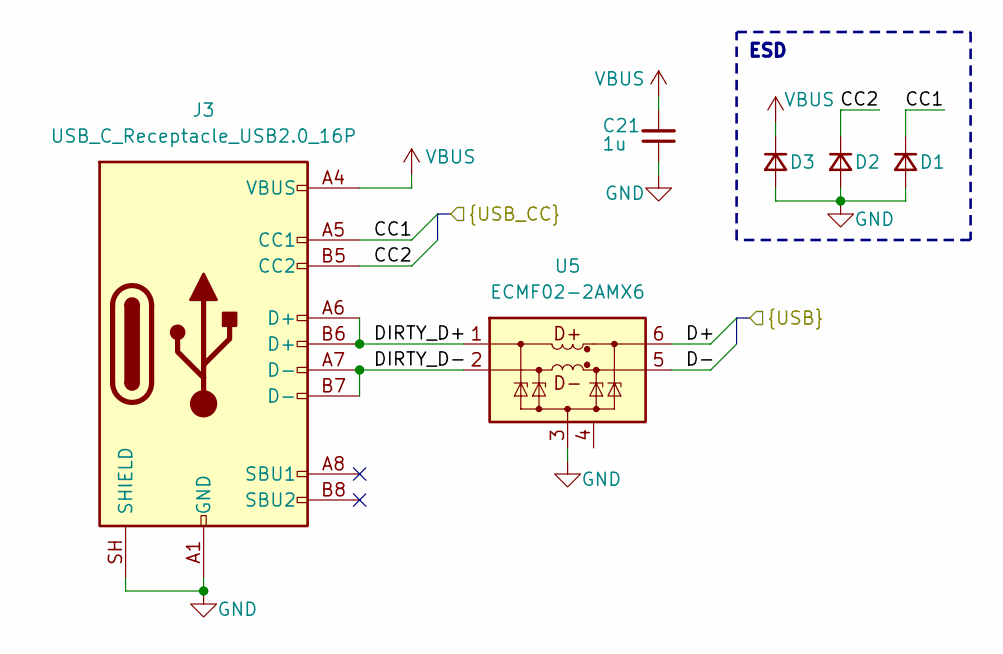
[picture p45: schematic usb.kicad_sch]

Parts:
C21: 1u
D1, D2, D3: ESD441; ESD441DPLR
J3: USB_C_Receptacle_USB2.0_16P; USB_C_Receptacle_HRO_TYPE-C-31-M-12
U5: ECMF02-2AMX6; ST_UQFN-6L_1.5x1.7mm_P0.5mm

Connections:
CC1: D1.1 (K), J3.A5 (CC1)
CC2: D2.1 (K), J3.B5 (CC2)
D+: U5.6 (D+_out)
D-: U5.5 (D-_out)
DIRTY_D+: J3.A6 (D+), J3.B6 (D+), U5.1 (D+_in)
DIRTY_D-: J3.A7 (D-), J3.B7 (D-), U5.2 (D-_in)
GND: C21.1, D1.2 (A), D2.2 (A), D3.2 (A), J3.A1 (GND), J3.A12 (GND), J3.B1 (GND), J3.B12 (GND), J3.SH (SHIELD), U5.3 (GND)
VBUS: C21.2, D3.1 (K), J3.A4 (VBUS), J3.A9 (VBUS), J3.B4 (VBUS), J3.B9 (VBUS)

Notes on the sheet:
ESD
