KOEGlike/meko/hardware/pcb/wireless.kicad_sch

## KiCad design hardware/pcb/wireless.kicad_sch (2026-10-21, an earlier design)

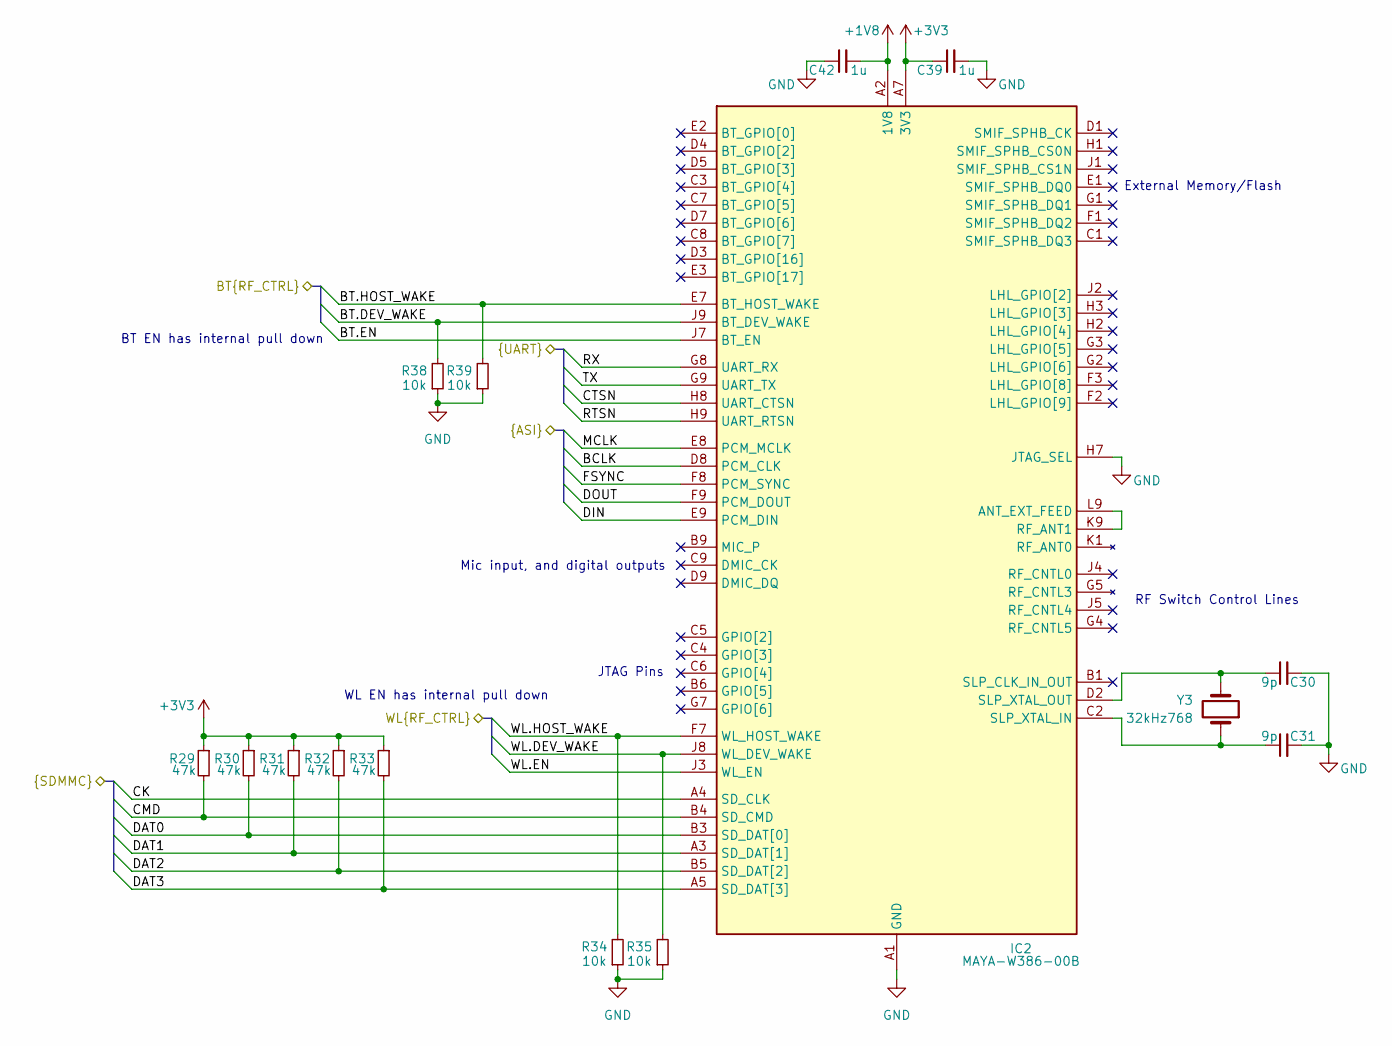
[picture p46: schematic wireless.kicad_sch]

Parts:
C30, C31: 9p
C39, C42: 1u
IC2: MAYA-W386-00B; MPN MAYA-W383-00B
R29, R30, R31, R32, R33: 47k
R34, R35, R38, R39: 10k
Y3: 32kHz768; Crystal_SMD_MicroCrystal_CC7V-T1A-2Pin_3.2x1.5mm; MPN SC-32S32.768kHz20PPM7pF

Connections:
+1V8: C42.2, IC2.A2 (1V8)
+3V3: C39.1, IC2.A7 (3V3), IC2.B7 (3V3), R29.1, R30.1, R31.1, R32.1, R33.1
BCLK: IC2.D8 (PCM_CLK)
BT.DEV_WAKE: IC2.J9 (BT_DEV_WAKE), R38.2
BT.EN: IC2.J7 (BT_EN)
BT.HOST_WAKE: IC2.E7 (BT_HOST_WAKE), R39.2
CK: IC2.A4 (SD_CLK)
CMD: IC2.B4 (SD_CMD), R29.2
CTSN: IC2.H8 (UART_CTSN)
DAT0: IC2.B3 (SD_DAT[0]), R30.2
DAT1: IC2.A3 (SD_DAT[1]), R31.2
DAT2: IC2.B5 (SD_DAT[2]), R32.2
DAT3: IC2.A5 (SD_DAT[3]), R33.2
DIN: IC2.E9 (PCM_DIN)
DOUT: IC2.F9 (PCM_DOUT)
FSYNC: IC2.F8 (PCM_SYNC)
GND: C30.2, C31.2, C39.2, C42.1, IC2.A1 (GND), IC2.A9 (GND), IC2.B2 (GND), IC2.B8 (GND), IC2.E4 (GND), IC2.E5 (GND), IC2.F4 (GND), IC2.F5 (GND), IC2.H4 (GND), IC2.H5 (GND), IC2.H7 (JTAG_SEL), IC2.K2 (GND), IC2.K3 (GND), IC2.K4 (GND), IC2.K5 (GND), IC2.K6 (GND), IC2.K7 (GND), IC2.K8 (GND), IC2.L1 (GND), IC2.M1 (GND), IC2.M2 (GND), IC2.M8 (GND), IC2.M9 (GND), R34.1, R35.1, R38.1, R39.1
MCLK: IC2.E8 (PCM_MCLK)
unnamed: C30.1, IC2.D2 (SLP_XTAL_OUT), Y3.2
unnamed: C31.1, IC2.C2 (SLP_XTAL_IN), Y3.1
unnamed: IC2.A6 (NC), IC2.A8 (NC)
unnamed: IC2.K9 (RF_ANT1), IC2.L9 (ANT_EXT_FEED)
RTSN: IC2.H9 (UART_RTSN)
RX: IC2.G8 (UART_RX)
TX: IC2.G9 (UART_TX)
WL.DEV_WAKE: IC2.J8 (WL_DEV_WAKE), R35.2
WL.EN: IC2.J3 (WL_EN)
WL.HOST_WAKE: IC2.F7 (WL_HOST_WAKE), R34.2

Notes on the sheet:
WL EN has internal pull down
Mic input, and digital outputs
RF Switch Control Lines
BT EN has internal pull down
External Memory/Flash
JTAG Pins
