KOEGlike/meko/hardware/pcb_touchpad/touchpad.kicad_sch

## KiCad design hardware/pcb_touchpad/touchpad.kicad_sch (2026-10-21, an earlier design)

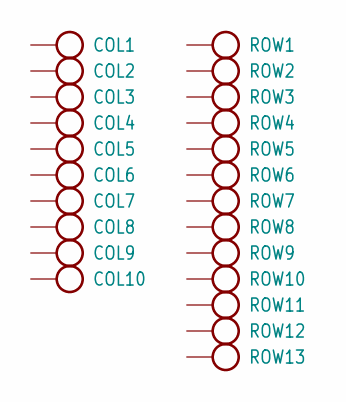
[picture p47: schematic touchpad.kicad_sch]

Parts:
COL1, COL2, COL3, COL4, COL5, COL6, COL7, COL8, COL9, COL10: TESTPOINTPAD_0_5MM; PAD_0_5MM
ROW1, ROW2, ROW3, ROW4, ROW5, ROW6, ROW7, ROW8, ROW9, ROW10, ROW11, ROW12, ROW13: TESTPOINTPAD_0_5MM; PAD_0_5MM
