KOEGlike/meko/meko-pcb/V1/audio.kicad_sch

## KiCad design meko-pcb/V1/audio.kicad_sch (2025-06-12)

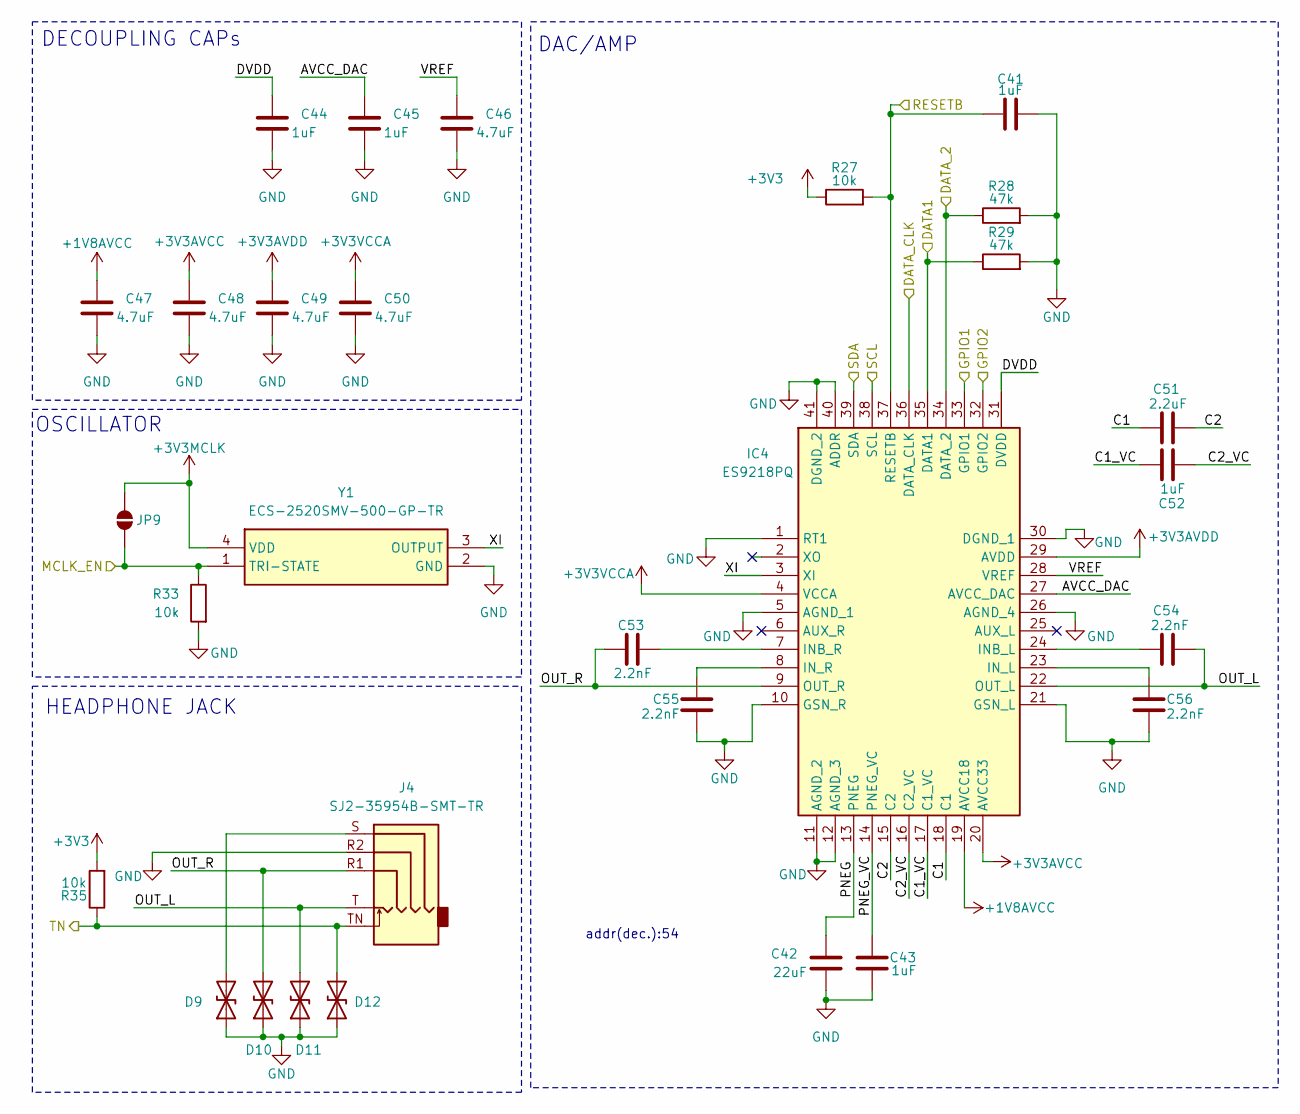
[picture p48: schematic audio.kicad_sch]

Parts:
C41, C43, C44, C45, C52: 1uF; C_0402_1005Metric; MPN CL05A105KO5NNNC
C42: 22uF; C_0603_1608Metric; MPN CL10A226MQ8NRNC
C46, C47, C48, C49, C50: 4.7uF; C_0402_1005Metric; MPN CL05A475KP5NRNC
C51: 2.2uF; C_0402_1005Metric; MPN CL05A225KO5NQNC
C53, C54, C55, C56: 2.2nF; C_0402_1005Metric; MPN CL05B222KB5NNNC
D9, D10, D11, D12: D_TVS; CD0201T20LC; MPN CD0201-T2.0LC
IC4: ES9218PQ; QFN40P500X500X80-41N-D; MPN ES9218PQ
J4: SJ2-35954B-SMT-TR; CUI_SJ2-35954B-SMT-TR; MPN SJ2-35954B-SMT-TR
JP9: SolderJumper_2_Open; SolderJumper-2_P1.3mm_Open_RoundedPad1.0x1.5mm
R27, R33, R35: 10k; R_0402_1005Metric; MPN CRCW040210K0FKED
R28, R29: 47k; R_0402_1005Metric; MPN RC0402FR-0747KL
Y1: ECS-2520SMV-500-GP-TR; ECS2520SMV500GPTR; MPN ECS-2520SMV-500-GP-TR

Connections:
+1V8AVCC: C47.1, IC4.19 (AVCC18)
+3V3: R27.1, R35.2
+3V3AVCC: C48.1, IC4.20 (AVCC33)
+3V3AVDD: C49.1, IC4.29 (AVDD)
+3V3MCLK: JP9.1 (A), Y1.4 (VDD)
+3V3VCCA: C50.1, IC4.4 (VCCA)
AVCC_DAC: C45.1, IC4.27 (AVCC_DAC)
C1: C51.1, IC4.18 (C1)
C1_VC: C52.1, IC4.17 (C1_VC)
C2: C51.2, IC4.15 (C2)
C2_VC: C52.2, IC4.16 (C2_VC)
DATA1: IC4.35 (DATA1), R29.1
DATA_2: IC4.34 (DATA_2), R28.1
DATA_CLK: IC4.36 (DATA_CLK)
DVDD: C44.1, IC4.31 (DVDD)
GND: C41.1, C42.2, C43.2, C44.2, C45.2, C46.2, C47.2, C48.2, C49.2, C50.2, C55.1, C56.1, D9.1 (A1), D10.1 (A1), D11.1 (A1), D12.1 (A1), IC4.1 (RT1), IC4.5 (AGND_1), IC4.10 (GSN_R), IC4.11 (AGND_2), IC4.12 (AGND_3), IC4.21 (GSN_L), IC4.26 (AGND_4), IC4.30 (DGND_1), IC4.40 (ADDR), IC4.41 (DGND_2), J4.R2, R28.2, R29.2, R33.2, Y1.2 (GND)
GPIO1: IC4.33 (GPIO1)
GPIO2: IC4.32 (GPIO2)
MCLK_EN: JP9.2 (B), R33.1, Y1.1 (TRI-STATE)
unnamed: C53.2, IC4.7 (INB_R)
unnamed: C54.1, IC4.24 (INB_L)
unnamed: C55.2, IC4.8 (IN_R)
unnamed: C56.2, IC4.23 (IN_L)
unnamed: D9.2 (A2), J4.S
OUT_L: C54.2, D11.2 (A2), IC4.22 (OUT_L), J4.T
OUT_R: C53.1, D10.2 (A2), IC4.9 (OUT_R), J4.R1
PNEG: C42.1, IC4.13 (PNEG)
PNEG_VC: C43.1, IC4.14 (PNEG_VC)
RESETB: C41.2, IC4.37 (RESETB), R27.2
SCL: IC4.38 (SCL)
SDA: IC4.39 (SDA)
TN: D12.2 (A2), J4.TN, R35.1
VREF: C46.1, IC4.28 (VREF)
XI: IC4.3 (XI), Y1.3 (OUTPUT)

Notes on the sheet:
DAC/AMP
OSCILLATOR
addr(dec.):54
HEADPHONE JACK
DECOUPLING CAPs
