KOEGlike/meko/meko-pcb/V1/meko-pcb.kicad_sch

## KiCad design meko-pcb/V1/meko-pcb.kicad_sch (2025-06-13)

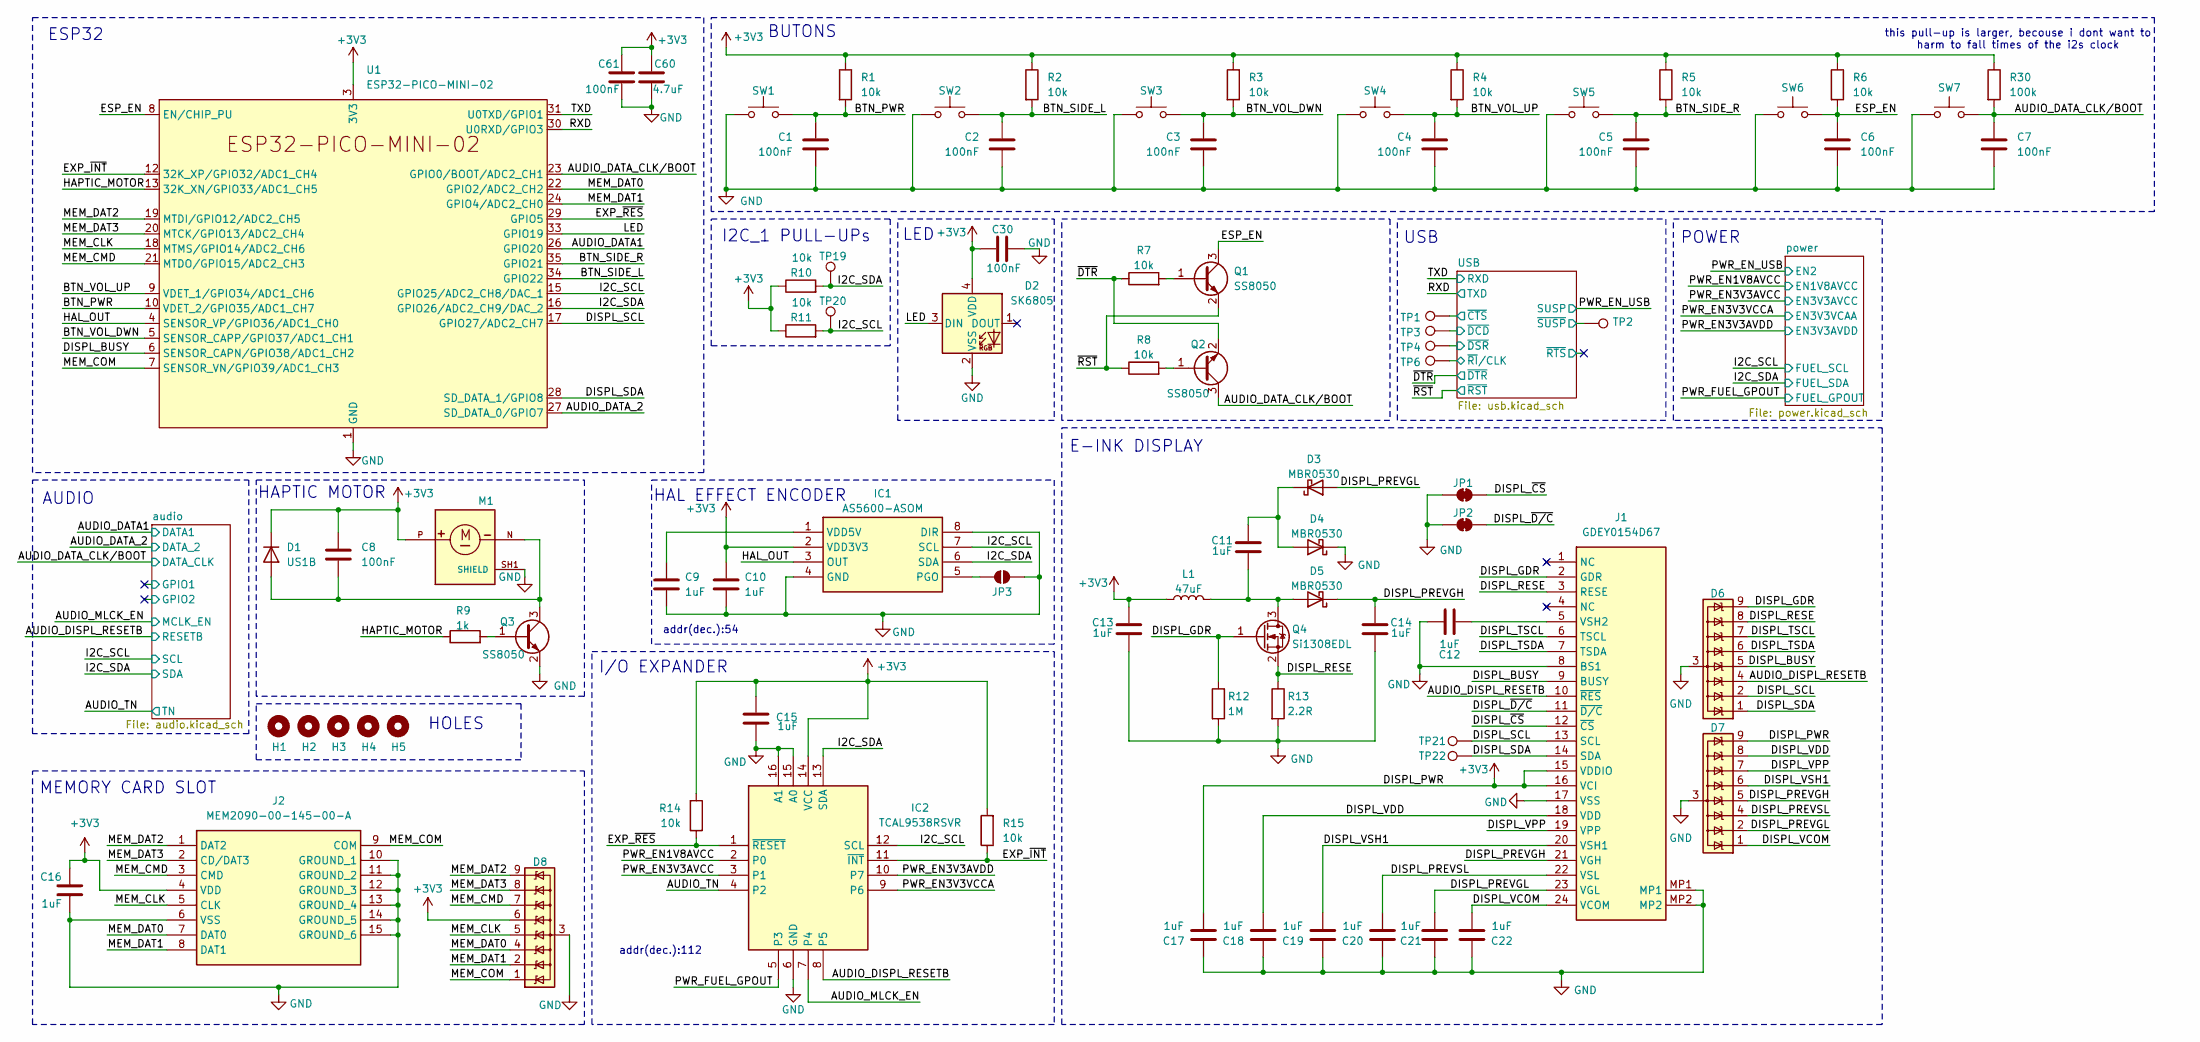
[picture p49: schematic meko-pcb.kicad_sch]

Parts:
C1, C2, C3, C4, C5, C6, C7, C8, C30, C61: 100nF; C_0402_1005Metric; MPN CL05B104KO5NNNC
C9, C10, C11, C12, C13, C14, C15, C16, C17, C18, C19, C20, C21, C22: 1uF; C_0402_1005Metric; MPN CL05A105KO5NNNC
C60: 4.7uF; C_0402_1005Metric; MPN CL05A475KP5NRNC; LCSC C307423
D1: US1B; D_SMA; MPN US1B
D2: SK6805; sk6805ec14; MPN SK6805-EC14
D3, D4, D5: MBR0530; D_SOD-123; MPN MBR0530T1G
D6, D7, D8: D3V3X8U9LP3810; Diodes_UDFN3810-9_TYPE_B-better-pinout; MPN D3V3F8U9LP3810-7
H1, H2, H3, H4, H5: MountingHole; MountingHole_1.8mm_M1.6
IC1: AS5600-ASOM; SOIC127P600X175-8N; MPN AS5600-ASOM
IC2: TCAL9538RSVR; QFN40P180X260X55-16N; MPN TCAL9538RSVR
J1: GDEY0154D67; FH34SRJ24S05SH99-disp; MPN FH34SRJ-24S-0.5SH(99)
J2: MEM2090-00-145-00-A; MEM20900014500A; MPN MEM2090-00-145-00-A
JP1, JP2: SolderJumper_2_Bridged; SolderJumper-2_P1.3mm_Bridged_RoundedPad1.0x1.5mm
JP3: SolderJumper_2_Open; SolderJumper-2_P1.3mm_Open_RoundedPad1.0x1.5mm
L1: 47uF; L_TDK_MLZ2012_h1.25mm; MPN MLZ2012M470WT000
M1: HD-EMB1204-SM; PUI_HD-EMB1204-SM; PARTREV A
Q1, Q2, Q3: SS8050; SOT-23; MPN SS8050-HF
Q4: Si1308EDL; SOT-323_SC-70; MPN SI1308EDL-T1-GE3
R1, R2, R3, R4, R5, R6, R7, R8, R10, R11, R14, R15: 10k; R_0402_1005Metric; MPN CRCW040210K0FKED
R9: 1k; R_0402_1005Metric; MPN RC0402FR-071KL
R12: 1M; R_0402_1005Metric; MPN RC0402FR-071ML
R13: 2.2R; R_0402_1005Metric; MPN RC0402FR-072R2L
R30: 100k; R_0402_1005Metric; MPN RC0402FR-07100KL
SW1, SW2, SW3, SW4, SW5: SW_Push; SW_Push_1P1T-MP_NO_Horizontal_Alps_SKRTLAE010; MPN SKRTLAE010
SW6, SW7: SW_Push; SW_Push_SPST_NO_Alps_SKRK; MPN SKRKAGE020
TP1, TP2, TP3, TP4, TP6, TP19, TP20, TP21, TP22: TestPoint; TestPoint_Pad_D1.0mm
U1: ESP32-PICO-MINI-02; MPN ESP32-PICO-MINI-02-N8R2

Connections:
+3V3: C8.1, C10.1, C13.2, C15.2, C16.1, C17.2, C30.1, C60.2, C61.1, D1.1 (K), D2.4 (VDD), D7.9 (Line-2), D8.6 (Line-7), IC1.2 (VDD3V3), IC2.14 (VCC), J1.15 (VDDIO), J1.16 (VCI), J2.4 (VDD), L1.1, M1.P, R1.1, R2.1, R3.1, R4.1, R5.1, R6.1, R10.1, R11.1, R14.2, R15.2, R30.1, U1.3 (3V3)
AUDIO_DATA1: U1.26 (GPIO20)
AUDIO_DATA_2: U1.27 (SD_DATA_0/GPIO7)
AUDIO_DATA_CLK/BOOT: C7.1, Q2.3 (C), R30.2, SW7.2, U1.23 (GPIO0/BOOT/ADC2_CH1)
AUDIO_DISPL_RESETB: D6.4 (Line-6), IC2.8 (P5), J1.10 (~RES)
AUDIO_MLCK_EN: IC2.7 (P4)
AUDIO_TN: IC2.4 (P2)
BTN_PWR: C1.1, R1.2, SW1.2, U1.10 (VDET_2/GPIO35/ADC1_CH7)
BTN_SIDE_L: C2.1, R2.2, SW2.2, U1.34 (GPIO22)
BTN_SIDE_R: C5.1, R5.2, SW5.2, U1.35 (GPIO21)
BTN_VOL_DWN: C3.1, R3.2, SW3.2, U1.5 (SENSOR_CAPP/GPIO37/ADC1_CH1)
BTN_VOL_UP: C4.1, R4.2, SW4.2, U1.9 (VDET_1/GPIO34/ADC1_CH6)
DISPL_BUSY: D6.5 (Line-8), J1.9 (BUSY), U1.6 (SENSOR_CAPN/GPIO38/ADC1_CH2)
DISPL_GDR: D6.9 (Line-2), J1.2 (GDR), Q4.1 (G), R12.1
DISPL_PREVGH: C14.2, D5.1 (K), D7.5 (Line-8), J1.21 (VGH)
DISPL_PREVGL: C21.2, D3.2 (A), D7.2 (Line-3), J1.23 (VGL)
DISPL_PREVSL: C20.2, D7.4 (Line-6), J1.22 (VSL)
DISPL_RESE: D6.8 (Line-4), J1.3 (RESE), Q4.2 (S), R13.1
DISPL_SCL: D6.2 (Line-3), J1.13 (SCL), TP21.1, U1.17 (GPIO27/ADC2_CH7)
DISPL_SDA: D6.1 (Line-1), J1.14 (SDA), TP22.1, U1.28 (SD_DATA_1/GPIO8)
DISPL_TSCL: D6.7 (Line-5), J1.6 (TSCL)
DISPL_TSDA: D6.6 (Line-7), J1.7 (TSDA)
DISPL_VCOM: C22.2, D7.1 (Line-1), J1.24 (VCOM)
DISPL_VDD: C18.2, D7.8 (Line-4), J1.18 (VDD)
DISPL_VPP: D7.7 (Line-5), J1.19 (VPP)
DISPL_VSH1: C19.2, D7.6 (Line-7), J1.20 (VSH1)
DISPL_~CS: J1.12 (~CS), JP1.2 (B)
DISPL_~D/C: J1.11 (~D/C), JP2.2 (B)
ESP_EN: C6.1, Q1.3 (C), R6.2, SW6.2, U1.8 (EN/CHIP_PU)
EXP_~INT: IC2.11 (~INT), R15.1, U1.12 (32K_XP/GPIO32/ADC1_CH4)
EXP_~RES: IC2.1 (~RESET), R14.1, U1.29 (GPIO5)
GND: C1.2, C2.2, C3.2, C4.2, C5.2, C6.2, C7.2, C9.2, C10.2, C12.1, C13.1, C14.1, C15.1, C16.2, C17.1, C18.1, C19.1, C20.1, C21.1, C22.1, C30.2, C60.1, C61.2, D2.2 (VSS), D4.1 (K), D6.3 (GND), D7.3 (GND), D8.3 (GND), IC1.4 (GND), IC1.8 (DIR), IC2.6 (GND), IC2.15 (A0), IC2.16 (A1), J1.8 (BS1), J1.17 (VSS), J1.MP1, J1.MP2, J2.6 (VSS), J2.10 (GROUND_1), J2.11 (GROUND_2), J2.12 (GROUND_3), J2.13 (GROUND_4), J2.14 (GROUND_5), J2.15 (GROUND_6), JP1.1 (A), JP2.1 (A), JP3.1 (A), M1.SH1 (SHIELD), Q3.2 (E), R12.2, R13.2, SW1.1, SW2.1, SW3.1, SW4.1, SW5.1, SW6.1, SW7.1, U1.1 (GND), U1.2 (GND), U1.11 (GND), U1.14 (GND), U1.36 (GND), U1.37 (GND), U1.38 (GND), U1.39 (GND), U1.40 (GND), U1.41 (GND), U1.42 (GND), U1.43 (GND), U1.44 (GND), U1.45 (GND), U1.46 (GND), U1.47 (GND), U1.48 (GND), U1.49 (GND), U1.50 (GND), U1.51 (GND), U1.52 (GND), U1.53 (GND)
HAL_OUT: IC1.3 (OUT), U1.4 (SENSOR_VP/GPIO36/ADC1_CH0)
HAPTIC_MOTOR: R9.1, U1.13 (32K_XN/GPIO33/ADC1_CH5)
I2C_SCL: IC1.7 (SCL), IC2.12 (SCL), R11.2, TP20.1, U1.15 (GPIO25/ADC2_CH8/DAC_1)
I2C_SDA: IC1.6 (SDA), IC2.13 (SDA), R10.2, TP19.1, U1.16 (GPIO26/ADC2_CH9/DAC_2)
LED: D2.3 (DIN), U1.33 (GPIO19)
MEM_CLK: D8.5 (Line-8), J2.5 (CLK), U1.18 (MTMS/GPIO14/ADC2_CH6)
MEM_CMD: D8.7 (Line-5), J2.3 (CMD), U1.21 (MTDO/GPIO15/ADC2_CH3)
MEM_COM: D8.1 (Line-1), J2.9 (COM), U1.7 (SENSOR_VN/GPIO39/ADC1_CH3)
MEM_DAT0: D8.4 (Line-6), J2.7 (DAT0), U1.22 (GPIO2/ADC2_CH2)
MEM_DAT1: D8.2 (Line-3), J2.8 (DAT1), U1.24 (GPIO4/ADC2_CH0)
MEM_DAT2: D8.9 (Line-2), J2.1 (DAT2), U1.19 (MTDI/GPIO12/ADC2_CH5)
MEM_DAT3: D8.8 (Line-4), J2.2 (CD/DAT3), U1.20 (MTCK/GPIO13/ADC2_CH4)
unnamed: C8.2, D1.2 (A), M1.N, Q3.3 (C)
unnamed: C9.1, IC1.1 (VDD5V)
unnamed: C11.1, D5.2 (A), L1.2, Q4.3 (D)
unnamed: C11.2, D3.1 (K), D4.2 (A)
unnamed: C12.2, J1.5 (VSH2)
unnamed: IC1.5 (PGO), JP3.2 (B)
unnamed: Q1.1 (B), R7.2
unnamed: Q2.1 (B), R8.2
unnamed: Q3.1 (B), R9.2
PWR_EN1V8AVCC: IC2.2 (P0)
PWR_EN3V3AVCC: IC2.3 (P1)
PWR_EN3V3AVDD: IC2.10 (P7)
PWR_EN3V3VCCA: IC2.9 (P6)
PWR_FUEL_GPOUT: IC2.5 (P3)
RXD: U1.30 (U0RXD/GPIO3)
TXD: U1.31 (U0TXD/GPIO1)
~CTS: TP1.1
~DCD: TP3.1
~DSR: TP4.1
~DTR: Q2.2 (E), R7.1
~RI/CLK: TP6.1
~RST: Q1.2 (E), R8.1
~SUSP: TP2.1

Notes on the sheet:
this pull-up is larger, becouse i dont want to harm to fall times of the i2s clock
HOLES
addr(dec.):54
E-INK DISPLAY
addr(dec.):112
ESP32
I2C_1 PULL-UPs
MEMORY CARD SLOT
BUTONS
HAPTIC MOTOR
I/O EXPANDER
AUDIO
USB
LED
POWER
HAL EFFECT ENCODER
