KOEGlike/meko/meko-pcb/V1/power.kicad_sch

## KiCad design meko-pcb/V1/power.kicad_sch (2025-06-12)

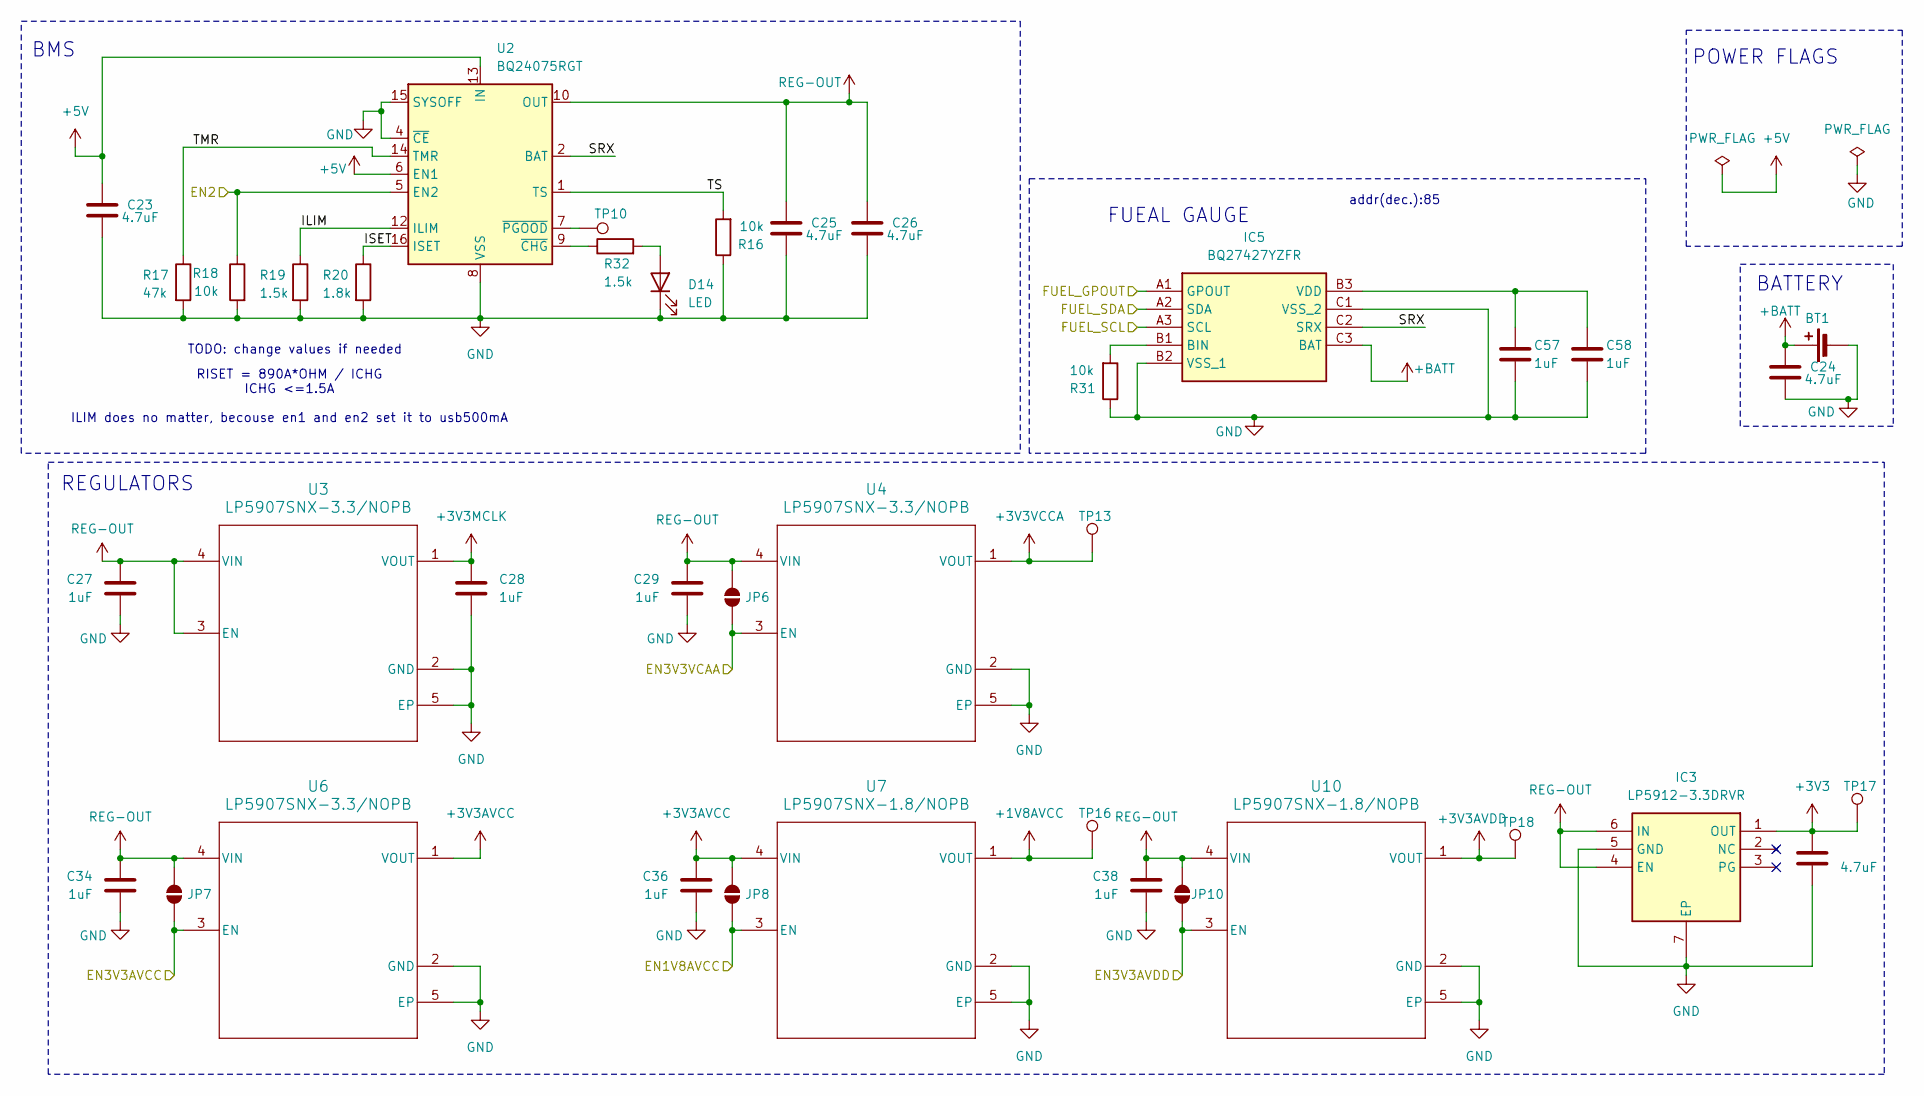
[picture p50: schematic power.kicad_sch]

Parts:
BT1: Battery_Cell; JST_S2B-PH-SM4-TB_LF__SN_; MPN S2B-PH-SM4-TB
C23, C24, C25, C26: 4.7uF; C_0402_1005Metric; MPN CL05A475KP5NRNC; LCSC C307423
C27, C28, C29, C34, C36, C38, C57, C58: 1uF; C_0402_1005Metric; MPN CL05A105KO5NNNC
C33: 4.7uF; C_0402_1005Metric; MPN CL05A475KP5NRNC
D14: LED; LED_0603_1608Metric; MPN 150060AS75003
IC3: LP5912-3.3DRVR; SON65P200X200X80-7N; MPN LP5912-3.3DRVR
IC5: BQ27427YZFR; BGA9C50P3X3_158X162X62; MPN BQ27427YZFR
JP6, JP7, JP8, JP10: SolderJumper_2_Open; SolderJumper-2_P1.3mm_Open_RoundedPad1.0x1.5mm
R16, R31: 10k; R_0402_1005Metric; MPN CRCW040210K0FKED; LCSC C25744
R17: 47k; R_0402_1005Metric; MPN RC0402FR-0747KL; LCSC C93943
R18: 10k; R_0402_1005Metric; MPN CRCW040210K0FKED
R19: 1.5k; R_0402_1005Metric; MPN RC0402FR-071K5L; LCSC C25867
R20: 1.8k; R_0402_1005Metric; MPN RC0402FR-071K8L; LCSC C131467
R32: 1.5k; R_0402_1005Metric; MPN RC0402FR-071K5L; LCSC C25744
TP10, TP13, TP16, TP17, TP18: TestPoint; TestPoint_Pad_D1.0mm
U2: BQ24075RGT; VQFN-16-1EP_3x3mm_P0.5mm_EP1.6x1.6mm; MPN BQ24075RGTR
U3, U4, U6: LP5907SNX-3.3/NOPB; Texas_X2SON-4_1x1mm_P0.65mm; MPN LP5907SNX-3.3/NOPB
U7, U10: LP5907SNX-1.8/NOPB; Texas_X2SON-4_1x1mm_P0.65mm; MPN LP5907SNX-1.8/NOPB

Connections:
+1V8AVCC: TP16.1, U7.1 (VOUT)
+3V3: C33.1, IC3.1 (OUT), TP17.1
+3V3AVCC: C36.1, JP8.1 (A), U6.1 (VOUT), U7.4 (VIN)
+3V3AVDD: TP18.1, U10.1 (VOUT)
+3V3MCLK: C28.1, U3.1 (VOUT)
+3V3VCCA: TP13.1, U4.1 (VOUT)
+5V: C23.2, U2.6 (EN1), U2.13 (IN)
+BATT: BT1.1 (+), C24.2, IC5.C3 (BAT)
EN1V8AVCC: JP8.2 (B), U7.3 (EN)
EN2: R18.1, U2.5 (EN2)
EN3V3AVCC: JP7.2 (B), U6.3 (EN)
EN3V3AVDD: JP10.2 (B), U10.3 (EN)
EN3V3VCAA: JP6.2 (B), U4.3 (EN)
FUEL_GPOUT: IC5.A1 (GPOUT)
FUEL_SCL: IC5.A3 (SCL)
FUEL_SDA: IC5.A2 (SDA)
GND: BT1.2 (-), C23.1, C24.1, C25.1, C26.1, C27.2, C28.2, C29.2, C33.2, C34.2, C36.2, C38.2, C57.2, C58.2, D14.1 (K), IC3.5 (GND), IC3.7 (EP), IC5.B2 (VSS_1), IC5.C1 (VSS_2), R16.1, R17.2, R18.2, R19.2, R20.2, R31.1, U2.4 (~CE), U2.8 (VSS), U2.15 (SYSOFF), U2.17 (VSS), U3.2 (GND), U3.5 (EP), U4.2 (GND), U4.5 (EP), U6.2 (GND), U6.5 (EP), U7.2 (GND), U7.5 (EP), U10.2 (GND), U10.5 (EP)
ILIM: R19.1, U2.12 (ILIM)
ISET: R20.1, U2.16 (ISET)
unnamed: C57.1, C58.1, IC5.B3 (VDD)
unnamed: D14.2 (A), R32.2
unnamed: IC5.B1 (BIN), R31.2
unnamed: R32.1, U2.9 (~CHG)
unnamed: TP10.1, U2.7 (~PGOOD)
REG-OUT: C25.2, C26.2, C27.1, C29.1, C34.1, C38.1, IC3.4 (EN), IC3.6 (IN), JP6.1 (A), JP7.1 (A), JP10.1 (A), U2.10 (OUT), U2.11 (OUT), U3.3 (EN), U3.4 (VIN), U4.4 (VIN), U6.4 (VIN), U10.4 (VIN)
SRX: IC5.C2 (SRX), U2.2 (BAT), U2.3 (BAT)
TMR: R17.1, U2.14 (TMR)
TS: R16.2, U2.1 (TS)

Notes on the sheet:
TODO: change values if needed
FUEAL GAUGE
BMS
POWER FLAGS
RISET = 890A*OHM / ICHG ICHG <=1.5A ILIM does no matter, becouse en1 and en2 set it to usb500mA
BATTERY
addr(dec.):85
REGULATORS
