KOEGlike/meko/meko-pcb/V1/usb.kicad_sch

## KiCad design meko-pcb/V1/usb.kicad_sch (2025-06-12)

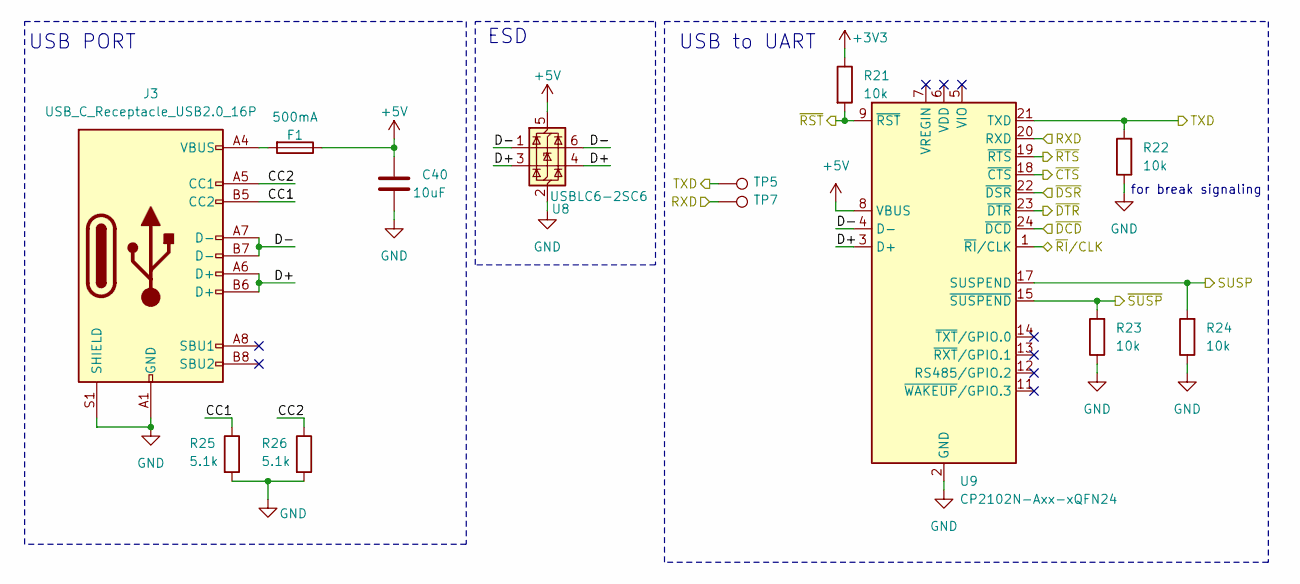
[picture p51: schematic usb.kicad_sch]

Parts:
C40: 10uF; C_0402_1005Metric; MPN CL05A106MQ5NUNC
F1: 500mA; Fuse_0603_1608Metric; MPN MF-FSMF050X-2; LCSC C210357
J3: USB_C_Receptacle_USB2.0_16P; USB_C_Receptacle_GCT_USB4105-xx-A_16P_TopMnt_Horizontal; MPN USB4105-GF-A
R21, R22, R23, R24: 10k; R_0402_1005Metric; MPN CRCW040210K0FKED
R25, R26: 5.1k; R_0402_1005Metric; MPN RC0402FR-075K1L; LCSC C25905
TP5, TP7: TestPoint; TestPoint_Pad_D1.0mm
U8: USBLC6-2SC6; SOT-23-6; MPN USBLC6-2SC6; LCSC C7519
U9: CP2102N-Axx-xQFN24; QFN-24-1EP_4x4mm_P0.5mm_EP2.6x2.6mm; MPN CP2102N-A02-GQFN24R

Connections:
+3V3: R21.1
+5V: C40.1, F1.1, U8.5 (VBUS), U9.8 (VBUS)
CC1: J3.B5 (CC2), R25.1
CC2: J3.A5 (CC1), R26.1
D+: J3.A6 (D+), J3.B6 (D+), U8.3 (I/O2), U8.4 (I/O2), U9.3 (D+)
D-: J3.A7 (D-), J3.B7 (D-), U8.1 (I/O1), U8.6 (I/O1), U9.4 (D-)
GND: C40.2, J3.A1 (GND), J3.A12 (GND), J3.B1 (GND), J3.B12 (GND), J3.S1 (SHIELD), R22.1, R23.1, R24.1, R25.2, R26.2, U8.2 (GND), U9.2 (GND), U9.25 (GND)
unnamed: F1.2, J3.A4 (VBUS), J3.A9 (VBUS), J3.B4 (VBUS), J3.B9 (VBUS)
RXD: TP7.1, U9.20 (RXD)
SUSP: R24.2, U9.17 (SUSPEND)
TXD: R22.2, TP5.1, U9.21 (TXD)
~CTS: U9.18 (~CTS)
~DCD: U9.24 (~DCD)
~DSR: U9.22 (~DSR)
~DTR: U9.23 (~DTR)
~RI/CLK: U9.1 (~RI/CLK)
~RST: R21.2, U9.9 (~RST)
~RTS: U9.19 (~RTS)
~SUSP: R23.2, U9.15 (~SUSPEND)

Notes on the sheet:
USB PORT
ESD
for break signaling
USB to UART
