KOEGlike/meko/(commit log)

2025-04-28 created kicad project
    [meko-pcb.kicad_pcb, meko-pcb.kicad_sch]
2025-04-29 added esp32 mini
    [meko-pcb.kicad_sch]
2025-05-05 added new external stuff
    [meko-pcb.kicad_pcb, meko-pcb.kicad_sch]
2025-05-07 added hall effect encoder
    [meko-pcb.kicad_pcb]
2025-05-08 worked on power a lil bit
    [meko-pcb.kicad_sch, power.kicad_sch, usb.kicad_sch]
2025-05-09 did power and usb
    [meko-pcb.kicad_sch, power.kicad_sch, usb.kicad_sch]
2025-05-10 did work on the audio
    [audio.kicad_sch, meko-pcb.kicad_sch]
2025-05-18 changed the crystal for an oscillator, still dont know what to do wit XO pin
    [audio.kicad_sch, meko-pcb.kicad_sch]
2025-05-18 changed the switch converter to a LDOs
    [meko-pcb.kicad_pcb, power.kicad_sch, usb.kicad_sch]
2025-05-22 added the sd card slot
    [audio.kicad_sch, ldo.kicad_sch, meko-pcb.kicad_pcb, meko-pcb.kicad_sch, power.kicad_sch]
2025-05-22 switched form mini esp32 to pico
    [meko-pcb.kicad_pcb, meko-pcb.kicad_sch]
2025-05-23 made the jouranl complient, back-journaled
    [audio.kicad_sch, meko-pcb.kicad_sch]
2025-05-23 removed old regulator, added new ones
    [power.kicad_sch]
2025-05-23 re-did power with the new small LDOs and power system
    [audio.kicad_sch, meko-pcb.kicad_pcb, meko-pcb.kicad_sch, power.kicad_sch, usb.kicad_sch]
2025-05-23 removed ldo.kicad_sch
    [ldo.kicad_sch]
2025-05-24 created custom symbol for the display, added pull-up/-down resistors
    [audio.kicad_sch, meko-pcb.kicad_pcb, meko-pcb.kicad_sch]
2025-05-24 i2c, i2s, uart, en, sd card
    [audio.kicad_sch, meko-pcb.kicad_pcb, meko-pcb.kicad_sch, power.kicad_sch, usb.kicad_sch]
2025-05-25 finishing up schematic
    [audio.kicad_sch, meko-pcb.kicad_pcb, meko-pcb.kicad_sch, power.kicad_sch]
2025-05-28 esd, jack, io expander, led, power swquence
    [audio.kicad_sch, meko-pcb.kicad_pcb, meko-pcb.kicad_sch, power.kicad_sch, usb.kicad_sch]
2025-05-28 segmented schematci
    [audio.kicad_sch, meko-pcb.kicad_sch, power.kicad_sch, usb.kicad_sch]
2025-05-28 fixed vibration motor
    [meko-pcb.kicad_sch]
2025-05-28 made it more organized
    [audio.kicad_sch, usb.kicad_sch]
2025-05-28 fixed motor transistor
    [meko-pcb.kicad_sch]
2025-05-28 reannotated schematic
    [audio.kicad_sch, meko-pcb.kicad_sch, power.kicad_sch, usb.kicad_sch]
2025-05-28 added titles to sheets
    [audio.kicad_sch, meko-pcb.kicad_sch, power.kicad_sch, usb.kicad_sch]
2025-05-29 small fixes
    [audio.kicad_sch, meko-pcb.kicad_pcb, meko-pcb.kicad_sch, power.kicad_sch, usb.kicad_sch]
2025-05-29 added 3d models
    [audio.kicad_sch, meko-pcb.kicad_pcb]
2025-05-30 fuel gauge ic
    [audio.kicad_sch, meko-pcb.kicad_pcb, meko-pcb.kicad_sch, power.kicad_sch, usb.kicad_sch]
2025-05-30 added missing 3d models
    [meko-pcb.kicad_pcb, meko-pcb.kicad_sch]
2025-05-30 small stuff
    [meko-pcb.kicad_pcb, meko-pcb.kicad_sch, power.kicad_sch]
2025-05-31 added models
    [meko-pcb.kicad_pcb, meko-pcb.kicad_sch, power.kicad_sch]
2025-05-31 started layout
    [meko-pcb.kicad_pcb, meko-pcb.kicad_sch, power.kicad_sch]
2025-06-01 more layout
    [meko-pcb.kicad_pcb]
2025-06-01 reordered the pins on the flex connector
    [meko-pcb.kicad_pcb]
2025-06-05 almost finished with the layout
    [audio.kicad_sch, meko-pcb.kicad_pcb, meko-pcb.kicad_sch]
2025-06-07 more routing
    [meko-pcb.kicad_pcb, meko-pcb.kicad_sch, power.kicad_sch]
2025-06-08 finished routing
    [audio.kicad_sch, meko-pcb.kicad_pcb, meko-pcb.kicad_sch, power.kicad_sch]
2025-06-10 minor stuff
    [meko-pcb.kicad_pcb, meko-pcb.kicad_sch, power.kicad_sch]
2025-06-11 added test points to uart
    [meko-pcb.kicad_pcb, usb.kicad_sch]
2025-06-11 minor fixes
    [meko-pcb.kicad_pcb]
2025-06-11 flipped buttons
    [meko-case.FCStd, meko-pcb.kicad_pcb]
2025-06-11 started cad
    [meko-case.FCStd]
2025-06-11 component selection
    [audio.kicad_sch, meko-pcb.kicad_sch, power.kicad_sch, usb.kicad_sch]
2025-06-12 picked MPNs
    [audio.kicad_sch, meko-pcb.csv, meko-pcb.kicad_sch, power.kicad_sch, usb.kicad_sch]
2025-06-12 stiching vias
    [meko-pcb.kicad_pcb]
2025-06-12 flipped 3d model of a LDO to right orientation
    [meko-pcb.kicad_pcb]
2025-06-13 3d stuff, fixes
    [meko-pcb.kicad_pcb, meko-pcb.kicad_sch]
2025-06-15 cad, and integrated design, so pcb
    [meko-pcb.kicad_pcb]
2025-06-17 case almost finished
2025-06-18 modeled display retainer
    [meko-pcb.kicad_pcb]
2025-06-19 rounded tracks and added via stiching
    [meko-pcb.kicad_pcb]
2025-06-19 finished cad
2025-06-19 removed bad trace
    [meko.blend]
2025-06-19 removed backups
    [meko-pcb.kicad_pcb]
2025-06-19 git compressed blender file
    [meko.blend]
2025-06-19 moved files to V1 folder
    [audio.kicad_sch, bom.csv, designators.csv, meko-pcb.csv, meko-pcb.kicad_pcb, meko-pcb.kicad_sch, positions.csv, power.kicad_sch]
2025-06-19 moved stuff around
    [audio.kicad_sch, bom.csv, designators.csv, meko-pcb-round.kicad_pcb, meko-pcb.csv, meko-pcb.kicad_pcb, meko-pcb.kicad_sch, positions.csv]
2025-06-20 removed seperate pcb file, you can undround the tracks easily
    [meko-pcb-round.kicad_pcb, meko-pcb.kicad_pcb]
2025-06-20 small changes, readme updates
    [audio.kicad_sch, meko-pcb.kicad_pcb]
2025-06-21 readme updates, removed unused fileds form kicad
    [audio.kicad_sch, meko-pcb.csv, meko-pcb.kicad_sch, power.kicad_sch, usb.kicad_sch]
2025-06-21 added round brackets
2025-06-21 added WHY section to readme
    [bom.csv, meko-pcb.csv]
2025-06-29 new blender scene
    [audio.kicad_sch]
2025-10-12 started to implement nrf53
    [meko-pcb.kicad_sch]
2025-10-14 continued work om nrf53
    [meko-pcb.kicad_pcb, meko-pcb.kicad_sch, power.kicad_sch]
2025-10-16 started to implement npm1300
    [audio.kicad_sch, meko-pcb.kicad_sch, power.kicad_sch]
2025-10-19 added new ldos, made improvements to the schematic
    [audio.kicad_sch, meko-pcb.kicad_pcb, meko-pcb.kicad_sch, power.kicad_sch]
2025-10-20 moved everything to one sheet, finished rough schematic
    finished power train, made the modules of the schematic more interconnected with tracs, removed unneded nets, seperated nets, connected everythin to the soc
    [audio.kicad_sch, meko-pcb.kicad_sch, power.kicad_sch, usb.kicad_sch]
2025-10-21 many small fixes
    [meko-pcb.kicad_pcb, meko-pcb.kicad_sch]
2025-10-21 renamed oscillator to crystal
    [meko-pcb.kicad_sch]
2025-10-25 switched from the ESS dac to a TI dac
    the preformance is better/same, its easier to implement, cheaper, in stock at lcsc
    [meko-pcb.kicad_pcb, meko-pcb.kicad_sch]
2025-10-26 swithced out dacs
    [meko-pcb.kicad_sch]
2025-10-27 added final touches
    [meko-pcb.kicad_pcb, meko-pcb.kicad_sch]
2025-10-27 Smalll updatesd
    [meko-pcb.kicad_pcb, meko-pcb.kicad_sch]
2025-10-28 small chnages
    [meko-pcb.kicad_pcb, meko-pcb.kicad_sch]
2025-10-28 added a bumch of testpoints/jumpers, fixed dac i2c adress pin
    [meko-pcb.kicad_pcb, meko-pcb.kicad_sch]
2025-10-29 changed parts that are not avalibile on lcsc
    [meko-pcb.kicad_pcb, meko-pcb.kicad_sch]
2025-10-29 fixed edge cuts
    [meko-pcb.kicad_pcb, meko-pcb.kicad_sch]
2025-11-05 almost finished with general layout
    this will most certanily evolve
    [meko-pcb.kicad_pcb, meko-pcb.kicad_sch]
2025-11-06 finished first pass of rough layout
    i still need to add 3d modles
    [meko-pcb.kicad_pcb]
2025-11-06 moved some stuff around
    [meko-pcb.kicad_pcb]
2025-11-12 removed caps from software controlled buttons, placed jumpers
    [meko-pcb.kicad_pcb, meko-pcb.kicad_sch]
2025-11-13 made schematic prettier
    [meko-pcb.kicad_pcb, meko-pcb.kicad_sch]
2025-11-14 routed some traces
    [meko-pcb.kicad_pcb]
2025-11-15 routed a bunch of traces
    [meko-pcb.kicad_pcb, meko-pcb.kicad_sch]
2025-11-15 routed more traces
    [meko-pcb.kicad_pcb, meko-pcb.kicad_sch]
2025-11-15 re did the layout of the dac
    [meko-pcb.kicad_pcb]
2025-11-15 forgor to save
    [meko-pcb.kicad_sch]
2025-11-15 moved pin assignments for better layout, redid analog layout
    [meko-pcb.kicad_pcb, meko-pcb.kicad_sch]
2025-11-16 rf, routed stuff
    [meko-pcb.kicad_pcb, meko-pcb.kicad_sch]
2025-11-17 messed around with gound fill
    [meko-pcb.kicad_pcb]
2025-11-18 almost finished
    routed all traces, still need to place testpoints
    [meko-pcb.kicad_pcb, meko-pcb.kicad_sch]
2025-11-19 places all the testpoints
    [meko-pcb.kicad_pcb]
2025-11-20 added 3d models, moved vibration motor around
    [meko-pcb.kicad_pcb]
2025-11-20 moved a cap
    [meko-pcb.kicad_pcb]
2025-11-20 made final changes
    [meko-pcb.kicad_pcb, meko-pcb.kicad_sch]
2025-11-20 filled zone
    [meko-pcb.kicad_pcb]
2025-11-22 fixed mistake in asom
    [meko-pcb.kicad_pcb, meko-pcb.kicad_sch]
2025-11-22 re calculated usb impedance, switched reference plane for the antenna
    [meko-pcb.kicad_pcb]
2025-11-22 added a 3d model
    [meko-pcb.kicad_pcb]
2025-11-22 updated component placement to match the previous design, updated case
    [meko-case.FCStd, meko-pcb.kicad_pcb]
2025-11-22 made visible some stuff in cad
    [meko-case.FCStd]
2025-11-23 assigned all the mpns and lcsc numbers
    [meko-pcb.kicad_pcb, meko-pcb.kicad_sch]
2025-11-23 updated bom and readme
    [bom.csv, meko-pcb.csv]
2025-11-23 fixed csv
    [bom.csv]
2025-11-23 updated components
    [meko-pcb.kicad_pcb]
2025-11-23 exported step
    [meko-case-Assembly.step, meko-case.FCStd]
2025-11-23 updated bom
    [bom.csv]
2025-11-27 optimzed bom
    [meko-pcb.kicad_sch]
2025-11-27 made load caps dnp, cuz the nrf has internal ones
    [meko-pcb.kicad_sch]
2025-11-27 updated a cap
    [meko-pcb.kicad_sch]
2025-11-27 fixed motor and resistor interference
    [bom.csv, meko-pcb.csv, meko-pcb.kicad_pcb]
2025-11-28 updated motor foorprint, added 3d moedel
    [bom.csv, meko-pcb.kicad_pcb, meko-pcb.kicad_sch]
2025-11-29 chose a new crystal, so i can remove all 4 load caps
    [meko-pcb.kicad_pcb, meko-pcb.kicad_sch]
2025-11-29 made new renders
    [meko-case-Assembly.stl, meko-case.FCStd]
2026-03-03 Remodelled the case in fusion
    [Meko.f3z, Meko.step, meko-case-Assembly.step, meko-case.FCStd]
2026-03-03 Configure firmware submodule to track main branch
2026-03-14 Update README with firmware changes and remove parameters
    Removed detailed parameters section for 3D printing and updated firmware information.
2026-07-14 a fresh start
    [Meko.f3z, Meko.step, meko-case-Assembly.stl, meko-pcb.kicad_pcb, meko-pcb.kicad_sch]
2026-07-15 added sama7 symbol and footprint, journal update
    [meko.kicad_pcb, meko.kicad_sch]
2026-07-16 replaced the 4hb footprint with the one from component search engine
2026-07-16 split apart the sama7 sybmol into units
    [meko.kicad_pcb, meko.kicad_sch]
2026-07-19 made mcp16502 symbol
    [ddr.kicad_sch, meko.kicad_pcb, meko.kicad_sch, power.kicad_sch, sama.kicad_sch]
2026-07-20 replaced footprint with one fron cse
    [ddr.kicad_sch, meko.kicad_pcb]
2026-07-21 finished ddr symbol
    [ddr.kicad_sch, meko.kicad_pcb, sama.kicad_sch]
2026-07-27 connected ddr to sama7, still need to do pwr
    [ddr.kicad_sch, meko.kicad_sch, sama.kicad_sch]
2026-08-05 added maya-w3, made symbol
    [meko.kicad_pcb, meko.kicad_sch, sama.kicad_sch, wireless.kicad_sch]
2026-08-06 created MAX17260 and BQ25640 symbols
    [meko.kicad_pcb, power.kicad_sch]
2026-08-07 started usb
    [ddr.kicad_sch, meko.kicad_sch, sama.kicad_sch, usb.kicad_sch]
2026-08-08 usb power
    [meko.kicad_pcb, power.kicad_sch, sama.kicad_sch, usb.kicad_sch]
2026-08-16 finished power
    [ddr.kicad_sch, power.kicad_sch, usb.kicad_sch]
2026-08-18 contiunued working
    [buttons.kicad_sch, dac.kicad_sch, ddr.kicad_sch, display.kicad_sch, meko.kicad_pcb, meko.kicad_sch, power.kicad_sch, sama.kicad_sch]
2026-08-20 small stuff with mpu
    [ddr.kicad_sch, power.kicad_sch, sama.kicad_sch]
2026-08-20 wrote journal, movde crystal calcs
    [sama.kicad_sch]
2026-08-22 bunch of small changes
    [ddr.kicad_sch, meko.kicad_pcb, sama.kicad_sch, sd.kicad_sch, usb.kicad_sch, wireless.kicad_sch]
2026-08-23 bunch of small audio changes
    [audio.kicad_sch, display.kicad_sch, meko.kicad_pcb, meko.kicad_sch, usb.kicad_sch]
2026-08-25 bunch of small audio and rf changes
    [audio.kicad_sch, sama.kicad_sch, wireless.kicad_sch]
2026-08-25 removed analog switch from audio path
    [audio.kicad_sch]
2026-08-25 small changes
    [audio.kicad_sch, sd.kicad_sch, touch_pad.kicad_sch]
2026-08-26 replaced lpddr3 with ddr3l
    [ddr.kicad_sch, power.kicad_sch, sama.kicad_sch]
2026-08-27 generated touch pad
    [touchpad.brd, touchpad.kicad_pcb, touchpad.kicad_sch, touchpad.sch]
2026-08-27 drew outline of trackpad
    [touchpad.kicad_pcb]
2026-08-27 created iqs9151 symbol
    [touchpad.kicad_pcb, touchpad.kicad_sch]
2026-08-27 modified QFN footprint of IQS9151
    [touchpad.kicad_pcb, touchpad.kicad_sch]
2026-08-27 trackpad or touchpad
    [touchpad.kicad_pcb]
2026-08-27 moved power pin of iqs9151
    [touchpad.kicad_sch]
2026-08-28 modified iqs footprint even more
    [touchpad.kicad_pcb]
2026-08-28 assigning pins
    [audio.kicad_sch, ddr.kicad_sch, meko.kicad_sch, sama.kicad_sch, touch_pad.kicad_sch, usb.kicad_sch]
2026-08-29 connect everything up (Almost)
    [power.kicad_sch, sama.kicad_sch]
2026-08-29 added buttons
    [buttons.kicad_sch, meko.kicad_sch, power.kicad_sch, sama.kicad_sch]
2026-08-30 assigned correct nets to vias
    [touchpad.kicad_pcb, touchpad.kicad_sch]
2026-08-30 positioned footprint, changed tracks to 0.15mm, moved vias to make drc happy for trackpad
    [touchpad.kicad_pcb]
2026-08-30 trackpad: removed soldermask openings for test pads
    [touchpad.kicad_pcb]
2026-08-31 looking over stuff, added caps
    [audio.kicad_sch, buttons.kicad_sch, ddr.kicad_sch, display.kicad_sch, meko.kicad_pcb, meko.kicad_sch, power.kicad_sch, sama.kicad_sch]
2026-08-31 added bq25640 footprint
    [meko.kicad_pcb, power.kicad_sch, sama.kicad_sch]
2026-09-03 touchpad: regenerated touchpad, made IQS7211E symbol
    [touchpad.kicad_pcb, touchpad.kicad_sch]
2026-09-03 touchpad: changed nets for col vias, removed mask opening for test pads
    [touchpad.kicad_pcb]
2026-09-03 touchpad: moved stuff around
    [touchpad.kicad_pcb]
2026-09-03 main board: removed touch_rst label
    [meko.kicad_sch, sama.kicad_sch, touch_pad.kicad_sch]
2026-09-04 started cleaning up schematic
    [audio.kicad_sch, buttons.kicad_sch, ddr.kicad_sch, display.kicad_sch, meko.kicad_sch, power.kicad_sch, sama.kicad_sch, sd.kicad_sch]
2026-09-04 main board: fixed schematic errors, made sama7 symbol better
    [ddr.kicad_sch, sama.kicad_sch, touchpad.kicad_sch, usb.kicad_sch, wireless.kicad_sch]
2026-09-04 main board: added no connect flags
    [sama.kicad_sch]
2026-09-04 mainboard: adde notes
    [sd.kicad_sch, touchpad.kicad_sch, usb.kicad_sch]
2026-09-04 mainboard: finished touchpad schematic
    [meko.kicad_sch, sama.kicad_sch, touchpad.kicad_sch, usb.kicad_sch]
2026-09-04 mainboard: reannotated schematic
    [audio.kicad_sch, buttons.kicad_sch, ddr.kicad_sch, display.kicad_sch, power.kicad_sch, sama.kicad_sch, sd.kicad_sch, touchpad.kicad_sch]
2026-09-04 mainboard: added sections to touchpad schematic
    [touchpad.kicad_sch]
2026-09-04 mainboard: removed wrong footprint from touchpad conn
    [touchpad.kicad_sch]
2026-09-04 mainboard: deleted footprint from pcb
    [meko.kicad_pcb]
2026-09-04 fixed issue
    [ddr.kicad_sch, power.kicad_sch]
2026-09-05 assigned missing footprints
    [meko.kicad_pcb, power.kicad_sch, sama.kicad_sch, touchpad.kicad_sch]
2026-09-05 updated BQ25640 with courtyard
    [meko.kicad_pcb]
2026-09-05 added a bunch testpoints
    [audio.kicad_sch, display.kicad_sch, meko.kicad_pcb, power.kicad_sch, sama.kicad_sch, sd.kicad_sch, touchpad.kicad_sch, usb.kicad_sch]
2026-09-06 removed testpoints on sd cards, since I can probe the pins there
    [audio.kicad_sch, ddr.kicad_sch, display.kicad_sch, meko.kicad_pcb, power.kicad_sch, sama.kicad_sch, sd.kicad_sch, touchpad.kicad_sch]
2026-09-06 added terminatino and pull-up to ram
    [ddr.kicad_sch, meko.kicad_pcb]
2026-09-06 added capacitor to sama ddr vref pin
    [audio.kicad_sch, buttons.kicad_sch, ddr.kicad_sch, display.kicad_sch, meko.kicad_pcb, power.kicad_sch, sama.kicad_sch, sd.kicad_sch]
2026-09-06 didn't save last time :sob:
    [audio.kicad_sch, buttons.kicad_sch, ddr.kicad_sch, display.kicad_sch, power.kicad_sch, sama.kicad_sch, sd.kicad_sch, touchpad.kicad_sch]
2026-09-11 wrote journal
    [power.kicad_sch]
2026-09-13 grouped pwr pins, made small improvements
    [sama.kicad_sch]
2026-09-14 added pullups for jtag
    [audio.kicad_sch, buttons.kicad_sch, ddr.kicad_sch, display.kicad_sch, power.kicad_sch, sama.kicad_sch, sd.kicad_sch, touchpad.kicad_sch]
2026-09-14 made sama footprint follow klc rules
    [meko.kicad_pcb, sama.kicad_sch]
2026-09-16 fixed small issues with footprint pad names
    [buttons.kicad_sch, meko.kicad_pcb, sama.kicad_sch, sd.kicad_sch]
2026-09-16 moved some caps to 0201
    [buttons.kicad_sch, ddr.kicad_sch, display.kicad_sch, meko.kicad_pcb, power.kicad_sch, sama.kicad_sch, sd.kicad_sch, touchpad.kicad_sch]
2026-09-16 changed pad sizes for ddr and mpu
    [meko.kicad_pcb]
2026-09-16 added solder mask expansion to mpu
    [meko.kicad_pcb]
2026-09-16 Revert "added solder mask expansion to mpu"
    This reverts commit ccd58d7e446aeba566a36254cdb1c9d3f458fca7.
    [meko.kicad_pcb]
2026-09-16 fixed 3.5mm footprint
    [meko.kicad_pcb]
2026-09-16 mucking around with layout
    [meko.kicad_pcb]
2026-09-16 added disaplay datasheet to schematic
    [display.kicad_sch]
2026-09-16 reorganized repo
    [bom.csv]
2026-09-17 added mockup freecad file
    [mekov3mockup.FCStd]
2026-09-17 updated mockup
    [mekov3mockup.FCStd]
2026-09-17 added helper sketches to mockup
    [mekov3mockup.FCStd]
2026-09-17 doing layout
    [meko.kicad_pcb]
2026-09-17 positioned buttons, jacks, and usb
    [meko.kicad_pcb, mekov3mockup.FCStd]
2026-09-17 more layour
    [meko.kicad_pcb]
2026-09-18 vendored in a bunch of footprints
    [audio.kicad_sch, ddr.kicad_sch, meko.kicad_pcb, sd.kicad_sch, usb.kicad_sch]
2026-09-18 added .05mm soldermask retraction for bgas
    [meko.kicad_pcb]
2026-09-18 set up board stackup
    [meko.kicad_pcb]
2026-09-18 changed stackup, creted tuning profiles, created net classes
    [audio.kicad_sch, ddr.kicad_sch, meko.kicad_pcb]
2026-09-19 more prep for routing
    [meko.kicad_pcb, sd.kicad_sch, wireless.kicad_sch]
2026-09-19 more chores
    [meko.kicad_pcb]
2026-09-19 worked on the pcb
    [meko.kicad_pcb]
2026-09-20 added lcsc part nr to display conn
    [display.kicad_sch, meko.kicad_pcb]
2026-09-20 Merged the two pcb libs into a single common lib
    [5034801000_0.stp, AUDIO-SMD_PJ-242_1.step, AUDIO-SMD_PJ-342-141.step, ESD441DPLR.stp, FBGA-178_L11.5-W11.0_K4E6E304EC-TL.stp, FBGA-96_L14.0-W8.0-H1.1-P0.8.step, KEY-SMD_L4.6-W3.4-H3.4.step, MAYA-W3_Emb-ANT.step]
2026-09-20 added touchpad conn
    [503480-0540.step, meko.kicad_pcb, touchpad.kicad_sch]
2026-09-20 added conn to trackpad pcb, updated mockup, placed conn
    [meko.kicad_pcb, mekov3mockup.FCStd, touchpad.kicad_pcb, touchpad.kicad_sch]
2026-09-25 first touchpad draft
    [touchpad.kicad_pcb, touchpad.kicad_sch]
2026-09-25 updated gnd fill
    [meko.kicad_pcb]
2026-09-26 added lra to touchpad
    [LRA.step, lra.FCStd, touchpad.kicad_pcb]
2026-09-27 laid out caps for vdd ddr, added custom rule area for bgas
    [ddr.kicad_sch, meko.kicad_pcb, power.kicad_sch, sama.kicad_sch, sd.kicad_sch, usb.kicad_sch, wireless.kicad_sch]
2026-10-04 ddr routing, and mucking around
    [ddr.kicad_sch, meko.kicad_pcb, sama.kicad_sch]
2026-10-04 removed ddr traces
    [meko.kicad_pcb]
2026-10-04 new layout for ram and mpu
    [meko.kicad_pcb]
2026-10-04 length matching
    [meko.kicad_pcb]
2026-10-04 more length matching
    [meko.kicad_pcb]
2026-10-04 lane 0 done
    [meko.kicad_pcb]
2026-10-04 smol changes
    [meko.kicad_pcb]
2026-10-04 started on lane1
    [meko.kicad_pcb]
2026-10-05 routed lane1
    [meko.kicad_pcb]
2026-10-05 matched lane1
    [meko.kicad_pcb]
2026-10-05 delay stuff
    [meko.kicad_pcb]
2026-10-05 some length stuff
    [meko.kicad_pcb]
2026-10-05 tmp moved mpu and ram outside of edge cut
    [meko.kicad_pcb]
2026-10-05 started addr cmd routing
    [ddr.kicad_sch, meko.kicad_pcb]
2026-10-06 routed ddr addr/cmd/clk
    [ddr.kicad_sch, meko.kicad_pcb, sama.kicad_sch]
2026-10-06 finished ddr routing
    [ddr.kicad_sch, meko.kicad_pcb]
2026-10-06 positioned ddr
    [meko.kicad_pcb]
2026-10-07 refilled zones
    [ddr.kicad_sch, meko.kicad_pcb]
2026-10-07 added lables
    [meko.kicad_pcb, sama.kicad_sch]
2026-10-07 layout and power routing
    [meko.kicad_pcb, power.kicad_sch]
2026-10-07 power layout
    [meko.kicad_pcb]
2026-10-08 gruling work
    [meko.kicad_pcb, sama.kicad_sch]
2026-10-12 clock, sdmmc, uart,
2026-10-18 updated edge cut
2026-10-19 added intra pair matchin to usb, moved mounting hole
2026-10-20 pcb final touches, preparing for review
2026-10-20 added notes to schematic
2026-10-20 plotted pcb
2026-10-21 chose pin functions
2026-10-21 added silkscreen
2026-10-21 more silkscreen
2026-10-21 added touchpad silkscreen
2026-10-21 updated version from 1.0 to 3.0 on schematics
2026-10-21 removed gnd via dams
2026-10-22 updated pcb with schematic fix
2026-10-26 more ddr, gnd return vias, gnd plane integrity
2026-10-30 moved gnd return vias around
2026-10-30 gnd plane
    idk why i'm commiting this often
2026-11-03 connected up all the ddr traces
2026-11-12 added back qr code to main pcb, small stuff
2026-11-12 started on cad
2026-11-12 added back lra 3d model to touchpad pcb
2026-11-12 worked on cad
2026-11-14 Update meko.kicad_pcb
    fixed jumper clearance
