KOEGlike/meko/(notices)

Notices in the files:
hardware/pcb_lib/SAMA7D65-4HB/Microchip_4HB_TFBGA-343_14x14mm_Layout21x21_P0.65mm.step:
Copyright (C) 2026, KiCAD
This work is licensed under the
[Creative Commons CC-BY-SA 4.0 License](https://creativecommons.org/licenses/by-sa/4.0/legalcode),
with the following exception:
project files under this or any other license agreement. However, if you wish to distribute
